xiaotang567/small_car/代码导读_small_car.md

# small_car 固件代码导读

> 目标板：STM32F407VGT6（立创梁山派/天空星引脚布局）+ 总钻风 MT9V034（无 51 版）+ 逐飞 WiFi6B21-SPI
> 当前状态：**188×120 二值图 + 八邻域双边巡线（左右边界数组发给上位机，PC 画红线）**，WiFi 图传稳定（0 坏行），SYSCLK = **168MHz**

---

## 0. 一眼看全：数据怎么流

```
        MT9V034 (188×120, 8bit 灰度)
              │  DCMI（硬件同步 / 8 位 / 极性组1）
              ▼
   cam_image[120][752]  ← DMA 环形缓冲，实际用 188B/行
              │  整块缓冲 = 90240B = 480 行 = 4 帧（cam_ring_rows）
              ▼
      board_cam_harvest()      每轮主循环都跑，突发补行
              │  4:1 纵向抽行（cam_dstep=4）
              ▼
      disp_img[120][188]       ← 显示用的"一整帧"，填满就冻住（bitmap 去重计数）
              │  board_cam_analyze()  采齐后调用一次
              ▼
   二值图(0/255) + cam_bound[120] / cam_bound_r[120]（八邻域爬出来的左右边界）
              │  WiFi SPI：整帧一包(0xFF) + 紧跟一包左右边界数组(0xFD)
              ▼
   PC: cam_view.py  → 拼帧显示；用板子发来的数组画**两条红线**（自己不再算边界）
```

**一句话**：摄像头 → DCMI/DMA 搬进环形缓冲 → 主循环"收割"成 120 行的一整帧 →
MCU 内二值化 + 八邻域双边巡线 → 整帧和边界数组分别发包 → 电脑只负责显示和画红线。

---

## 1. 文件职责

| 文件 | 行数 | 干什么 |
|---|---|---|
| `Core/Src/main.c` | ~1280 | **主循环 + 相位机 + 命令解析 + 心跳**（"调度中心"） |
| `Core/Src/board_f4.c` | ~2260 | **板级驱动**：时钟、DCMI/DMA/收割、SCCB、传感器配置、图像分析、LED |
| `Core/Src/wifi_f4.c` | ~620 | **WiFi 模块驱动**（SPI 协议，对照逐飞官方驱动移植） |
| `Core/Inc/board_f4.h` | ~313 | 板级宏与全局量（`BOARD_HSE_MHZ`、各种可调参数都在这里） |
| `Core/Inc/wifi_f4.h` | ~112 | **WiFi 的 SSID / PC IP / 端口**（网段变了就改这里） |
| `tools/cam_view.py` | ~560 | 上位机：解析包、拼帧、二值图显示、**用板子发来的左右边界数组画红线**、存日志 |
| `Core/Src/ctrl_f4.c` / `Core/Inc/ctrl_f4.h` | ~900 | **车模控制层**（2026-11-05 从 MSPM0G3507 工程移植）：电机 / 编码器 / 幻尔舵机 / MPU9250 / 速度 PID / yaw |

---

## 2. 启动流程（`main()` 里的顺序，别乱换）

```
HAL_Init()
SystemClock_Config()          ← CubeMX 生成的（HSI 16MHz，其实只是过渡）
board_clock_init()            ← ★ 真正的时钟：HSE(8M)+PLL → 168MHz；起不来退回 HSI+PLL 仍 168MHz
MX_GPIO_Init() / MX_DCMI_Init()
board_led_init()
board_cam_init()              ← DCMI + DMA 启动、极性、帧开始
wifi_f4_init()                ← 复位模块 → 连 WiFi → 连 TCP 上位机（**可能阻塞几十秒**）
while(1) { ... }              ← 相位机
```

⚠️ **`wifi_f4_init()` 会阻塞** ⇒ 任何"要很长时间"的代码都不要放在它前面（否则现象是"啥都不动 + WiFi 也连不上"，看不到卡在哪）。

---

## 3. 核心：主循环的相位机（`cam_tx_tick()`）

整个主循环只有 **三个状态**，全靠 `cam_phase` 这一个变量：

| 相位 | 干什么 | 退出条件 |
|---|---|---|
| **相 0「歇」** | 什么都不做，等够 `1000/fps` 毫秒 | 时间到 → 相干清零、进相 1 |
| **相 1「采」** | 专心等"一整帧填满"（`disp_done`） | 采齐 → 调 `board_cam_analyze()`、冻结、进相 2 |
| **相 2「发」** | 默认**整帧一包**（`z 0` 才退回逐行发） | 发完 → **紧跟一包边界数组(0xFD)** → 回相 0 |

### 三个关键设计（都是踩坑换来的）

1. **默认整帧一包**（2894B = 链路 1 个块），`z 0` 才逐行发
   ⇒ 每帧只有一个包开销 ⇒ 帧率上得去；`disp_hold` 在发完前一直冻着 ⇒ 不会发混合帧
2. **采齐才发，绝不超时硬发**
   ⇒ 不会出现"半新半旧的混合帧"（那种帧看起来像一条横线）
3. **自愈：只有"连续 1 秒没有任何新帧"才重启 DCMI**
   ⇒ 无条件每秒重启会把采集压到 1.2fps（亲身踩过）

---

## 4. 采集链（`board_f4.c`）

### 4.1 采集方式：连续 + 循环 DMA
DCMI 一直采，DMA 在 `cam_image` 里**转圈**，不做"采一帧停一下"。好处：
- 不用每次重启 DCMI（重启容易丢同步）
- 帧边界位置由**软件数行号**得到（不依赖 VSYNC 中断）

### 4.2 三个"行数"概念（最容易搞混，务必分清）

| 变量 | 含义 | 当前值 |
|---|---|---|
| `cam_row_bytes` | **摄像头一行多少字节** = 图像宽度 | **188** |
| `cam_span` | **一帧多少行**（回绕 = 帧边界） | **120** |
| `cam_ring_rows` | **环形缓冲能装多少行** = 90240 ÷ 188 | **480**（=4 帧） |

⚠️ 改任何一个都要连带检查另外两个的**使用点**（今天两次栽在这里）。

### 4.3 `board_cam_harvest()` —— 收割（每轮主循环必跑）
- `board_cam_write_row()` 算"DMA 现在写到第几行"
- 从上一行"追"到当前行，边追边拷进 `disp_img`（每 4 行取 1 行 = `cam_dstep`）
- **填行计数用 120 位位图去重**（不是 max/++）
  ⇒ 因为主循环是**突发补行**，一次补几十行，跨过回绕点也不会丢进度 ✓
- 填满 120 行 ⇒ **当场冻住**（`disp_hold=1`，`disp_done=1`）

### 4.4 关键函数

| 函数 | 作用 |
|---|---|
| `board_cam_init()` | 时钟/引脚/DCMI/DMA/极性 一次配好 |
| `board_cam_start()` / `board_cam_restart()` | 启动 / **Stop+Start 重启**（改传感器寄存器后必须调） |
| `board_cam_set_mode(1)` | 切"188 宽"模式：`row_bytes=188`、`span=120`、`dstep=1`、重启 DMA |
| `board_cam_new_pass()` | 新一轮：清计数+位图+标志（**只在相位机里调**） |
| `board_cam_write_row()` | DMA 当前行号（读 NDTR 换算） |
| `board_cam_pclk_khz()` | 借 TIM3 量 PA6 频率（判"传感器活没活/列 bin 生没生效"） |
| `board_vsync_hz()` | 借 TIM4 量 PB7 边沿（判"有没有在成帧"） |

---

## 5. 传感器配置链（SCCB）

### 5.1 总线
- **软件 SCCB**（开漏 + 上拉），挂在 **PC12 / PD2**
- `cam_sccb_init(swap)`：`swap=0` ⇒ SDA=PD2/SCL=PC12；`swap=1` ⇒ **SDA=PC12/SCL=PD2**
- **本板实测是 swap=1**（自动扫描结果 `CAM=2`）

### 5.2 协议（手册 P15~17，曾因写错白忙半天）
- 从机地址：**0x90 / 0x98 / 0xB0 / 0xB8 四个**（本板 **0xB8**）
- **寄存器地址是 8 位（1 字节）**，数据 16 位（2 字节）
- 读：`START + 地址W + 寄存器(1B) + STOP` → `START + 地址R + 高 + 低 + NACK + STOP`

### 5.3 自动探测（`cam_sccb_test()`）
2 种接线顺序 × 4 个地址 = **8 种组合全试**，读 R0x00，高字节 `0x13` 即认为成功。
⇒ 开机自动跑，**不用人敲命令**；成功结果写在心跳 `CAM= / ID= / N=` 里。

### 5.4 上电后自动配置（`cam_sccb_set_bin4()` + `cam_sccb_apply_flip()`）

| 寄存器 | 值 | 为什么 |
|---|---|---|
| `R0x0D` | **0x030A** | [3:2]=2 **列 bin4** + [1:0]=2 **行 bin4** ⇒ 输出 **188×120** |
| `R0x0B` | **150~200** | **快门（单位=行）**。行 bin4 后一帧只有 120 行，**出厂 443 会卡死不成帧** ⚠️ |
| `R0x0D` bit5/bit4 | 按需 | 左右镜像 / 上下翻转（命令 `n` 循环切换） |

⚠️ `R0x0E` 是 **Context B** 的 Read Mode（本芯片跑 Context A）⇒ **写它没用**（踩过）。

### 5.5 图像分析（`board_cam_analyze()`，全部在 MCU 内）
1. **Otsu**：256 级直方图 → 类间方差最大的阈值（自动适应明暗）
2. **二值化**：`≥T ⇒ 255`，否则 0（发出去的就是二值图）
3. **八邻域双边巡线**（`LF_USE_8NEIGHBOR=1`）：
   - `lf_find_seed()`：从下往上找**穿过中心列**的第一条白带（宽 ≥16）当种子，带滞后
   - `lf_trace_left_8()` / `lf_trace_right_8()`：从种子行出发，**向上 + 向下**都沿真实边缘爬
     （八邻域，每行记 `lf_real_l/r` 表示"这一行真爬到了"）
   - `lf_dual_fixup()`：左右互校正（宽度突变剔除 + 缺边补齐）
   - `lf_temporal()`：逐行 (3×本帧 + 上帧)/4 的时域平滑，抑制 1~2px 抖动
   - 结果留在 `cam_bound[]` / `cam_bound_r[]`（0xFF = 这一行没找到）
4. **不再往图里涂白标记**：边界数组由 `app.c` 打包发走，红线在上位机画（见 6.2）

---

## 6. 传输链（`wifi_f4.c`）

### 6.1 初始化（`wifi_f4_init()`）
复位 → 查版本/MAC/IP → 连 WiFi（SSID/密码）→ 连 TCP（PC IP / 8086）→ 设本地端口（6666）

### 6.2 三种报文
| 类型 | 结构 |
|---|---|
| **整帧包**（每帧 1 包） | `AA 55 A5 5A` + `0xFF` + 行数 + 极性\|0x80 + H + 长度(2) + 2 预留 + **120×24 字节位打包像素** + 校验和(2) = 2894B |
| **边界数组包**（紧跟整帧包） | `AA 55 A5 5A` + `0xFD` + 行数 + 预留 + H + 长度(2) + 2 预留 + **每行 2 字节（左x, 右x）** + 校验和(2) = 254B |
| **逐行包**（`z 0` 关掉整帧打包时才用） | `AA 55 A5 5A` + 行号 + W + 极性 + H + err/pin + 载荷 + 校验和(2) |

边界数组包的载荷：`0xFF` = 这一行没找到边界；行序号 0 = 画面最上面一行。
`app.c: cam_send_edges()` 在 `cam_tx_row_done()` 里、`disp_hold` 解冻**之前**发 ⇒
发出去的一定是"这一帧图像对应的那 120 对坐标"。

### 6.3 收发策略（各有一个坑）
- **发送**：`wifi_f4_send()` 先等模块"空闲"（INT 高），**等待上限 300µs**，超时就返回失败
  ⇒ 文字发送再重试 100 次（约 70ms 窗口）⇒ 保证回执能出去
- **接收**：`wifi_f4_read()` 也会**重试蹲空闲窗口**（8 次 × 200µs）
  ⇒ 原来"只试一次"被饿死过 ⇒ `RX` 恒 0，命令全部收不到

---

## 7. 上位机（`tools/cam_view.py`）

| 环节 | 要点 |
|---|---|
| 解析 | 找 `AA 55 A5 5A` → 读包头 → 按**类型字节**分派（`0xFF` 整帧 / `0xFD` 边界数组 / 其它逐行）|
| 拼帧 | `Frame.put(row, px)`，**收满 h 行才更新显示**（否则会看到"爬动的接缝"） |
| 整帧包 | `row == 0xFF` ⇒ 解位打包 → 逐行 `on_row()` → 收满 120 行拍快照并显示 |
| 边界数组包 | `row == 0xFD` ⇒ **校验和通过**才用 ⇒ `on_edges()` 存数组 + **force 重画**（不等 16ms 节流，线和图必须同一帧） |
| 画红线 | `edge_overlay()`：左右各连一条红线（相邻行差 ≤12 才连），每行点一个 S×S 红方块；`None` 行断开不瞎连 |
| 不做的事 | **不做左右转判断**（用户要求）：PC 只把板子给的线画出来 |
| 日志 | 所有文本写 `cam_log.txt`（**排查"到底谁没发"的最终裁判**）|

---

## 8. 命令与心跳字典

### 8.1 命令（发一行文字，回车）
| 命令 | 作用 |
|---|---|
| `f <n>` | 帧率（0 = 不限） |
| `e <n>` | **曝光**（R0x0B 行数，10~110） |
| `n` | 翻转循环：不翻 → 左右镜像 → 上下 → 180° |
| `g <ms>` | 每行发送间隔 |
| `m <0/1>` | 采集模式（0=752 宽 / 1=188 宽） |
| `s` / `a` / `?` | 回状态 / 恢复默认 / 帮助 |
| `d 0/1/2` | 心跳档位（2 = 全量诊断） |
| `b/v/c/i/p/t` | **旧的 UART 配置**（带 51 的摄像头才用，本机忽略） |

### 8.2 心跳 `S ...` 字段
```
S f= V= VS= LG= TO= F= FL= P= RX= CAM= ID= N= MD= BIN= R0D= W= E= K= R= IE= MI= LW= GP= FW=2060 RST=
```
| 字段 | 看什么 |
|---|---|
| `f` | DCMI 帧计数（**要涨**） |
| `F` | 冻结时填了几行（**=120 才对**） |
| `LG` | 收割滞后行数（应远小于 480） |
| `C` | `DCMI->CR`（正常 `4021` = ENABLE+CAPTURE+极性1） |
| `W` | DMA 当前行号（**不变 ⇒ DCMI 没在搬**） |
| `CAM/ID/N` | SCCB 探测结果（`2` + `1324` = 成功） |
| `MD/BIN/R0D` | 模式 / 188×120 配置 / ReadMode 回读（`030A`） |
| `K` | PA6 实测像素时钟（≈1134kHz 正常） |
| `R` | DCMI RISR（FRAME 位应周期性置位） |
| `GP` | 软件数出来的帧率（LINE 间隔识别帧首） |
| `FW` | 固件标签（**2059 及以前没有 0xFD 边界数组包**） |

### 8.2b 状态行 `CFG ...`（敲 `s` 或开机）
```
CFG f= g= x= y= (188x120) d= CST= RV= LINE= FW=2060 EDG= EL= ER=
```
- **`EDG`** = 已经发出去几包边界数组（0xFD）。**在涨 ⇒ 新固件在发数组** ✓
- **`EL` / `ER`** = 最近一包里左 / 右边界各有几行有效（120 = 整幅都爬到了）✓

### 8.3 诊断行 `CAM1 ...`
```
CAM1 f= er= CR= ND= SR= RIS= AFD= DEN= PF= V2= CLK= MHz=
```
- `ND` 钉死 = 一个字节都没搬
- `AFD` = 哪几根 DCMI 引脚没配成 AF13（0 = 全对）
- `V2` = PB7 的 VSYNC 边沿率（0 = 没成帧）
- **`CLK`** = 时钟来源（1=HSE / 2=退回 HSI）+ `MHz` = 实际主频（应为 168）

---

## 9. 调参入口（都在 `board_f4.h` / `main.c` 顶部）

| 参数 | 位置 | 说明 |
|---|---|---|
| `BOARD_HSE_MHZ` | `board_f4.h` | 晶振 8 或 25（**必须和实物一致**，且 `HSE_VALUE` 要同步改） |
| `WIFI_SSID / WIFI_PC_IP / WIFI_PC_PORT` | `wifi_f4.h` | 网段变了改 IP |
| `cam_shutter` | `board_f4.c` | 曝光（默认 150） |
| `cam_flip` | `board_f4.c` | 翻转模式 |
| `cam_cmd_fps / cam_cmd_gap_ms` | `main.c` | 帧率 / 每行间隔（决定传输耗时） |
| `CAM_H / CAM_TXW / CAM_W` | `board_f4.c` | 显示高/宽/缓冲宽（改分辨率就动这里） |

---

## 10. 以后加电机/PID 往哪写

主循环现在是"相位机占满"，加控制建议这样插：

```c
while (1)
{
    ...
    board_cam_harvest();     // 必须每轮跑（时序敏感）
    cam_cmd_poll();          // 必须每轮跑（命令要快）
    cam_tx_tick(...);        // 相位机：发图
    motor_control_tick();    // ★ 新增：电机控制（按 ms 节流，别阻塞）
    ...
}
```

⚠️ 三条铁律：
1. **不要在主循环里做 >1ms 的阻塞操作**（会漏行，`LG` 会飙）
2. 电机 PWM 用 **TIM2_CH3/CH4（PA2/PA3）**，和 DCMI 完全不冲突 ✓
3. 编码器用 **TIM5**（32 位），别用 TIM3/TIM4（要给频率探针留着）

---

## 11. 踩过的坑（浓缩成 12 条规则）

1. **协议要逐字照手册核**（SCCB 是 8 位寄存器地址、四个从机地址）
2. **同名寄存器要连 Context 一起读**（`R0x0D`=A / `R0x0E`=B）
3. **改帧结构要连带所有"以行为单位"的参数**（曝光 443 > 帧长 120 ⇒ 卡死不成帧）
4. **一个概念多处使用时，grep 逐处核对**（行宽 / DMA 长度 / ring_rows）
5. **热路径所有等待必须有上界**（`wait_idle(1000)` 会把主循环按死 1 秒）
6. **发和收要对称重试**（发送重试 40 次、接收只试 1 次 ⇒ 接收被饿死 ⇒ `RX=0`）
7. **自检/自愈必须能自动退场**（`float_probe` / 极性轮换 / 每秒量时钟 / 每秒重启，全是自扰）
8. **"平均类"指标对内容级问题瞎**（用块匹配/相邻相关查重复和接缝）
9. **宁可这一轮不发，也不发混合帧**
10. **关键状态要周期化广播**（"开机瞬间发一次"必丢 ⇒ 放进心跳）
11. **日志文件是"到底谁没发"的最终裁判**（`cam_log.txt` / `netstat`）
12. **改时钟后要重新标定所有空转式软件延时**（SCCB / WiFi 微秒延时）

---

## 12. 2026-11-03 分割线定案：整帧拷贝 + PCLK 门控（硬件）

### 12.1 现象
188×120 画面上有一条**固定高度的横线**（实测在 120 行里的第 43 行）：下方 77 行是新的，
上方 43 行还是上一帧。换极性组时线的位置/形态会变（第 1 组出图但有缝，第 3 组整幅斜）。

### 12.2 软件侧根因（已修）
旧采集是"主循环逐行收割"：一帧 120 行必须在**一个 VSYNC 周期（20ms）内**扫完。
主循环被 WiFi/命令/分析占住几毫秒，就只扫到 70~90 行 ⇒ 下一个 VSYNC 一清计数，
剩下的行就留着上一帧 ⇒ 固定高度的分割线。
⇒ 现在 188 模式改成 **VSYNC 对齐 + 整帧拷贝**：
  - `board_cam_poll()` 只认 **VSYNC 电平上升沿**（FRAME 标志会被 HAL 中断抢走，时刻不固定）；
  - `cam_frame_boundary()` 记下帧首行号；下一次 VSYNC 时把**上一帧 120 行一次性 memcpy**
    进 `disp_img`（约 0.2ms，环里能存 4 帧 ⇒ 绝不会拷到一半被覆盖）；
  - 100ms 没见到 VSYNC 时自动退回"每 120 行滑窗"兜底（不会黑屏，但可能仍有缝）。
  - `CAM_POL_ROTATE` 改为 **0**，固定第 1 组，不再每 0.8s 改一次 DCMI->CR。

### 12.3 最终方案（2026-11-03 21:00，FW=2055，硬件保持不动）
DCMI 自己的 VSYNC 标志一直拿不到（`MI=0000`），但**行中断是正常的**，于是用"行间隔"自己找帧首：

- `HAL_DCMI_LineEventCallback()`：每行结束记一次 DWT 周期数；两行间隔从 ~130µs
  突然变长（场消隐）⇒ 这就是新一帧的第一行 ⇒ 调 `cam_frame_boundary()`；
- 实测 `GP`（识别到的场消隐次数）≈ 帧率（30~70/s）、`FL≈120` ⇒ 帧首对齐成功；
- `board_cam_start()` 末尾**重写一次极性**：`cam_dcmi_force_stop()` 会把 `DCMI->CR` 清 0，
  而 `HAL_DCMI_Start_DMA()` 只补 ENABLE+CAPTURE、**不补 PCKPOL/HSPOL/VSPOL**
  ⇒ 切 188 模式重启后 CR 会掉成 `0x4001`（极性 0）⇒ 现在统一补回 `0x4021`；
- **CROP 默认关闭**（`cam_crop_on=0`）：开了 CROP 后 DCMI 抓完一个窗口就等 VSYNC，
  而 VSYNC 收不到 ⇒ DMA 停在 22560 ⇒ 电脑只收到一张就冻结（实测踩到）；
- TIM6 轮询 `DCMI->SR` 的方案已停用（SR 位在消隐期不更新，`VS` 恒 0），代码保留但不再调用。

### 12.4 看心跳判读（FW=2055）
```
S f= V= VS= LG= TO= F= FL= P= ... LW= GP= FW=2055
```
- `GP` = 场消隐识别次数：≈ 帧率（30~70/s）⇒ **帧首对齐正常**；
- `FL` = 帧长：120 正常；
- `LW` = LINE 中断次数：≈ 120×帧率；
- `V` = DCMI 自己的 VSYNC 中断：可能仍是 0（不影响 LINE-间隔方案）；
- `VS` = TIM6 轮询方案（已停用）恒 0；
- `K` = PCLK 实测：一次开机量一次，仅供参考（1134/1522/5030 都见过，和测量时机有关）。

---

## 13. 2026-11-05 双边巡线：边界数组发给上位机，PC 画红线（FW=2060）

### 13.1 用户的要求
> 用 **8 邻域算法做双边巡线**，把拿到的点**用数组发给上位机**，上位机拿数组**画红线**；
> 左右转之类的判断**先不做**。

### 13.2 板子侧（`cam_f4.c` + `app.c`）
| 位置 | 做什么 |
|---|---|
| `board_cam_analyze()` | Otsu 二值化 → `lf_find_seed` → `lf_trace_left_8` / `lf_trace_right_8`（向上+向下双向八邻域爬）→ `lf_dual_fixup` → `lf_temporal` ⇒ 结果在 `cam_bound[]` / `cam_bound_r[]` |
| `cam_f4.c` | **删掉**"在边界外侧涂 3 像素白"的 `lf_draw_edge_marks()`（那两个竖长方形就是它造成的；红线交给 PC 画，板子保持纯二值图） |
| `app.c: cam_send_edges()` | 整帧包发完后**紧跟一包 0xFD**：每行 2 字节（左x, 右x），0xFF = 没找到；240B + 包头 12 + 校验 2 = **254B** |
| `app.c: cam_tx_row_done()` | 在 `disp_hold = 0` **之前**调 `cam_send_edges()` ⇒ 发出去的一定是这一帧图像对应的坐标 |
| `cmd_f4.c` | `CFG` 状态行加 `FW=2060 EDG= EL= ER=`（确认新固件 + 数组包在发 + 左右各爬到多少行） |

### 13.3 PC 侧（`tools/cam_view.py`）
- 解析器按包头**类型字节**分派：`0xFF` 整帧（位打包 24B/行）、`0xFD` 边界数组、其它逐行（老格式）；
- `0xFD`：校验和通过 ⇒ `on_edges()` 存数组 ⇒ **force 重画**（跳过 16ms 节流，保证"图和线同一帧"）；
- `edge_overlay()`：左右各连一条红线（相邻行差 ≤12 才连），每行点一个 `S×S` 红方块；
  某行是 `None` ⇒ 红线**断开**，不会瞎连一条横跨画面的线；
- **不再自己扫边界**（原来 PC 有一套"从中间往左扫 + 上行±20"的算法，和板子实际用的边界不是同一条线）；
- **不做左右转判断**（用户要求），窗口标题显示 `边包 N (L120/R118)` 可确认收到了几个包。

### 13.4 怎么判断这版生效
1. 敲 `s` ⇒ `CFG ... FW=2060 EDG=<在涨> EL= ER=`；
2. PC 窗口标题右侧 `边包 N (L…/R…)` 在涨；
3. 画面上出现**两条红线**，贴着赛道的左右边；近场（画面下方）也贴着真实边缘走。

### 13.5 2026-11-05 晚：卡死自愈（"运行一段时间图像卡住"）
| 位置 | 改了什么 | 为什么 |
|---|---|---|
| `app.c` 相 2 | **发送看门狗**：一帧超过 `300ms + 行数×gap×2` 还没发完 ⇒ 主动放弃这一帧、解冻收割、回相 0 | 以前 `wifi_f4_send()` 一直失败就**永远重试**，而 `disp_hold` 一直是 1 ⇒ 收割永久停住 ⇒ 画面**永久定格**（只能复位）|
| `app.c` 相 1 | 1 秒没有新帧时**顺手 `disp_hold = 0`** | 万一上面那个冻结状态残留在相 1，也一定解得掉 |
| `cmd_f4.c` | `CFG` 加 `DRP=`（被看门狗放弃的帧数） | 偶尔涨是正常；一直飙 ⇒ 链路/模块发不动 |
| `cam_view.py` | 解析提成 `parse_stream()`，外面套 try/except | 解析里**任何异常**都不会再弄死收数线程（以前一个异常 ⇒ 窗口还在、图永远不动）|
| `cam_view.py` | **先验包长再等数据**（`0xFF` 的 flen 必须是 24 的倍数且 ≤480 行；`0xFD` 的 elen 必须是 2 的倍数） | 错位时假魔数会报出 6 万多字节的长度 ⇒ 一直等一个永远来不齐的包 ⇒ 看起来就是卡死 |
| `cam_view.py` | `tick()` 看门狗：**链路还在进字节、却 3 秒没拼出完整帧** ⇒ 丢缓冲、重找魔数（`RS` 计数） | 兜底自愈，不用重启上位机 |
| `cam_view.py` | 新帧**先不画**，等 0xFD 边包到了"图+红线一起画"（最多等 80ms） | 每帧少一次 GUI 重绘；也不会闪一下旧红线 |
| `cam_view.py` | 每 10 秒**无条件**打一行 `[统计] 帧/无新帧/B\/s/重同步` | 卡住时的判据：`B/s=0` ⇒ 板子没发；`B/s>0` ⇒ 上位机丢同步（会自己恢复）|
| `cam_view.py` | 排查时曾把文本行上限临时放到 240、并在连上后自动发一句 `s`；**查完已撤销**（回到 130 + 不自动发） | 那行 200 字符的 `S ...` 心跳会被 130 的限制整行丢掉 —— 排查"DMA 停摆"时就是靠临时放宽才看见的 |

### 13.6 2026-11-05 晚2：真凶 —— **DMA 停摆**（`ND=22560` 钉死）
用户烧了固件后报"上位机收不到图片"，`CAM1` 每秒打一条：
```
CAM1 f=2196 er=0 CR=4021 ND=22560 SR=0000 RIS=0000 AFD=000 DEN=1 PF=1134k ...
```
判读：
- **`ND`（DMA 剩余字数）恒等于 22560** ⇒ **DMA 一个字节都没搬**（正常在 1..22560 之间乱跳）；
- `f` 每秒只涨 ~10：不是真帧率 —— DMA 不动 ⇒ `board_cam_write_row()` 恒定 ⇒
  `cam_frame_boundary_at()` 算出的帧长恒 0 ⇒ 走 `len<90` 的早退；
  只有 100ms 后 `recent=0` 才走到 `else` 分支 `cam_frame_cnt++` ⇒ **假的 10/s**；
- ⇒ `disp_done` 永远不置位 ⇒ 一张帧都拼不出来 ⇒ **上位机没图**（这也解释了之前"卡住"）。

处理（FW=**2061**）：
| 位置 | 改动 |
|---|---|
| `cam_f4.c: board_cam_poll()` | **DMA 停摆看门狗**：NDTR 连续 400ms 一动不动（且 `cam_mode==1`）⇒ `board_cam_restart()`，计到 `cam_dma_stall` |
| `app.c: cam_tx_tick()` 相 1 | **采集自愈**：连续 2 秒没看到 `disp_done` ⇒ `board_cam_restart()`，计到 `cam_self_heal` |
| `cmd_f4.c` | `CFG` 追加 `DST=`（DMA 停摆重启次数）、`SELF=`（2 秒无帧重启次数）⇒ 正常都应恒 0 |

判读：`DST`/`SELF` 在涨而画面恢复 ⇒ 自动救回来了；一直涨且没图 ⇒ 采集链（传感器输出/接线）真有问题。

---

## 14. 2026-11-05 从 MSPM0G3507 工程移植车模控制层（FW=2062 → 2067）

### 14.1 为什么要有这一节
用户原本用 MSPM0G3507（逐飞库）做车：电机 / 编码器 / 舵机 / 陀螺仪都调通了，
但**那颗片子做不了摄像头**，所以换到 STM32F407。摄像头链路（第 12/13 节）已经稳定，
这一节把原来那套**车控代码**搬过来。

原工程：`...\MSPM0G3507_Library-master\...\Example\Coreboard_Demo\E01_gpio_demo\user\`
（`motor.c` / `encoder.c` / `speed_ctrl.c` / `hx_servo.c` / `mpu9250.c` / `yaw.c`）

### 14.2 新板引脚（嘉立创已打板）
| 功能 | 引脚 | 外设 |
|---|---|---|
| 电机1 / 电机2 PWM | PA2 / PA3 | TIM2_CH3 / CH4（**必须同一个定时器才同频**）|
| 电机1 / 电机2 方向 | PB0 / PB1 | GPIO |
| 编码器 A / B / Z | PA0 / PA1 / PC0 | TIM5_CH1/CH2（编码器模式）/ EXTI0 |
| 幻尔舵机 TX / RX | PC10 / PC11 | UART4，**1Mbps** |
| MPU9250 SCL / SDA | PB8 / PB9 | 软件 I2C |
| OLED SCL / SDA | PB10 / PB11 | 软件 I2C |
| 蜂鸣器 / 按键 | PC1 / PC2、PC3 | GPIO |

⚠️ **DCMI 避让**：TIM3_CH1(PA6)、TIM4_CH1(PB6)、TIM8_CH1(PC6) 全撞摄像头引脚 ⇒
电机只能用 TIM2、编码器只能用 TIM5 —— 这是整套分配的核心权衡。

### 14.3 驱动实现要点（`ctrl_f4.c`）
| 模块 | 要点 |
|---|---|
| 电机 | TIM2 17kHz（84MHz/(4940+1)），占空比 ±10000，DIR 高=正转；**上电先 PWM=0、DIR=0** |
| 编码器 | TIM5 **SMS=011 编码器模式 3**（A/B 每个边沿都数 ⇒ 4 倍频），32 位；**输入滤波 IC1F/IC2F=0110**（原工程 QUAD 没滤波踩过"正反抵消、转速恒 0"）|
| 测速 | 20ms 软件节拍：读 CNT → 清 0 → `RPM×10 = ΔN×600000/(CPR×20)`（**int64**，原工程踩过 int32 溢出）|
| 速度环 | 前馈(5000/1000RPM) + P(1.5) + I(0.15，限幅 2500)，斜坡 3000RPM/s，上限 50%，极性自动识别 |
| 舵机 | 幻尔协议 `FF FF ID LEN INSTR P.. CS`；**改成非阻塞**：发送走环形缓冲 + TXE 中断，接收走 RXNE 中断 + 20ms 解析（原工程是轮询死等，一次几十 ms，会把摄像头主循环按住）|
| 舵机上电 | 等 1 秒 → 写一次 0x2E 目标速度（保持型寄存器）→ 摆到中位 2048 |
| MPU9250 | 软 I2C（PB8/PB9 开漏，半周期 2µs ≈ 250kHz），20ms 读 14 字节；WHO_AM_I 不认识就不再读 |
| yaw | 4 点滑动平均 → 零偏标定（1 秒）→ 80LSB 死区 → 20ms 积分，`deg += rate×0.02/131` |
| 节拍 | `board_ctrl_tick()` 由 `app_loop()` 每轮调，内部 20ms 节流；**绝不阻塞** |
| 中断 | `UART4_IRQHandler` / `EXTI0_IRQHandler` 在 `stm32f4xx_it.c` 转发，优先级 6/7（低于摄像头） |

### 14.4 调试命令（走原来的 WiFi 文本通道，看第 8 节）
```
q <rpm>        速度环目标（0 = 停）          w <d1> <d2>   开环直接给两个电机占空比
r <pos>        舵机位置 0..4095（2048 中位）  l             编码器累计清零
h              一行汇总：enc/d/rpm/yaw/ready/state/duty/servo/err/who
```

### 14.5 上车前必须标定（顺序别乱）
1. **CPR**：不动舵机，手动把轮子转整一圈，看 `h` 里的 `enc` 涨了多少 ⇒ 改 `CTRL_ENC_CPR`（默认 4096）
2. **方向**：`w 2000 0` 看轮子转向；反了就换电机线或改 `CTRL_M1_DIR_INV`；编码器符号反了改 `CTRL_ENC_DIR_INV`
3. **速度环**：从 `q 300` 开始，看 `h` 里的 `rpm`；超调先减 Kp，稳态到不了就加 Ki
4. **舵机**：先 `r 2048` 确认中位，再试两边，**确认机械限位没被顶住**（限位宏 `CTRL_SERVO_POS_MIN/MAX`）

### 14.6 和摄像头共存的三条规矩
1. 控制相关的一切都**不许阻塞**（舵机发送走中断、IMU 一次 0.3ms、其余纯运算）；
2. 控制中断优先级**必须低于**摄像头（DCMI/DMA 是 0~2，这里用 6/7）；
3. 新增控制代码**不许碰** DCMI 那 11 根引脚、DMA2_Stream1、PB7。

### 14.7 OLED（FW=2063）
- 硬件：4 针 SSD1306 128×64，**SCL=PB10 / SDA=PB11**（I2C2 那对脚，但本工程没开 HAL 的 I2C 模块 ⇒ **软件 I2C**）
- 地址：先试 **0x3C**，不应答再试 **0x3D**（两种批次都有）
- **不占 RAM 显存**：直接按"页(page) + 列"写，没有 1KB framebuffer（这个工程只剩 2.4KB RAM）
- API：`ctrl_oled_init()` / `ctrl_oled_clear()` / `ctrl_oled_text(x, page, "str", scale)` / `ctrl_oled_hello()`
  （`scale=1` → 6×8 字体，`scale=2` → 12×16 占两页；字体 5×7 ASCII 32~126 已内置）
- 不亮时先查：模块是不是 4 针 I2C 版、`0x8D 0x14` 电荷泵有没有发出去、地址是 0x3C 还是 0x3D

### 14.8 OLED 状态页（FW=2064）
开机显示 4 行状态（2 倍字，每行占两页）：

| 页 | 内容 | 说明 |
|---|---|---|
| 0-1 | `WiFi OK` / `WiFi --` / `WiFi E<n>` | `--` = 初始化中；`E1` 模块没应答 / `E2` 连不上热点 / `E3` 连不上上位机 |
| 2-3 | `MPU OK` / `MPU <WHO_AM_I>` | `MPU 00` = 压根没读到（查接线/上拉）|
| 4-5 | `ENC 01234` | 编码器累计计数（取模 100000，补零）|
| 6-7 | `RPM  123` | 当前转速（`enc_rpm_x10/10`，带符号）|

实现要点：
- `ctrl_oled_status()` 在 `board_ctrl_tick()` 末尾调用；
- **内容没变就不重画**（`strcmp` 比较 + dirty 位）；
- 每行补空格到 **10 字符 = 120 像素** ⇒ 长度恒定，不会留鬼影；
- 没有 OLED（0x3C/0x3D 都不应答）⇒ `g_oled_ok=0`，状态页整个跳过。

### 14.9 修：状态页"等 30 秒才出现"（FW=2065）
**现象**：上电后屏幕一直停在 `hello world`，差不多 30 秒后才变成状态页。

**根因**（不是 OLED 的错）：`ctrl_all_init()` 在 `wifi_f4_init()` **之前**调用，
而后者要复位模块 → 连热点 → 连 TCP，最长**阻塞几十秒**；
在它返回、`app_loop()` 跑起来之前，`board_ctrl_tick()` 根本没执行过 ⇒ 状态页当然不刷新。

**改法**：
1. 去掉 "hello world" 那 1 秒，改成**开机就在 `ctrl_all_init()` 里整页画一次**
   （`ctrl_oled_first_page()`，4 行全画 ≈ 34ms）⇒ 上电立刻能看到；
2. WiFi 那行增加中间态 `WiFi --`；
3. 之后主循环跑起来，`ctrl_oled_status()` 才做增量刷新。

⚠️ 教训：**凡是"要等主循环跑起来才会更新"的东西，都不能当成开机自检画面** ——
先查 `main()` 里在那之前有没有阻塞调用。

### 14.10 OLED 刷新提速（FW=2066）
| 问题 | 原来 | 现在 |
|---|---|---|
| 软 I2C 太慢 | 半周期 2µs ⇒ 250kHz，一行两页 ≈ **8.6ms** | 半周期 **1µs** ⇒ 约 450kHz，一行 ≈ **4ms** |
| 文字更新太慢 | **4Hz**（250ms） | **10Hz**（100ms）|
| 补画排得太保守 | 每 20ms 拍只画 **1 行** ⇒ 4 行要 80ms | **一次把脏行全画完**（最多 4 行 ≈ 16ms）|

参数：`CTRL_OLED_I2C_DELAY_US`（1，花屏就改回 2）、`CTRL_OLED_TEXT_MS`（100）。
摄像头环形缓冲能存 80ms，16ms 的阻塞不会丢帧；正常只有 ENC/RPM 两行在刷。

---

## 15. 2026-11-06 控制台 `tools/car_ui.py`（图像 + 仪表 + 按钮）

### 15.1 全按钮，不用敲命令
| 区块 | 控件 |
|---|---|
| 图像源 | **[二值图]** **[原图灰度]** 两个按钮（选中变绿），下面一行显示当前模式 |
| 实时数据 | 转速（大字）/ 加速度 / 角速度 / 偏航角 / 舵机位置（10Hz，断流 2 秒变 `---`）|
| 电机1 | 两种方式二选一：**占空比 %**（默认，滑条 0~100，默认 **30%**，开环不依赖编码器）/ **转速 RPM**（走速度环闭环）<br>**[启动] [停止]**（上电默认停）+ **[前进]/[后退]** 只选方向 + 快捷档（10/20/30/50% 或 300/600/1000/1500 RPM）+ 滑条（松手才发）|
| 舵机角度 | **[左] [中] [右]** + **[−20] [+20]** + 滑条（松手才发）|
| 其它 | **[编码器清零]** **[紧急停止]**（红）|
| 日志 | 底部显示板子的 `ACK/CFG/CAM` 回话；界面标签里**不出现任何命令语法** |

按钮按下后固件收到的还是原来那几条命令（`s 0/1`、`q <rpm>`、`r <pos>`、`l`、`w 0 0`），
只是用户完全不用知道它们。

用法：**双击 `tools/run_car_ui.bat`**（自动找 Python 并监听 8086），或 `python car_ui.py [端口]`。
和 `cam_view.py` 一样是 TCP 服务端，**两个别同时开**。

⚠️ 电机安全：**上电默认停止**（固件里速度环目标 = 0、PWM = 0），上位机也默认"未启动"。
点 **[启动]** 才按"方式 × 方向 × 滑条值"驱动电机1：
- **占空比**方式发 `w ±(滑条%×100) 0`（30% → 3000，开环，不依赖编码器）
- **转速**方式发 `q ±RPM`（闭环，需要编码器读数正确）
点 **[停止]** 或 **[紧急停止]** 会同时发 `q 0` 和 `w 0 0`（两路占空比直接清零，双保险）。
方向按钮本身**不发命令**，只是选方向；运行中改方向会立刻按新方向重发。
切换方式时会先把手头那个方式清零（PWM→RPM 发 `w 0 0`，RPM→PWM 发 `q 0`）。

### 15.2 为此新增的两条协议
**① 灰度缩略图包（0xFC）** —— 只在 `cam_view_mode=0`（原图模式）时发
```
AA 55 A5 5A | 0xFC | 块号 | 0 | 本块行数 | 长度高 低 | 2B 预留 | 数据 | 校验高 低
```
- 数据 = `disp_img`（188×120 灰度）**2×2 抽取** ⇒ 94×60，**分 8 块**（每块 94×8 = 752 字节）
- **为什么分块**：整张 5640 字节超过 WiFi 模块一次 SPI 事务上限 4088，一次发不完就是半个包 ⇒ 字节流错位
- **为什么必须在 `board_cam_analyze()` 之前发**：分析会把 `disp_img` **原地二值化**，发晚就拿不到灰度了
- 原图模式下**不走相 2**：灰度包在相 1 里一次发完（约 30~50ms，此时 `disp_hold=1` 收割冻着），发完直接回相 0

**② 遥测行（10Hz 文本）**
```
T r=<转速RPM> ax= ay= az= gx= gy= gz= <原始LSB> y=<偏航角, 单位0.1°> s=<舵机位置> m=<图像模式>
```
`m=1` 二值图 / `m=0` 原图；上位机只按 `key=value` 取，加字段不用改解析骨架。

### 15.3 固件命令新增
```
s           回状态（原来就有）
s 0         原图（灰度 94×60）
s 1         二值图（188×120，默认）
```

### 15.4 注意
- 原图模式带宽是二值的 **2 倍**（5640B vs 2894B/帧）⇒ 帧率会掉一半左右，这是正常的；
- 灰度只有 94×60，**看曝光/阈值够用，看细节不行**；要细节还是用二值图；
- 上位机切换时会先切显示再发命令，不然要等遥测回来才变；
- 板子没烧这版固件时：图像正常、仪表全是 `---`、点"原图"没反应 —— 属正常（没有 0xFC/T 包）。
