xiaotang567/small_car/舵机读取问题说明.md

# 舵机读取问题说明

> 文档目的：把「舵机位置一直读不到」这件事**说清楚** —— 现在的现象是什么、已经用证据确认了什么。
> 编写时间：2026-11-06　对应固件：**FW=2095**（`MDK-ARM/small_car/small_car.hex`）

---

## 0. 一句话概括

**单片机确实按官方协议、以 1 Mbps 把「读当前位置」的帧发到了总线上，但一个应答字节都没有收回来；而同一套舵机和调试板接电脑时能正常读出位置。**

---

## 1. 硬件与参数（当前配置）

| 项目 | 内容 |
|---|---|
| 舵机 | 幻尔 **HX-10HM** 磁编码总线舵机（12 位，0~4095 对应 0~360°）|
| 舵机默认 ID | **1**（出厂值，手册第 5 页；ID 范围 0~253）|
| 舵机供电 | 独立 12V（9~12.6V），与板子**共地** |
| 调试板 | 幻尔 **BusLinker V3.0**，跳线帽置于 **Servo + TTL** |
| 单片机侧 | STM32F407，**PC10 = UART4_TX，PC11 = UART4_RX**（AF8）|
| 波特率 | 1 Mbps（协议文档 + 规格表 + 官方例程）|
| 协议 | `FF FF ID LEN CMD 参数… CS`，`CS = ~(ID+LEN+CMD+参数…)` |

### 读位置的帧（固件实际发出的，和官方文档逐字节一致）

```
发送：FF FF 01 04 02 38 02 BE      ← 读 ID1 的 0x38 寄存器 2 字节
应答：FF FF 01 04 00 18 05 DD      ← ERROR=0，位置 0x0518 = 1304
```

校验和验算：`~(0x01 + 0x04 + 0x02 + 0x38 + 0x02) = ~0x41 = 0xBE` ✓
（出处：《幻尔HX-10HM总线舵机通信协议文档》1.3.2 节，第 3 页）

---

## 2. 现在的现象（当前固件 FW=2095）

| 观察点 | 读数 | 说明 |
|---|---|---|
| 上位机「舵机」行 | `--- (ID 1, 1M, 发xxB 收0B 校验错0)` | **发得出去，收不回来** |
| `发` / `st` | 持续增长（每秒几十字节）| 发送环 + TXE 中断 + UART4 正常工作 |
| `收` / `sr` | **0** | RXNE 中断一次都没被触发（或确实没有电平变化）|
| `校验错` / `sb` | 0 | 没有收到"错误的数据"，是一个字节都没有 |
| 舵机动作 | 无 | 说明舵机也没收到合法指令（否则会转动/绷紧）|
| 电脑读舵机 | **正常**，能读到 ID 和位置 | 舵机、舵机线、BusLinker、12V 供电都正常 |

---

## 3. 已确认的事实（都有实测证据）

| # | 结论 | 证据 |
|---|---|---|
| 1 | 舵机本体、舵机线、BusLinker 的 USB 通路、12V 供电**都正常** | 用电脑 + ServoStudio/BusLinker 能正常扫描到舵机并读到位置 |
| 2 | 单片机 UART4 的**发送**通路正常 | `发/st` 计数随每次读位置稳定增长 |
| 3 | 单片机 UART4 的**接收**通路正常 | 把 **PC10 与 PC11 直接短接**做回环，`收` 立刻从 0 涨到 200B 左右 |
| 4 | 发送的**帧内容正确** | 与协议文档 1.3.2 的示例逐字节一致（含校验和 0xBE）|
| 5 | **不是波特率问题** | 固件已自动扫过 1M / 115200 / 500k / 250k / 57600 / 38400 / 19200 / 9600 / 10000 / 4800 共 10 档 |
| 6 | **不是 ID 问题** | 固件已自动扫过 ID 0~20，且舵机出厂 ID 就是 1 |
| 7 | **不是协议/校验和问题** | 与官方文档、官方 STM32 例程（`Serial_Servo`）完全一致 |
| 8 | **不是 MCU 外设配置问题** | 引脚 AF8、BRR、CR1、NVIC、TXE/RXNE 中断、环形缓冲均经回环测试验证 |
| 9 | **不是共地问题** | BusLinker GND ↔ 单片机 GND 实测 **0Ω** |
| 10 | **不是舵机噪声把 CPU 吃干** | 已加"每拍最多处理 256 字节 + 触发就静默 500ms"的保护，且遥测问题是另一回事（已单独修复）|
| 11 | **不是图传占满链路** | 固件已支持 `s 2` **默认停图传**，链路只剩文本时，舵机读数依旧为 0 |
| 12 | **不是上位机解析问题** | 用"图像包 + 遥测行"随机切块的混流测试，遥测 5/5 全部解析正确 |

---

## 4. 已经排除的方向（不要再往这些方向查）

- ❌ 波特率不对
- ❌ 舵机 ID 不对
- ❌ 协议格式 / 校验和 / 字节序不对
- ❌ MCU 的 UART 外设、引脚复用、中断没有配置好
- ❌ 没有共地
- ❌ 图传抢带宽 / 文本队列把遥测饿死（这两条是**另一个**问题，已在 FW=2095 修复）
- ❌ 上位机文本解析丢行
