xiaotang567/small_car/教学文档_图传优化与单边巡线.md

# 图传优化 + 单边巡线 · 教学文档（对照真实代码）

> 工程：`C:\Users\SHUIGUI\Documents\small_car`（F407 + 总钻风 MT9V034 无51版 + WiFi SPI）
> 每个方法都标了 **代码在哪**，并写清 **改哪个参数 → 什么现象**，验收时按这个讲即可。

---

# 一、先讲链路（一张图 + 对应代码）

| 环节 | 代码位置 | 说明 |
|---|---|---|
| 采集 | `board_f4.c → board_cam_init / board_cam_start` | DCMI 硬件同步、8bit、极性 VSYNC 低 / HREF 高 / PCLK 上升沿 |
| DMA | `board_f4.c:2233` 起 `hdma_dcmi.Init` | `DMA2_Stream1 / Ch1 / WORD↔WORD / CIRCULAR / FIFO 关闭` |
| 环形缓冲 | `board_f4.c → cam_image[120][752]`（实际按 188B/行用，整块 90240B = 480 行 = 4 帧）| `cam_ring_rows` 由此算出 |
| 收割 | `board_f4.c → board_cam_harvest()` | 每圈主循环补行；`dst = (disp_next_row % 120)`；位图去重计数，填满 120 行即冻结 |
| **像素操作层** | **`disp_img[120][188]`**（`board_f4.c` 全局）| **0 = 黑，255 = 白**；所有画线/找边界都在这上面 |
| 分析 | `board_f4.c → board_cam_analyze()` | Otsu（1806~1832）→ 原地二值化（1839）→ 每行找交界列（1845）|
| 发送 | `main.c:856 起 if (cam_pack) { fpkt... } else { 逐行包 }` | 打包时**整帧一包**（`fpkt[4]=0xFF`，长度在 `fpkt[8..9]`）|
| 上行 | `wifi_f4.c → wifi_f4_send()` | SPI2 + 模块；断链自动重连（零进展计数）|
| 显示 | `tools/cam_view.py` | 识别 `0xFF` 整帧包 / 逐行包，解包后显示 |

**一句话**：摄像头 → DMA 环形缓冲 → 收割成 `disp_img` → 二值化 → 打包发出去 → 电脑显示。**像素操作只发生在 `disp_img` 上。**

---

# 二、帧率优化（四种手段，全部对应代码）

## 2.0 时间花在哪（先算账，再动手）

```
一帧 = 120 行 × 188 像素 = 22560 像素
不打包：22560 B + 120 包 × 12B 包头 ≈ 24 KB
位打包： 2880 B + 120 包 × 12B 包头 ≈ 4.3 KB   （整帧一包时只剩 1 个包头）
一帧耗时 ≈ 包数 × 每包固定开销(1~2ms) + 数据量/带宽 + 帧间隔
```

`120 包 × 1~2ms = 120~240ms` ⇒ **包数才是最大头**，不是字节数。

## 2.1 手段一：减少**包数**（收益最大）

**代码**：`main.c:856` 起 `if (cam_pack) { ... fpkt ... }` —— 现在就是**整帧一包**

```c
static uint8_t fpkt[12U + 120U * 24U + 2U];   // 全帧：2894B，静态分配别放栈
fpkt[4] = 0xFF;                 // 类型：整帧包
fpkt[5] = (uint8_t)txh;         // 行数
fpkt[6] = dbg_pol_idx | 0x80;   // 极性 + 位打包标志
fpkt[8..9] = 载荷长度;          // 2 字节长度（2880）
wifi_f4_send(fpkt, 12 + flen + 2);
```

| 改这里 | 现象 |
|---|---|
| `cam_pack = 1`（`main.c:167`）| 走整帧一包 ⇒ **帧率最高**（包开销几乎消失）|
| `cam_pack = 0`（命令 `z`）| 退回逐行 120 包 ⇒ 帧率掉到 5~7fps，**但兼容性最好**（排障用）|
| ⚠️ 已知坑 | 大包万一"模块忙"只发一半，上层再从头发 ⇒ 上位机收到"半包+整包" ⇒ **数据整体错位 = 竖线**；正解是"续发剩余字节"或"一个字节都不发" |

## 2.2 手段二：减少**字节数**（位打包）

**代码**：`main.c` 打包循环 `byte |= 1 << (7 - k)`；包头 `pkt[6]/fpkt[6]` 最高位置 1

| 改这里 | 现象 |
|---|---|
| `cam_pack = 1` | 每行 188B → **24B**，一帧 24KB → 2.9KB |
| 位打包关闭（`z`）| 回到 188B/行，画面一样（都是 0/255），但慢 5~8 倍 |
| 传感器 binning（`board_f4.c → cam_sccb_set_bin4`，`R0x0D=0x030A`）| 列/行各 4:1 ⇒ 输出 188×120；改小 bin ⇒ 分辨率↑、数据量↑ |

## 2.3 手段三：**间隔参数**（命令行直接调，改完立刻看到）

**代码**：`main.c:84` `cam_cmd_fps`、`main.c:85` `cam_cmd_gap_ms`、命令 `f` / `g`

| 参数 | 当前值 | 改大 | 改小 |
|---|---|---|---|
| `g <ms>` 每行间隔 | **0**（`main.c:85`）| 更稳、更慢（6 ⇒ 一帧多 720ms）| 更快；0 = 不等；**太小会出现"坏"计数上涨** |
| `f <n>` 帧率上限 | **0 = 不限**（`main.c:84`）| 更慢（1 ⇒ 每帧多等 1s）| — |
| 命令 | `g 1` / `g 2` / `f 10` | — | — |

> **演示口诀**：`z`（打包关）→ 看着变慢；再 `z`（开）→ 变快。`g 6` → 明显卡；`g 0` → 明显快。

## 2.4 手段四：减少主循环阻塞（这条最容易被忽略）

**代码**：`wifi_f4.c → wifi_f4_send_string()`（文本重试次数）、`main.c` 心跳守卫

| 改这里 | 现象 |
|---|---|
| 文本重试 100 次（每次 ~700µs）| 心跳时主循环被按 **70ms** ⇒ 收割滞后 `LG` 飙升 ⇒ **画面掉行/接缝** |
| 降到 10 次 | 主循环最多被按 7ms ⇒ `LG` 稳定 |
| 发帧期间插心跳文本 | 文本字节落进二进制包 ⇒ **整帧错位（竖线）** ⇒ 发帧期间跳过心跳 |

## 2.5 帧率诊断顺序（照这个查，不要瞎调）

1. 看图左上角 **`FPS=`**（单片机画的，`board_cam_draw_fps_text`）
2. **`坏`** 在涨 ⇒ 模块跟不上 ⇒ `g 1`
3. **`LG`** > 100 ⇒ 主循环被阻塞 ⇒ 查 2.4
4. **`F`** ≠ 120 ⇒ 采集不稳（供电/DCMI 同步）
5. 都正常还慢 ⇒ 包数/字节没减 ⇒ 回 2.1 / 2.2

---

# 三、像素点操作（巡线的基础，全部是真实写法）

## 3.1 唯一的战场：`disp_img[行][列]`

```c
disp_img[r][c]        // 0 = 黑，255 = 白（board_cam_analyze 二值化后）
```

| 操作 | 代码 |
|---|---|
| 读 | `uint8_t v = disp_img[r][c];` |
| 涂白 | `disp_img[r][c] = 255U;` |
| 涂黑 | `disp_img[r][c] = 0U;` |
| 反色（把线"挖"出来）| `disp_img[r][c] ^= 0xFFU;` |
| 粗一点的点 | `disp_img[r][c] = disp_img[r+1][c] = disp_img[r][c+1] = 255U;` |

⚠️ **越界是死机第一杀手**：`r ∈ [0,119]`、`c ∈ [0,187]`，画之前先夹范围。

## 3.2 代码里已有的三个"像素操作范例"（`board_cam_analyze`）

**① Otsu 直方图（1806~1832）**

```c
for (i = 0; i < 256U; i++) { hist[i] = 0U; }
for (i = 0; i < total; i++) { hist[base[i]] ++; }      // 统计
...
cam_thresh = T;                                        // 类间方差最大者的阈值
```

**② 原地二值化（1839）**

```c
for (c = 0U; c < (uint32_t)CAM_TXW; c++) { row[c] = (row[c] >= T) ? 255U : 0U; }
```

**③ 逐行找交界（1845）**

```c
if ((row[c] != row[c-1]) && (row[c] == row[c+1]) && (row[c] == row[c+2]))
{ bound = (uint8_t)c; break; }        // 第一个"稳定跳变"列
cam_bound[r] = bound;                  // 0xFF = 该行没找到
```

> 这三段就是"**对像素点操作**"的完整闭环：**统计 → 改值 → 按值找特征**。

## 3.3 画"连续线"的关键：**逐行补点插值**

只画孤立的点，屏幕上是**虚线**；要在斜边也连续，必须把相邻行之间补满：

```c
/* b[] = 每行边界列（0xFF = 没找到） */
for (r = 1; r < 120; r++)
{
    uint8_t b0 = b[r-1], b1 = b[r];
    if (b0 == 0xFF || b1 == 0xFF) continue;          /* 有一行缺失就跳过，别乱连 */
    int step = (b1 >= b0) ? 1 : -1;
    int n    = (b1 >= b0) ? (b1 - b0) : (b0 - b1);
    for (int i = 0; i <= n; i++)
        disp_img[r][b0 + i * step] = 255U;           /* 想画黑线就写 0 */
}
```

| 写法 | 屏幕现象 |
|---|---|
| 只画 `b[r]` | 斜着看**断断续续** ✗ |
| 按上面插值 | **一条连续折线**贴着赛道边 ✓ |
| 相邻行 `b` 跳变 > 20 | 线会"突然跳一下" ⇒ 对 `b[]` 做限幅（超过 10 就沿用上一行）|

```c
/* 限幅：抑制跳点，让线连续 */
if (b[r] != 0xFF && b[r-1] != 0xFF && abs(b[r] - b[r-1]) > 10) { b[r] = b[r-1]; }
```

## 3.4 单边边界提取（下周要写的）

```c
/* 单边（以左边界为例）：从画面中间往左找"白→黑" */
for (r = 0; r < 120; r++)
{
    uint8_t b = 0xFF;
    for (c = 94; c > 2; c--)
    {
        if (disp_img[r][c] == 255U && disp_img[r][c-1] == 0U) { b = c; break; }
    }
    b_bound[r] = b;
}
```

| 参数 | 现象 |
|---|---|
| 起点 94（画面中间）| 往中间挪 ⇒ 线更贴中心；太靠边会找不到 |
| 跳变方向（白→黑 / 黑→白）| 决定抓左边界还是右边界（要跟赛道配色一致）|
| 防抖要求（连续 2~3 像素同向）| 加严 ⇒ 更稳、漏行↑；放松 ⇒ 毛刺↑ |

## 3.5 单边 → 中线 → 打角

```
L[r]（单边） → 取远景/近景两行 → 中线 C[r] = L[r] + 半赛道宽（标定值）
→ 偏差 e = Σ w[r]·(C[r] − 94) → 舵机 = 中值 + Kp·e
```

| 参数 | 现象 |
|---|---|
| 取哪几行（如 90/70/50 行）| 看得远 ⇒ 提前打角；看得近 ⇒ 迟钝 |
| `Kp` 大 | 左右摇摆（震荡）|
| `Kp` 小 | 转不过来、切内道 |
| 半赛道宽标错 | 车一直偏一侧 |

---

# 四、参数 → 现象 总表（验收必问）

| 参数 | 代码位置 | 增大 | 减小 |
|---|---|---|---|
| `g` 行间隔 | `main.c:85` / 命令 `g` | 慢、稳 | 快；0=不等；太小"坏"涨 |
| `f` 帧率 | `main.c:84` / 命令 `f` | 慢 | 快（0=不限）|
| `cam_pack` 位打包 | `main.c:167` / 命令 `z` | — | 退回 188B/行 |
| `e` 曝光（R0x0B 行数）| 命令 `e` / `cam_shutter`（150）| 亮、运动模糊↑ | 暗；**太小/太大都会让传感器不出帧** |
| `R0x0D` bin（0x030A）| `cam_sccb_set_bin4` | 分辨率↓、数据↓ | 分辨率↑、数据↑ |
| `VSPOL/HSPOL/PCKPOL` | `MX_DCMI_Init`（低/高/上升）| 极性错 ⇒ **完全没图** | — |
| 摄像头高度/俯仰 | 机械 | 看得远 | 看得近 |
| `Kp` | 巡线代码 | 震荡 | 转不过来 |

---

# 五、讲给学长听的顺序（照着念就不卡壳）

1. **链路**：摄像头 → DMA 环形 → `disp_img` → 二值化 → 打包 → WiFi → 上位机
2. **帧率三笔账**：包数（120 包×1~2ms）、字节数（24KB→2.9KB）、间隔（g/f）
3. **每讲一个手段就报参数与现象**（用第四节总表）
4. **现场演示像素操作**：在 `board_cam_analyze` 末尾画一条横线 → 屏幕上立刻出现
5. **单边巡线**：为什么先单边 → 边界提取 → 插值画连续线 → 中线 → 打角

---

# 六、你可能遗漏的点（先自己过，再挑去问学长）

| # | 问题 | 为什么必须问 |
|---|---|---|
| 1 | 赛道**元素**怎么处理：十字、断路、坡道、环岛 | 单边在十字会"找不到边" |
| 2 | **双边**的 bug 具体是什么 | 决定以后修不修双边 |
| 3 | 中线取**哪几行**、权重 | 决定打角时机 |
| 4 | **半赛道宽**怎么标定 | 标错车一直偏 |
| 5 | **舵机中值/限幅** | 防打死烧舵机 |
| 6 | 电机开环还是编码器闭环、死区多少 | 决定要不要做速度环 |
| 7 | **帧率 vs 曝光**取舍（运动模糊）| 全局快门缓解但仍要平衡 |
| 8 | 二值化用全局还是分区 | 光照不均时必需分区 |
| 9 | 摄像头**安装高度/俯仰** | 直接决定视野与调参 |
| 10 | 上位机要不要**录制/回放** | 离线调参效率差很多 |
| 11 | 赛道是**黑底白线**还是白底黑线 | 决定跳变方向与极性 |
| 12 | 规则对**图像处理位置**有没有限制 | 决定算法放 MCU 还是 PC |

---

# 附：下周节奏

| 天 | 目标 | 验收标准 |
|---|---|---|
| D1 | 单边边界稳定 + 连续画线 | 屏幕上一条连续的线跟着赛道 |
| D2 | 中线 + 打角（`Kp` 从 0.3 起调）| 静态推车，轮子朝弯道 |
| D3 | 加电机低速跑（开环）| 不切内道、不蛇形 |
| D4 | 十字/断线处理（丢边沿用上一行）| 过十字线不跳 |
| D5 | 提速 + 记录数据 | 给学长演示 + 数据对比 |
