xiaotang567/small_car/硬件引脚核验_2026-10-16.md

# STM32F407 主板引脚分配 · 核验报告

> 核验方式：**以手上正在跑通（188×120 图传稳定 + 0 坏行）的固件实况为准**，逐项对照数据手册复用表。
> 结论：**这套分配整体正确，可以照画**；下面列出 3 处必须注意、以及 168MHz 迁移前必须同步修改的地方。

---

## 一、DCMI 摄像头接口（表 1）✅ 全部正确

| 信号 | 你的分配 | 核验 |
|---|---|---|
| D0~D3 | PC6 / PC7 / PC8 / PC9 | ✅ AF13 正确 |
| D4 | **PE4** | ✅ 正确（备选是 PC11 —— 你避开了，见下） |
| D5 | PB6 | ✅ 正确 |
| D6 | **PE5** | ✅ 正确（备选 PB8 —— 避开了 ✓） |
| D7 | **PE6** | ✅ 正确（备选 PB9 —— 避开了 ✓） |
| HREF | PA4 | ✅ 正确 |
| PIXCLK | PA6 | ✅ 正确 |
| VSYNC | PB7 | ✅ 正确 |

**这是当前固件里正在工作的同一组 11 根脚** —— 固件自检项 `AFD=000`
（11 根引脚 MODER+AFR 全部配成 AF13 通过）指的就是它 ✓

### 🔑 你的"设计要点 1"完全成立
DCMI 的 D4/D6/D7 各有**两个备选脚**（PC11 / PB8 / PB9），你选了 **PE4 / PE5 / PE6**，
正好把

- **PC11 让给 UART4**（幻尔舵机）
- **PB8 / PB9 让给 I2C1**（MPU9250）

⇒ 这一手是整套分配成立的核心，判断正确 ✓

---

## 二、其余外设（表 2）✅ 基本正确，3 处提醒

| 功能 | 你的分配 | 核验结论 |
|---|---|---|
| 电机1 PWM/DIR | PA2 (TIM2_CH3) / PB0 | ✅ 合法（AF1）；**PWM 同定时器**这条要求正确 ✓ |
| 电机2 PWM/DIR | PA3 (TIM2_CH4) / PB1 | ✅ 合法 |
| 编码器 A/B/Z | PA0 (TIM5_CH1) / PA1 (TIM5_CH2) / PC0 (EXTI) | ✅ 合法；**TIM5 是 32 位定时器**，做编码器很合适 ✓ |
| 幻尔舵机 | PC10 (UART4_TX) / PC11 (UART4_RX) | ✅ 合法（AF8） |
| MPU9250 | PB8 (I2C1_SCL) / PB9 (I2C1_SDA) | ✅ 合法。F4 上 I2C1 有 **PB6/PB7 与 PB8/PB9 两套**映射，**不需要 remap** ✓ |
| OLED | PB10 (I2C2_SCL) / PB11 (I2C2_SDA) | ✅ 合法；⚠️ **I2C 必须外部上拉**（模块一般自带，画板时确认） |
| WiFi | PB13/14/15 (SPI2) + PB12 (CS) | ✅ **与当前固件 `wifi_f4.h` 的宏定义完全一致** ✓ |
| WiFi INT/RST | PD8 / PD9 | ✅ **与固件一致** ✓ |
| 摄像头配置口 | PC12 / PD2 | ⚠️ **见下面第 1 条重要提醒** |
| 蜂鸣器 | PC1 | ✅ 可用；⚠️ GPIO 直推蜂鸣器电流可能不够 ⇒ 建议加三极管/MOS |
| 按键 ×2 | PC2 / PC3 | ✅ 可用（内部上拉即可） |
| 调试 SWD | PA13 / PA14 | ✅ 保留 |
| 打印 USART1 | PA9 / PA10 | ✅ 无冲突 |

### ⚠️ 提醒 1（最重要）：`PC12/PD2` 对你这块摄像头**不是 UART5**
你手上这颗总钻风是 **"无 51"版**（`U3` 焊盘空 + **R12/R13 焊了** + R10/R11/R14/R15 空），
⇒ 那两根脚接的是**传感器自己的 SCCB（I2C）**，不是串口。

- **硬件**：按普通 GPIO（或硬件 I2C）布线即可，**不必当 UART5 用**
- **固件**：当前就是**软件 I2C（开漏 + 上拉）挂在 PC12/PD2** 上工作的 ✓
- 表格里 "UART5" 的标注只适用于**带 51 芯片**的版本

### ⚠️ 提醒 2：WiFi 的 `CS(PB12)` 必须是 **GPIO**
逐飞驱动是**软件拉 CS** 的 ⇒ **不要在 CubeMX 里把 PB12 配成 SPI2_NSS(AF5)**，
保持普通输出 GPIO ✓（同理：SPI2 本身**当前固件是自己配的**，CubeMX 里不配也不影响运行）

### ⚠️ 提醒 3：编码器电平
编码器要 **5V 供电**才有信号，而 **PA0/PA1/PC0 不是 5V 容忍脚**
⇒ 三根信号线各**串 1k~2.2k**（或加电平转换）✓ —— 这是之前踩过的坑

---

## 三、片上资源（表 3）✅ 正确，补齐一项

| 资源 | 用途 | 核验 |
|---|---|---|
| TIM2 | 两路电机 PWM | ✅ 同频要求正确 |
| TIM5 | 编码器接口（32 位） | ✅ |
| I2C1 / I2C2 | MPU9250 / OLED | ✅ |
| SPI2 | WiFi | ✅ |
| UART4 / UART5 | 舵机 / 摄像头配置 | ✅（UART5 的用途见提醒 1） |
| USART1 | 调试打印 | ✅ |
| **DMA2_Stream1** | 摄像头 DCMI | ✅ 当前固件用的就是这一路（表里可补上具体 stream） |
| TIM3 / TIM4 | （固件自检用） | 说明：固件用 **TIM3_CH1(PA6)**、**TIM4_CH2(PB7)** 做频率探针（临时借用后归还）⇒ 画板**不要**把这些脚另作他用 |

---

## 四、三个待确认项（表 4）—— 已用固件实况核实

| # | 项目 | 核实结果 |
|---|---|---|
| 1 | **晶振频率** | 代码里两处**一致**：`BOARD_HSE_MHZ = 8`（board_f4.h）+ `HSE_VALUE = 8000000`（stm32f4xx_hal_conf.h）✓；`.ioc` 里的 25MHz 是历史遗留 ✗<br>**实物到底是不是 8MHz，看诊断行 `CLK=`**：`1` = HSE 起表了（说明晶振=8MHz 正常），`2` = 晶振没起来退回了 HSI ✗ |
| 2 | **SYSCLK** | ✅ **实际是 168MHz（不是 16MHz —— 此前结论有误，已订正）**：<br>`SystemClock_Config()` 之后 `main()` 还调了 **`board_clock_init()`** —— 先试 HSE+PLL（M=8/25, N=336, P=2 ⇒ **168MHz**），**HSE 起不来就退回 HSI+PLL，仍然是 168MHz**。<br>实际用了哪个源看 `board_clock_src`（1=HSE / 2=退回HSI）；诊断行现在会报 `CLK= MHz=` ✓ |
| 3 | **DCMI.VSPolarity** | ✅ 总钻风选 **Low 正确**。当前能出图的那组就是：<br>`VSPolarity = LOW` / `HSPolarity = HIGH` / `PCKPolarity = RISING` —— **照抄即可** |

---

## 五、⚠️ 已经跑在 168MHz（下面两处延时就是按 168MHz 标定的）

| # | 位置 | 为什么 |
|---|---|---|
| 1 | **软件 SCCB 延时 `sccb_dly()`**（空转 600 次） | 16MHz 下 ≈40kHz 正合适；**168MHz 下会变成 ≈250kHz** ⇒ 内部 40k 弱上拉来不及 ⇒ **SCCB 读不到 ACK**（今天上午就是这个！）⇒ 循环次数**乘 10**（≈6000） |
| 2 | **`wf_delay_us()`**（WiFi 驱动的微秒延时） | 同样是空转实现 ⇒ 会缩到 1/10 ⇒ WiFi 时序可能失配 ⇒ 需一起标定 |
| 3 | **SPI/I2C 分频** | 这些是**按 PCLK 自动算**的 ⇒ 会自动变快 ✓（图传更快是好事）⇒ 无需手改，但要知道速率变了 |

**不受影响**：`board_pclk_measure()` / `board_vsync_measure()`（用定时器**硬件计数**，与时基无关 ✓）、
所有 `HAL_GetTick()` 毫秒逻辑（跟着 SysTick 自动缩放 ✓）

---

## 六、画板补充建议（不冲突但会省事）

- 摄像头 **3.3V 就近加 100nF + 10µF**（曾出现过欠压复位 `R=02`）
- **PA13/PA14（SWD）不要挂其他负载**
- **BOOT0 / BOOT1(PB2) 留跳线**
- 你**没用 PA15/PB3/PB4（JTAG）** ⇒ 很好，省掉 remap 的麻烦 ✓
- 排针连号块（`PC6~PC9`=63~66、`PE4~PE6`=3~5、`PB12~PB15`=51~54）走线确实顺 ✓

---

## 七、结论

- **表 1 / 表 2 / 表 3 可以照画**（3 条提醒见第二节）
- **表 4 三项**：晶振需实物确认（且 .ioc 与库不一致）；SYSCLK 确实是 16MHz；
  VSPolarity 用 Low ✓
- **升 168MHz 前**记得同步改两处软件延时（第五节）
