xiaotang567/small_car/tools/docs_txt/【必看】总钻风资料说明V1.4.txt

===== PAGE 1 =====

2024 
总转风资料使用说明 

===== PAGE 2 =====
总转风资料使用说明 | 逐飞科技 
 1 
目录 
目录 ....................................................................................................................................1 
1. 前言 ...............................................................................................................................2 
2. 初次使用 ......................................................................................................................3 
3. 关于例程的使用说明 ................................................................................................4 
4. 其他文件夹说明 .........................................................................................................6 
4.1. 【封装】文件夹说明 ......................................................................................................... 6 
4.2. 【上位机】文件夹说明..................................................................................................... 6 
4.3. 【文档资料】文件夹说明 ................................................................................................ 6 
4.4. 【转接板】文件夹说明..................................................................................................... 7 
5. 文档版本 ......................................................................................................................8 

===== PAGE 3 =====
总转风资料使用说明 | 逐飞科技 
 2 
1.前言 
感谢您选购逐飞科技总钻风摄像头，为了避免您在使用过程中遇到问题，请先仔细阅读本
篇说明文档。 

===== PAGE 4 =====
总转风资料使用说明 | 逐飞科技 
 3 
2.初次使用 
如果您是初次使用总钻风摄像头，对于摄像头的使用无从下手，请务必先仔细阅读【使用说
明】总钻风使用说明书(“总钻风摄像头\【文档资料】 摄像头相关资料\【使用说明】总钻风使用说明”。)
该说明书内有详细介绍总钻风的使用方式及注意事项。 
如果在调试过程中遇到问题，如初始化不成功等问题，请务必仔细阅读【问题汇总】总钻风
调试方法与问题锦集，该文档里包含有大量常见的调试问题以及判断摄像头是否正常工作的方法，
若您在阅读文档后依然没有找到解决办法，请联系我们的技术客服。 

===== PAGE 5 =====
总转风资料使用说明 | 逐飞科技 
 4 
3.关于例程的使用说明 
如果您是第一次使用总钻风摄像头，且完全没有任何调试经验，请仔细阅读本章节。 
 
首先打开“【例程】总钻风对应各种单片机的例程”文件夹。 
查看自己的摄像头是否带51 芯片，选择对应的例程 
 
并根据您使用的主控单片机型号（这里以 RT1064 单片机为例）解压对应单片机名称的文
件夹。（若使用其他型号的单片机，例程文件夹的内容可能与本文档接下来的内容不相符，请根据
自己的需求自行选择例程。） 
 
进入该文件夹后，可以看到有 8 个子文件夹，如果您是第一次使用总钻风摄像头，并且希望通
过上位机查看摄像头采集出来的原始图像，可以使用E09_08_mt9v03x_seekfree_assistant_demo
（mt9v03x）表示摄像头型号为总钻风，上位机使用我们的逐飞助手。请按照下图打开红框内圈
出的文件夹。其他的例程可以参考“例程说明”。 
 
打开文件夹后，如下图所示。 

===== PAGE 6 =====
总转风资料使用说明 | 逐飞科技 
 5 
 
根据您所使用的开发环境，选择对应的文件夹，例如：如果您使用的开发环境是mdk，请
打开mdk 文件夹。（如果您是用的开发环境是 iar，请打开名称为 iar 的文件夹） 
 
双击打开rt1064.uvprojx 工程文件，即可打开例程。 
 
打开例程后，请根据对应例程的main文件注释进行使用。如下图所示： 

===== PAGE 7 =====
总转风资料使用说明 | 逐飞科技 
 6 
4.其他文件夹说明 
4.1.【封装】文件夹说明 
该文件夹内包含了总钻风所使用的 FPC-18P 排线接口的原理图以及 PCB 封装。如果您
想要在自己的 PCB 上直接焊接 FPC 排座，可以使用我们提供的原理图及 PCB 封装。文件夹
内包含的文件如下： 
 
4.2.【上位机】文件夹说明 
该文件夹内包含了逐飞助手V1.0.3（即“上位机”），使用该上位机可以查看总钻风摄像头采
集到的图像，上位机的使用方法可以详见例程中的注释 
 
上位机的完整使用说明可以进入逐飞助手链接进行查看： 
https://gitee.com/seekfree/seekfree_assistant 
4.3.【文档资料】文件夹说明 
包含了关于总钻风摄像头的各种说明性文档。 

===== PAGE 8 =====
总转风资料使用说明 | 逐飞科技 
 7 
4.4.【转接板】文件夹说明 
本文件夹内包含摄像头FPC 排线接口的说明，以及转接板的封装库和原理图 

===== PAGE 9 =====
总转风资料使用说明 | 逐飞科技 
 8 
5.文档版本 
版本号 
日期 
内容变更 
V1.0 
2019-01-11 
初始版本。 
V1.1 
2019-11-15 
增加表格样式 修改标题 
V1.2 
2019-11-23 
修改目录起始页 
V1.3 
2022-01-11 
修改文档样式 
V1.4 
2024-05-20 
以最新的库更新说明
