xiaotang567/small_car/tools/ccl_461.png

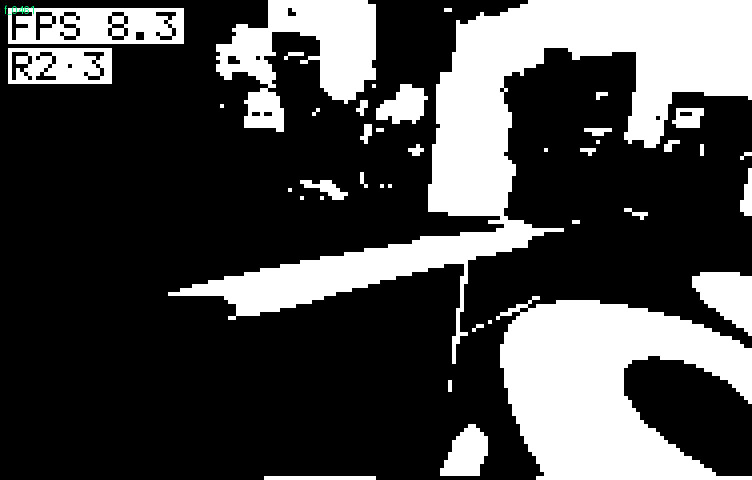
tools/ccl_461.png
