xiaotang567/small_car/tools/ccl_521.png

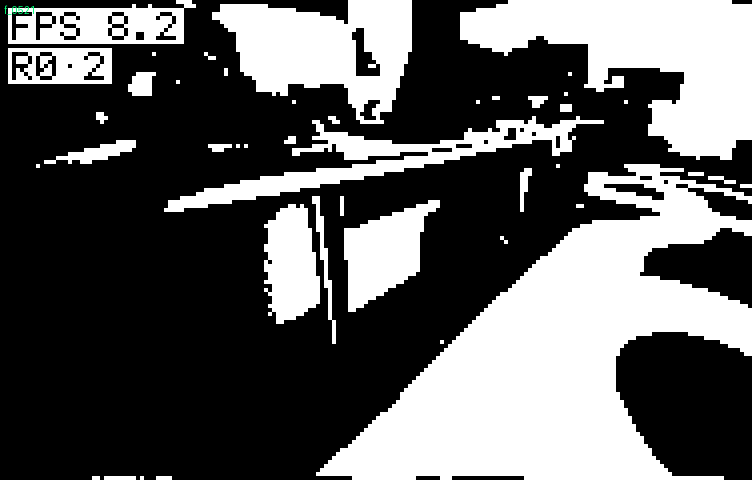
tools/ccl_521.png
