xiaotang567/small_car/tools/ccl_541.png

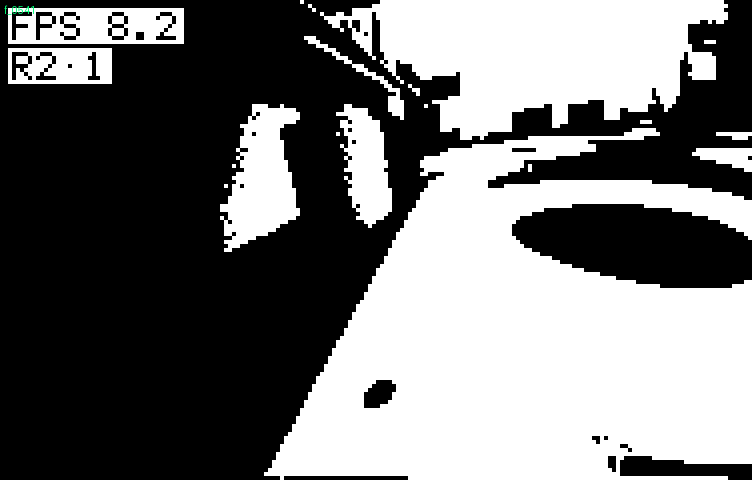
tools/ccl_541.png
