xiaotang567/small_car/tools/now3050.png

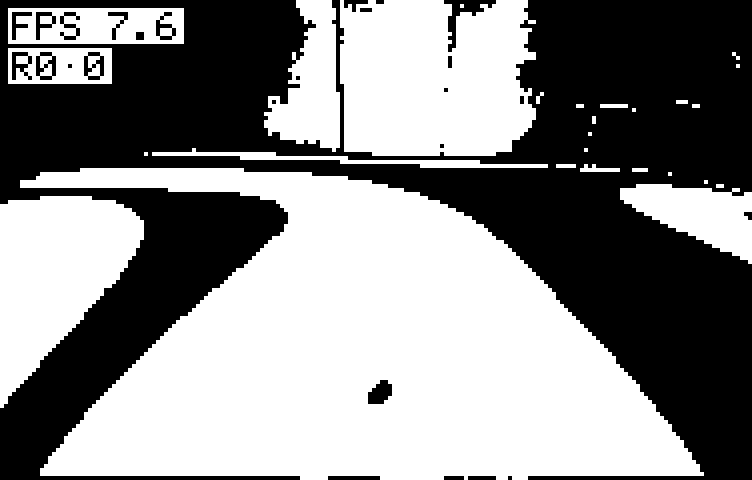
tools/now3050.png
