xiaotang567/small_car/tools/rb_f481.png

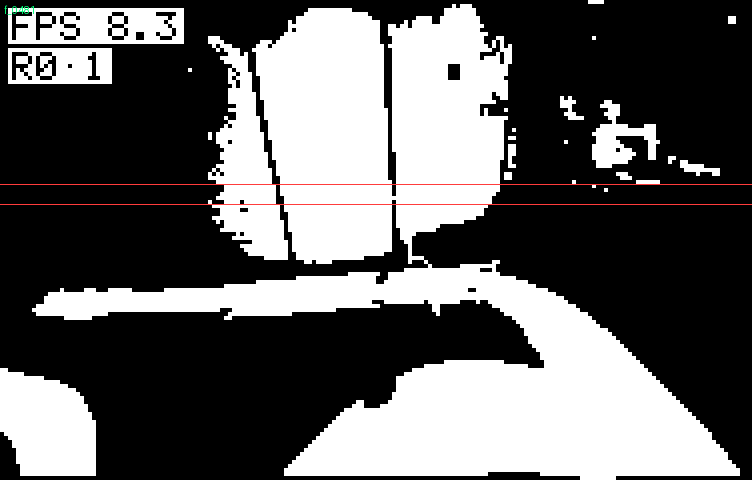
tools/rb_f481.png
