xiaotang567/small_car/tools/rb_f841.png

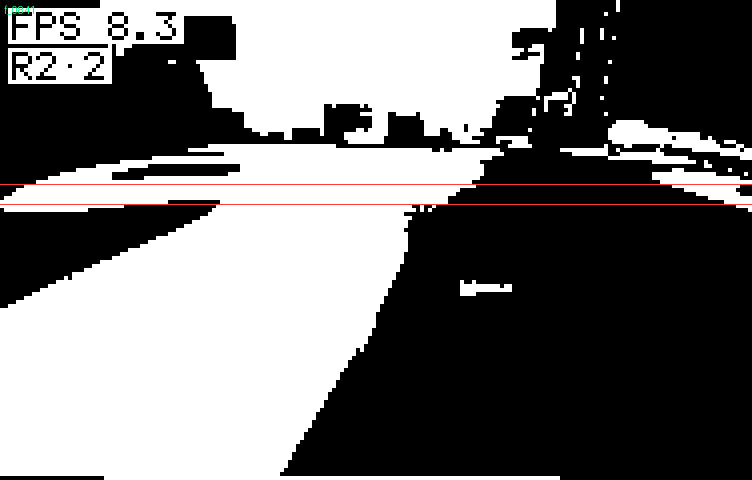
tools/rb_f841.png
