xiaotang567/small_car/tools/shot_2166.png

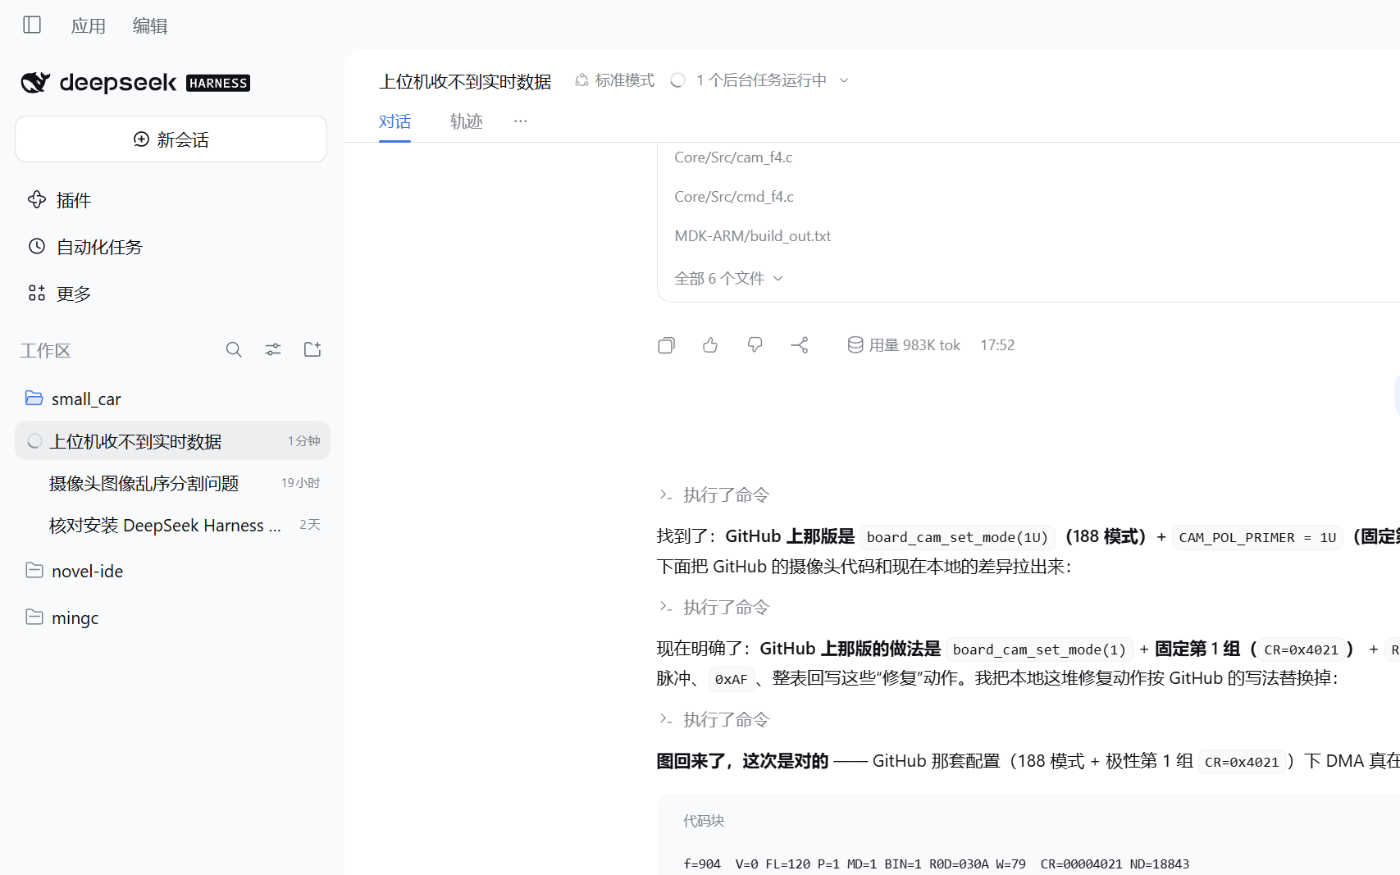
tools/shot_2166.png
