xiaotang567/small_car/tools/ui_300.png

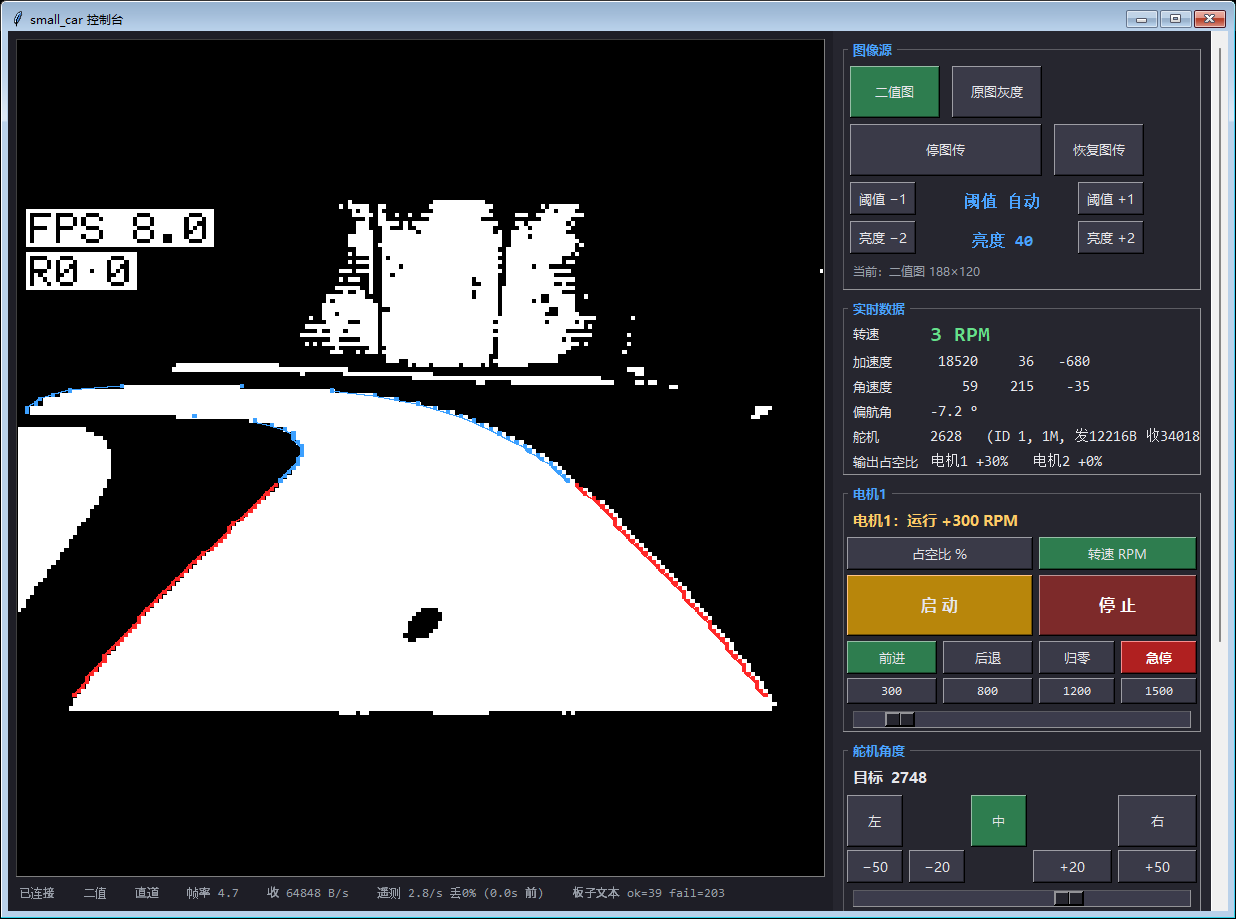
tools/ui_300.png
