xiaotang567/small_car/tools/ui_2169.png

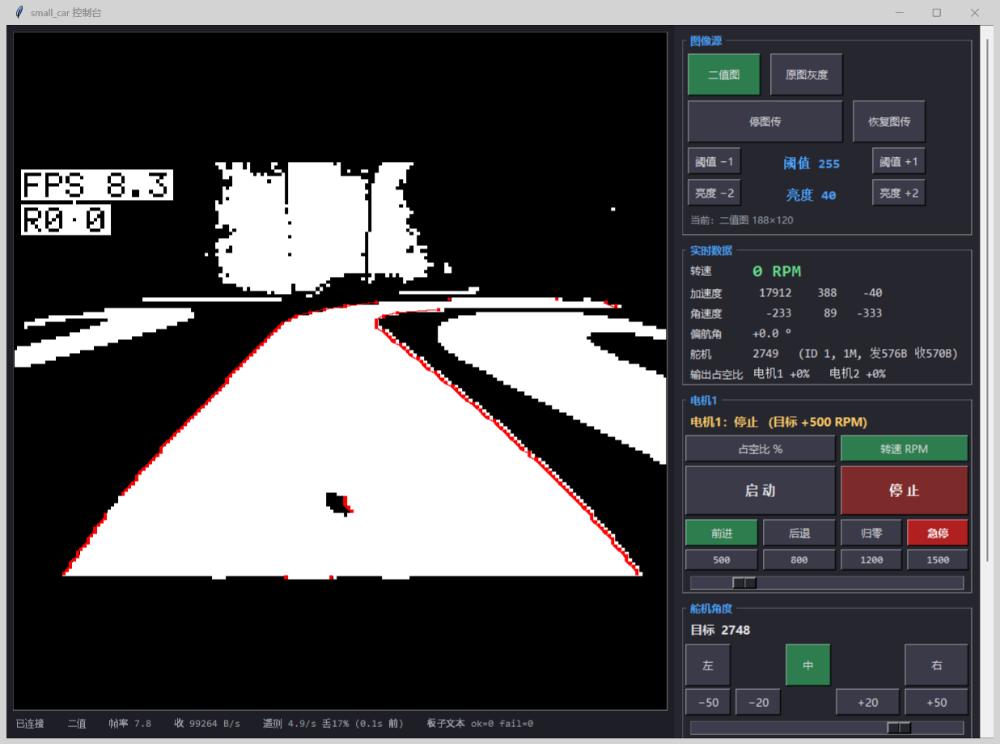
tools/ui_2169.png
