xiaotang567/small_car/tools/ui_2170.png

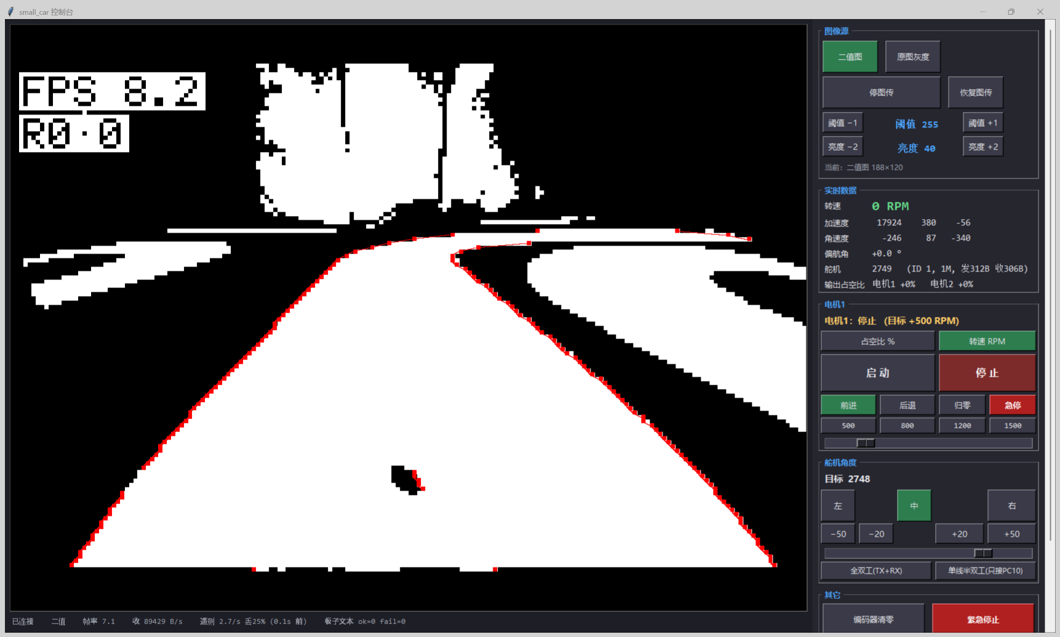
tools/ui_2170.png
