xiaotang567/small_car/tools/ui_2172b.png

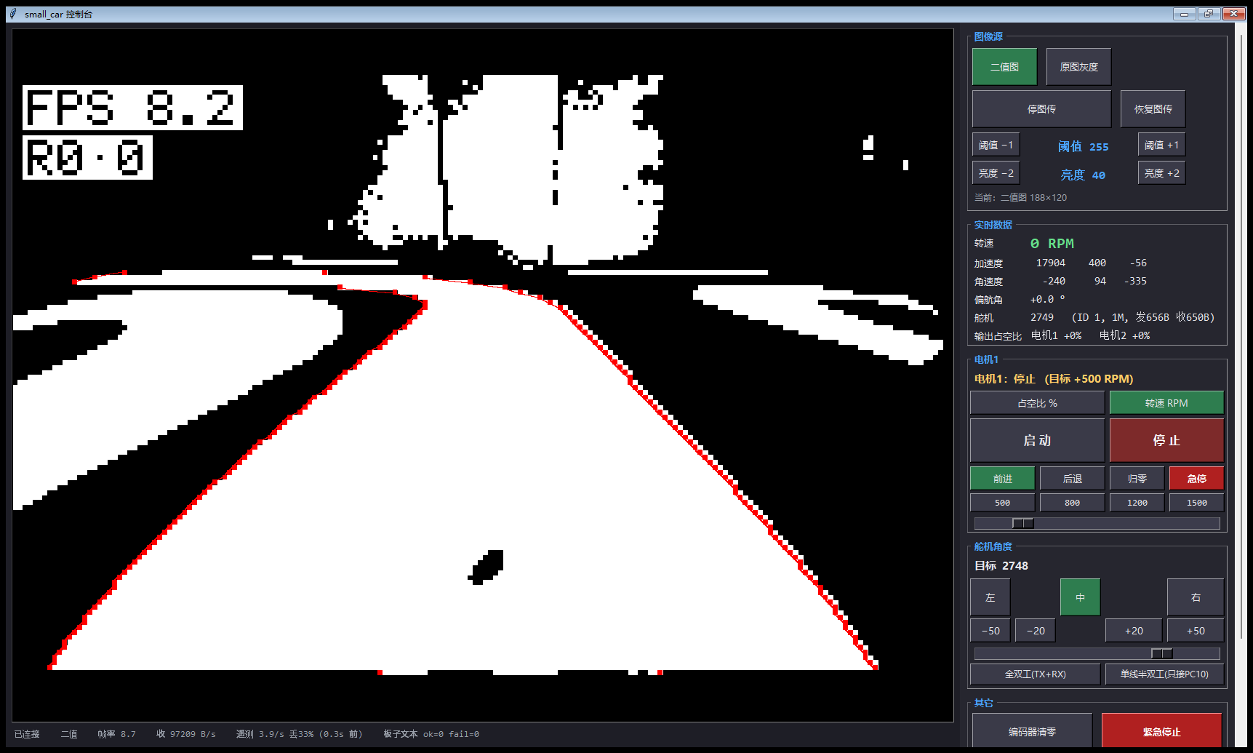
tools/ui_2172b.png
