xiaotang567/small_car/tools/ui_cam.png

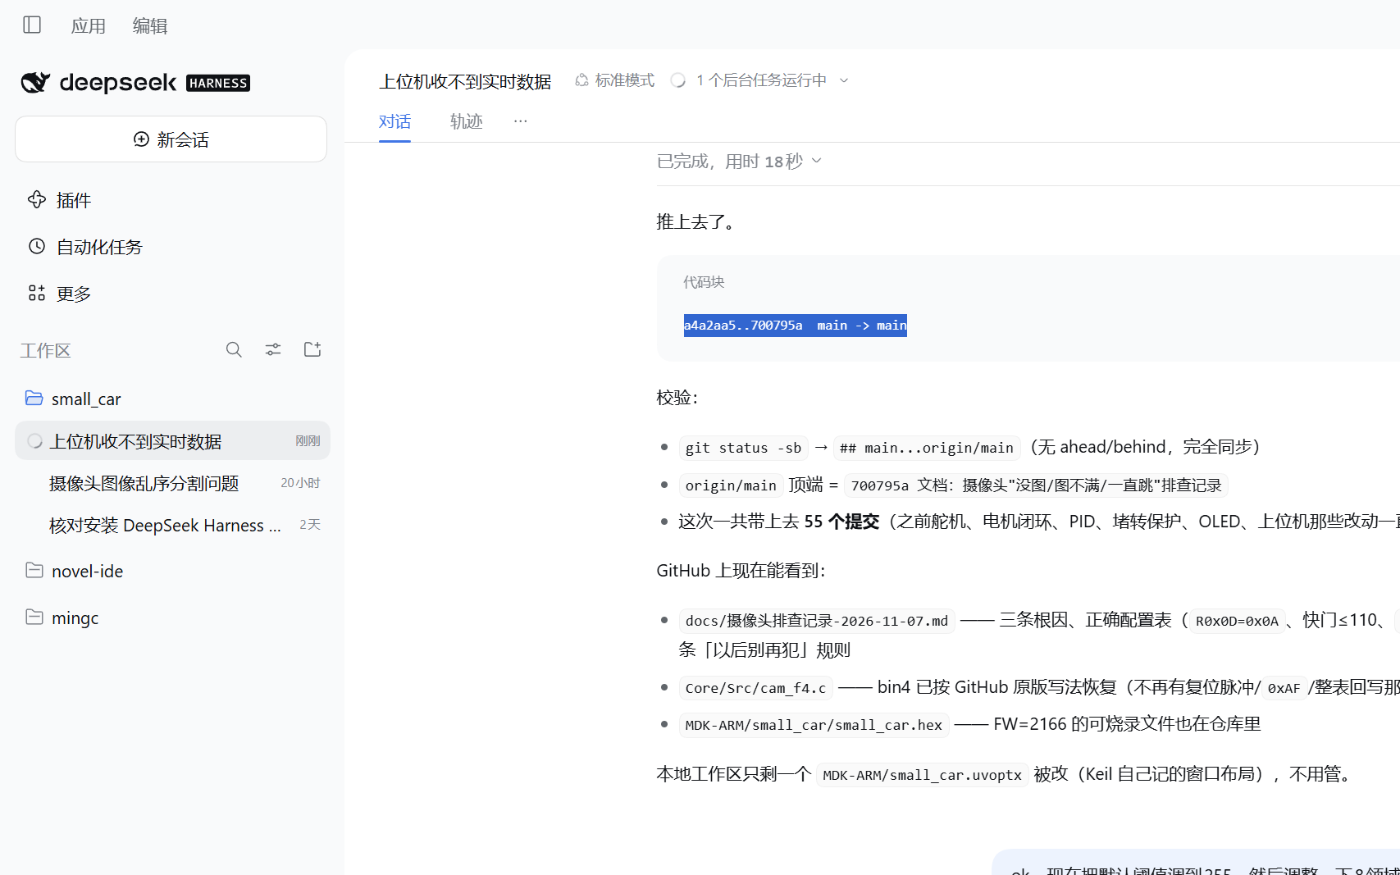
tools/ui_cam.png
