xiaotang567/small_car/tools/ui_curve_now.png

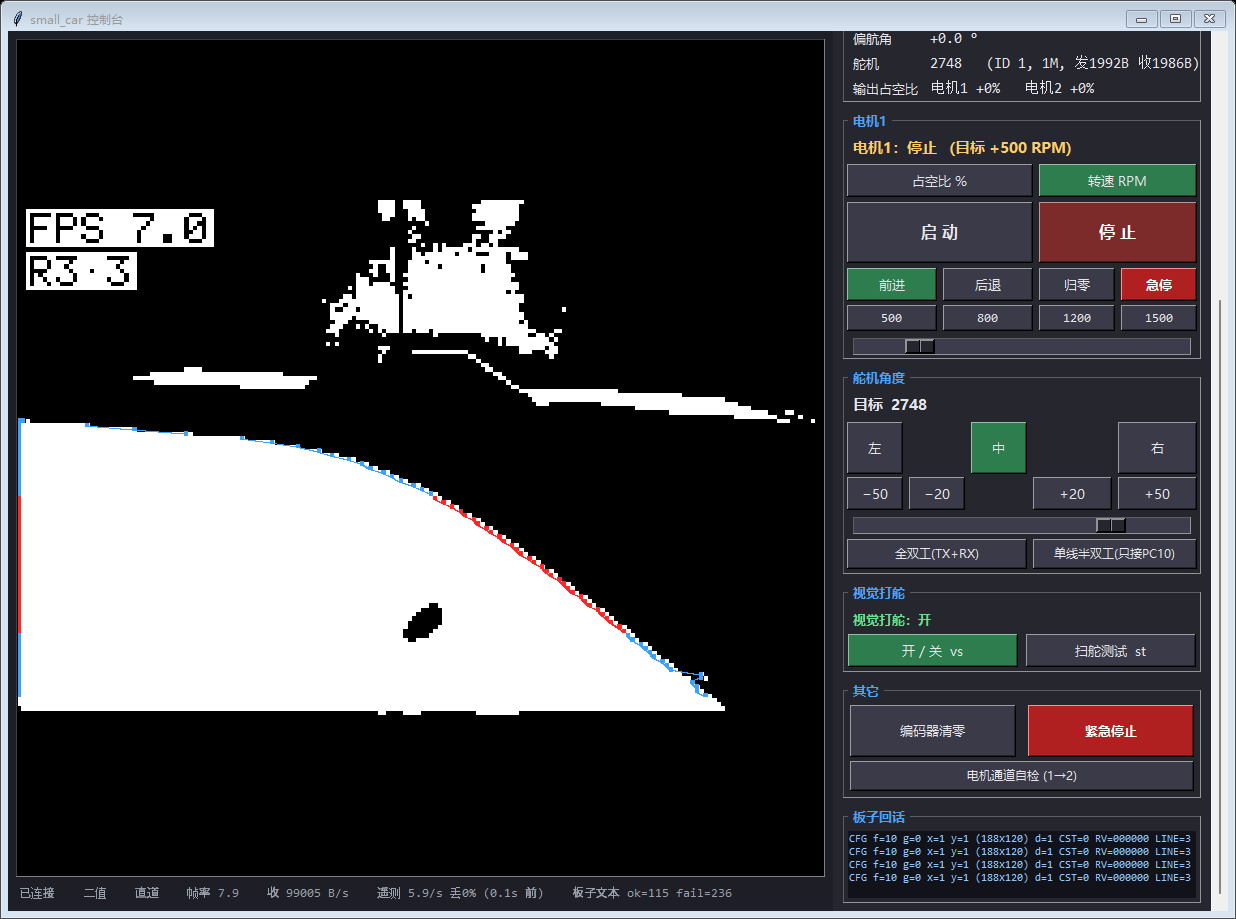
tools/ui_curve_now.png
