xiaotang567/small_car/tools/ui_straight_curve.png

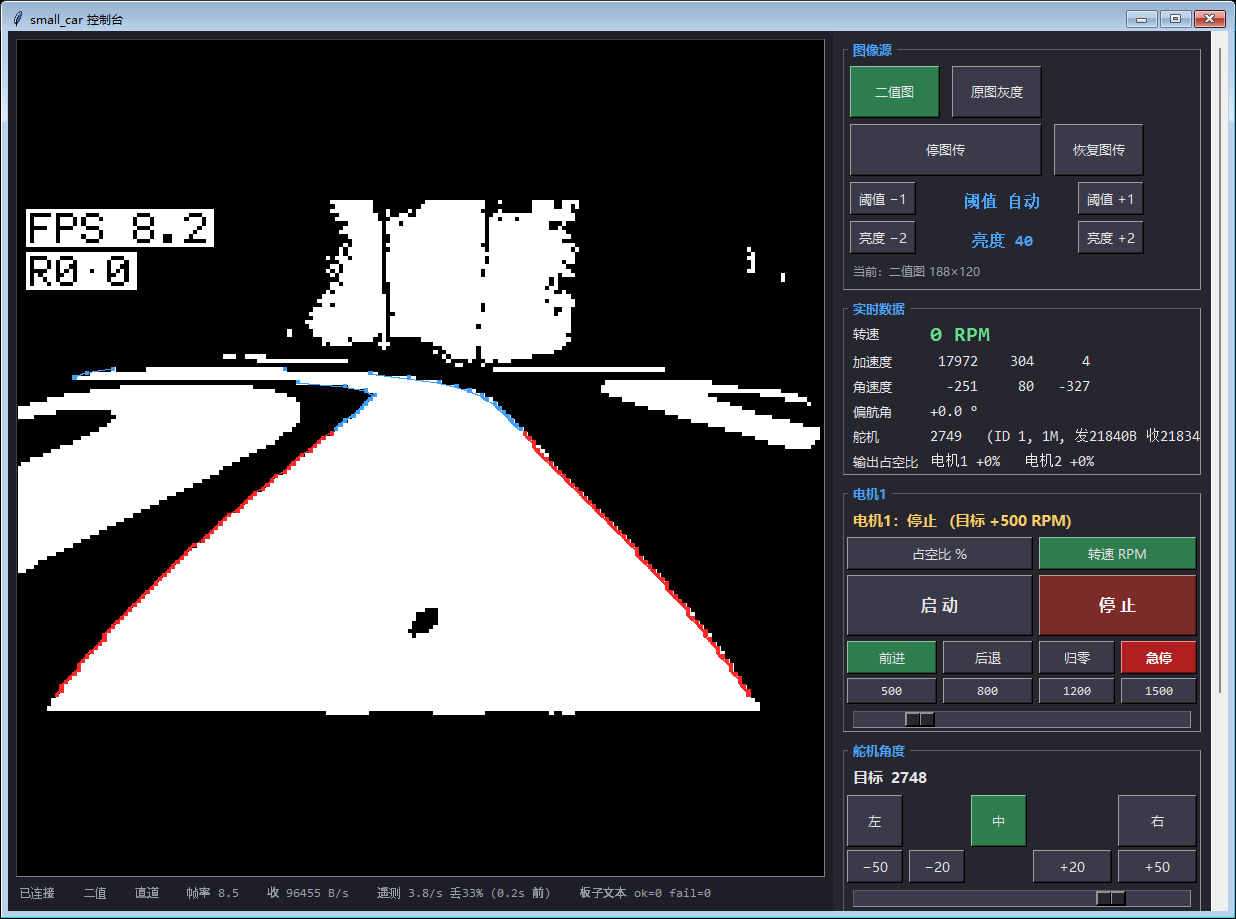
tools/ui_straight_curve.png
