xiaotang567/small_car/tools/ui_switches.png

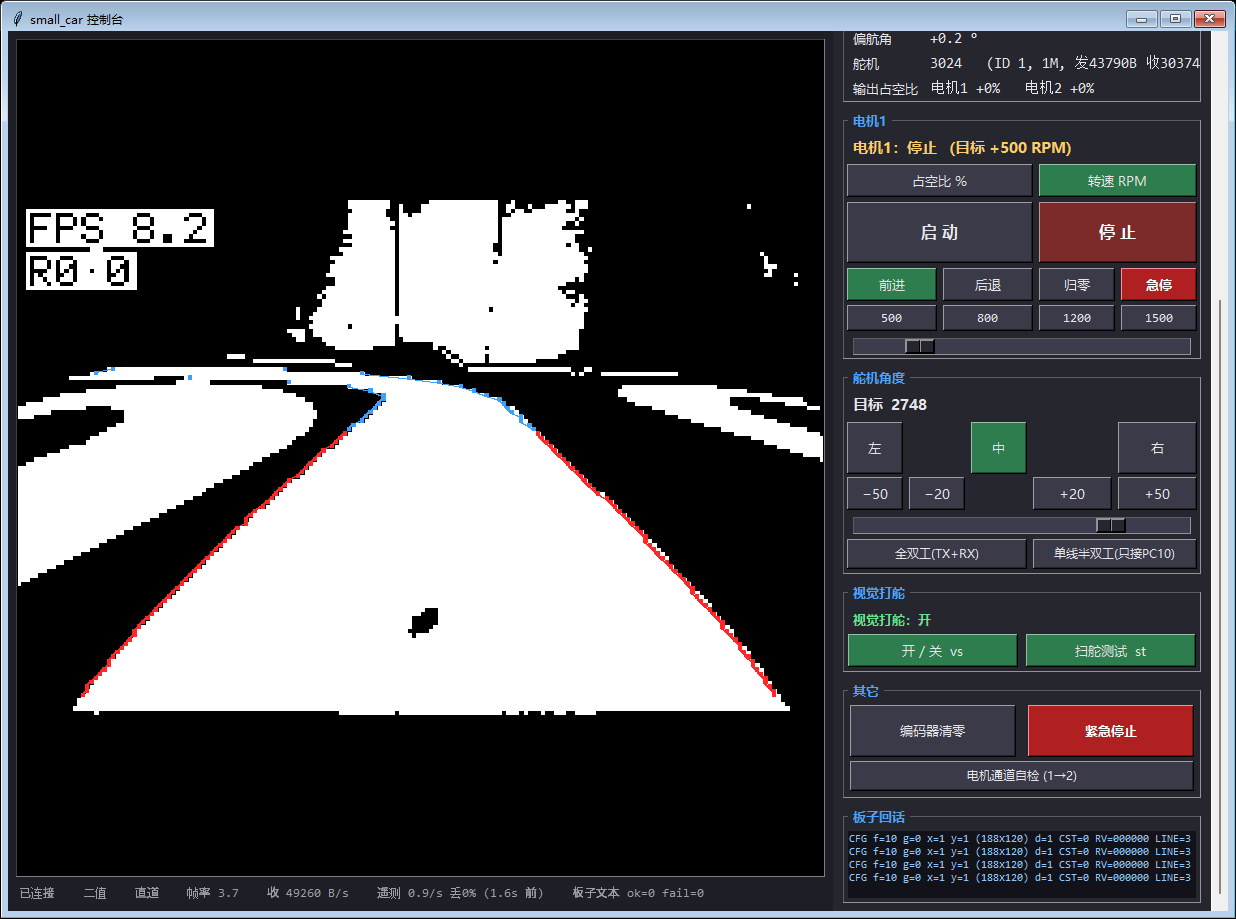
tools/ui_switches.png
