xiaotang567/small_car/tools/ui_t255.png

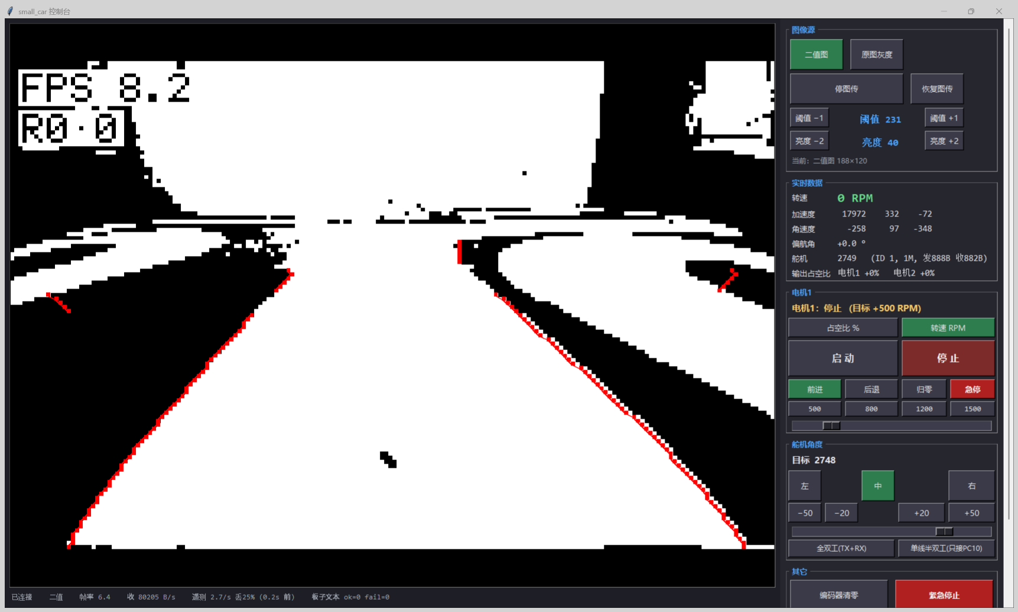
tools/ui_t255.png
