xiaotang567/small_car/tools/ui_win.png

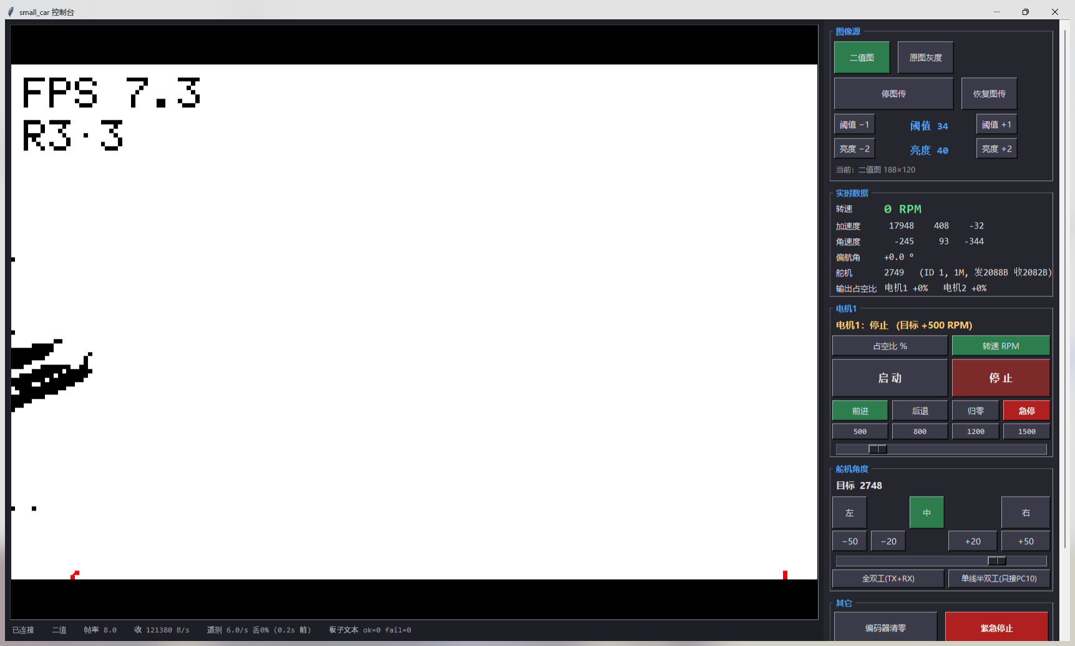
tools/ui_win.png
