xiaotang567/small_car/tools/zoom_row90.png

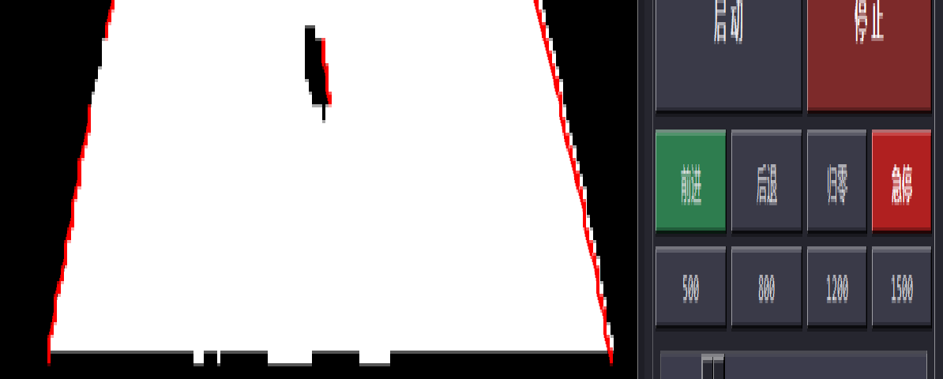
tools/zoom_row90.png
