xiaotang567/small_car/MDK-ARM/build_out.txt

*** Using Compiler 'V5.06 update 7 (build 960)', folder: 'C:\Keil_v5\ARM\ARMCC\Bin'
Build target 'small_car'
compiling cmd_f4.c...
compiling app.c...
compiling cam_f4.c...
linking...
Program Size: Code=44664 RO-data=3856 RW-data=23604 ZI-data=106524  
FromELF: creating hex file...
"small_car\small_car.axf" - 0 Error(s), 0 Warning(s).
Build Time Elapsed:  00:00:02
