xiaotang567/small_car/(commit log)

2026-10-19 流畅视频：188x120 图传定型（整帧一包 + 位打包 + Otsu 二值化 + 实时 FPS）
    - 传感器：SCCB 自动探测(8组合) + 自动配 188x120(列/行 bin4) + 快门/翻转
    - 采集：DCMI+DMA 环形缓冲(480行)，位图去重收割，采齐才发
    - 处理：MCU 内 Otsu 二值化（上位机不做任何计算）
    - 传输：位打包(24B/行) + 整帧一包(120包→1包) + fps不限 + gap0
    - 上位机：解包显示 + 标题实时 FPS
2026-10-19 上位机：把帧率**画在图像上**（左上角黄字黑描边，Arial Bold 22px）
    - 新增 ImageDraw 叠加；字体加载失败时自动退回 Pillow 默认字体
    - 已用上位机同款 Python(Python312) 实测：字体 OK、文字实际绘制成功
    - 标题栏的 FPS 保留（双保险）
2026-10-19 帧率改由**单片机自己画进图像**（5x7 点阵，左上角白底黑字），电脑只负责接收显示
    - board_f4.c：新增 15 字模(0-9 . F P S 空格) + board_cam_draw_fps_text()
    - board_cam_analyze() 末尾按两次调用的间隔反推实际出帧率并画进 disp_img
    - 点阵字形已用 Python 预演验证（FPS 27.3 清晰可读）
    - cam_view.py：去掉电脑端的图像叠加，只保留接收显示
2026-10-19 修横线接缝：收割改用 VSYNC(真实帧首)对齐，一趟=一帧
    根因：原来用 disp_ln 回绕(每120行)当帧边界，与传感器真实帧边界无关
    ⇒ 一趟常横跨两帧 ⇒ 随机位置的横向接缝（重启几次碰巧对齐就消失）
    改法：
    - DCMI VSYNC 回调置 disp_vsync_flag
    - 收割开头：VSYNC 一到 ⇒ disp_in_frame/disp_fill/位图全清零，重新武装
    - 目标行号 dst 改用 disp_in_frame（帧内行号）⇒ 一趟正好一帧
2026-10-19 修随机竖线：整帧包改为续发 + 发帧期间禁止插文本 + 上位机校验和
    根因一：wifi_f4_send 模块一忙就中途 break，只发出前半包；
    上层重试时又从包头重发 ⇒ 上位机收到'半包+整包' ⇒ 数据整体错位 ⇒ 竖线
    根因二：心跳文字和半包在同一轮主循环发出 ⇒ 文本字节插进二进制包中间 ⇒ 同样错位
    - 板端记录 fpkt_sent，重试只发剩余字节 ⇒ 流保持连续
    - 心跳：fpkt_sent != 0 时跳过（发完再报）
    - 上位机：整帧包校验和校验，坏包丢弃并计入'坏'
    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
2026-10-19 修上一版引入的'不发图'：整帧发送完成条件写错了
    fpkt_sent 记的是「已发字节数」，发完时 == fpkt_total ≠ 0，
    上一版却用 if (0 == fpkt_sent) 判完成 ⇒ 永远不完成 ⇒ 不发图
    （心跳守卫也依赖 fpkt_sent==0 ⇒ 连心跳一起被挡）
    改为判 rem == 0（剩余为 0 = 整包发完），完成后 fpkt_sent/fpkt_total 清零
2026-10-19 排查工具：测试图模式(T) + 上位机自动抓竖向断层
    - 板端 cam_testpat：输出 0..255 左右灰度渐变标准图 ⇒ 任何行数据错位都表现为整列突然跳变
    - 命令 T 切换测试图/正常画面
    - 上位机：每收满一帧检测'某列与左右邻居都>70%行不一致'，命中即打印列号并存 seam_XXX.png
2026-10-19 修横竖线：自动检测行内错位并逐行旋转补偿（cam_phase_k）
    依据用户线索：线位置'只在重启时变、运行中固定' ⇒ 开机定下的固定字节偏移 φ
    （DMA 环的 188 字节'行'与传感器真实行边界错位）⇒ 同时造成竖线(行内)和横线(帧首)
    - board_cam_analyze 开机前 10 帧内自动找坑位列：某列与左右邻居都>70%行不同
    - 命中即记入 cam_phase_k；收割时每行旋转 k 个像素补回
    - 诊断行新增 VPH=<k>
    - 命令 K：清零相位（防把真实竖边误判为坑位）
2026-10-19 修横竖拼接缝：目标行改用'缓冲行号 mod 120'锚定 + 缩短文本发送阻塞
    接缝本质=一段连续行来自另一帧（收割漏行/跨帧拼接）
    - dst = disp_next_row % 120：环的第 r 行就是该帧第 r 行 ⇒ 不管从哪一拍开始、
    中途是否插入新帧，凑出来的永远是同一帧的对应行
    - 文本发送重试 100→10 次（最坏阻塞 70ms→7ms）⇒ 减少漏行
2026-10-19 曝光默认 150→100：帧长只有120行，快门必须明显小于它（150 会让传感器卡在等曝光）
2026-10-19 回退到 05cdf18（确认能出图的版本）
    最近两次改动嫌疑：
    1) dst = next_row % 120（环形锚定）——可能在漏行时凑不齐 120 个目标行 ⇒ 不发送
    2) 快门 150→100 —— 与'能否出图'无直接关系，但一并回退
    先恢复可用状态；等把'竖线是场景还是伪影'定死，再只改必要的地方
2026-10-19 回退到 27227cc：最后一次**确认出图**的版本（逐行小包 + VSYNC 对齐）
    前面误把 05cdf18 当成好版本 —— 但那版里还带着'不发图'的完成条件 bug，
    真正修好它是在 a5bee46；而最后一次用户确认'有图'的是 27227cc。
    此版特征：无 fpkt_sent / 逐行小包发送 / VSYNC 对齐 / 快门 150 / 位打包
    （图能出，横竖线仍在 —— 作为排查基线）
    [cam_view.py, main.c]
2026-10-19 WiFi 自动重连：连续发送零进展 ⇒ 判定链路断 ⇒ 清 wf_ready 触发 3s 重连
    现象：上位机重启后 TCP 会话死掉，而固件 wf_ready 一直是 1 ⇒ 往死连接发、不重连 ⇒ 没图
    （netstat 只有 LISTENING、无 ESTABLISHED ⇒ 确认是链路层问题，不是图像问题）
    实测日志还暴露：快门=100 那版 DCMI 完全没采到（f=0 V=0 ND 卡死）⇒ 快门保持 150
    [wifi_f4.c]
2026-10-19 去掉会挂死的自愈重启：HAL_DCMI_Stop 无超时，会死等 ⇒ 整机挂住、心跳全无
    实测 22:04 那次：发了 CAM FOUND/CAM CFG/S/CAM1 四行后 13 分钟完全无声 ⇒ 板子卡死
    现在自愈只重开一趟（不碰 DCMI）⇒ 采集真死了也不会挂，心跳照发，便于观察
2026-10-19 记录：图正常（.axf 同步）
2026-10-19 开机随机横竖线：硬重启 + R 命令手动重同步
    - board_cam_restart 不再用会死等的 HAL_DCMI_Stop：直接关 DCMI/清 CR/关 DMA 流/复位 HAL 状态再 Start
    （Start 等 VSYNC 当帧首 ⇒ 每次从真帧首重新对齐）
    - 命令 R：随时手动重同步摄像头 —— 出线时按它即可判定是不是开机同步问题
    [main.c]
2026-10-19 修硬重启把图弄没：CR=0 清了极性/格式，必须重新 HAL_DCMI_Init
    - hdcmi.State 置 RESET 让 Init 肯重配；Init 后 State=READY，Start_DMA 才不返回 BUSY
    - DCMI->CR=0 会清掉 VSPOL/HSPOL/PCKPOL/8位/硬件同步 ⇒ 必须 Init 一次重新应用
2026-10-19 按 HAL 源码纠正：重启回到官方 Stop+Start（它本来就带超时）
    读 stm32f4xx_hal_dcmi.c 确认：
    - HAL_DCMI_Stop 有超时（SystemCoreClock/HAL_TIMEOUT_DCMI_STOP），不会死等 —— 我之前的判断错了
    - 它内部 HAL_DMA_Abort 会关 DMA 流，Start 才能成功
    - HAL_DCMI_Start_DMA 不检查 State，也不会重配极性 ⇒ 不能先 CR=0（会丢极性）
    22:04 的'沉默'真因是 WiFi 链路死掉、心跳发不出（自动重连才是对症的）
2026-10-19 按文档修开机随机横竖线：重启 DCMI 时把收割游标同步到 DMA 当前位置
    文档依据《总钻风摄像头使用说明 V2.7》9.3.3：
    '摄像头上的 51 有 eeprom…每次上电的时候加载 eeprom 的配置数据'
    我们拆了 51 ⇒ 上电是出厂默认 752×480，靠固件 SCCB 改完才变 188×120
    ⇒ 改完重启 DCMI 时环里混着旧宽度数据，而收割游标没跟着 DMA 复位
    ⇒ 新旧数据拼接 ⇒ 横竖线（拼到哪取决于上电时序 ⇒ 开机随机出现）
    修法：board_cam_start() 里
    disp_next_row = board_cam_write_row(); // 游标对齐到 DMA 当前行，旧数据一律不碰
    disp_ln = 0;
2026-10-19 摄像头完成前的收尾提交
2026-10-21 disp_img 搬进 CCM（64KB 专用 RAM）：主 SRAM 从 119.4KB 降到 96.8KB
    - sct 增加 RW_IRAM3 0x10000000 0x10000 { .ANY(.ccmram) }
    - uvprojx: umfTarg 1→0（否则 sct 会被 Target 对话框覆盖）+ 指定 sct 路径
    - board_f4.c: disp_img 加 __attribute__((section(".ccmram")))
    - system_stm32f4xx.c: SystemInit 里开 RCC_AHB1ENR_CCMDATARAMEN（必须在 __main 清零 CCM 之前，否则 HardFault）
    实测 map：disp_img 在 0x10000000 ✓；RW_IRAM1 从 0x1D1D8(119408) 降到 0x17A50(96848)
    CCM 段被链接器压缩存放（COMPRESSED 0xB4），几乎不占 Flash
2026-10-21 栈(1KB)+堆(512B)也搬进 CCM
    sct 的 RW_IRAM3 增加 * ( STACK ) 和 * ( HEAP )
    实测 map：
    STACK 0x10005A20 (1024B)
    __initial_sp 0x10005E20
    RW_IRAM3 0x5E20 = 24,096B / 64KB
    编译 0 Error(s) 0 Warning(s)
2026-10-21 存档：CCM 优化（disp_img+栈+堆）完成
2026-10-21 路线识别：用左边界在近/中/远三段的位置趋势判弯向
    cam_route: 0=直线 1=左转 2=右转 3=丢线/十字
    - 近段 row106~115 / 中段 76~85 / 远段 46~55，各取有效行均值
    - d = 远段均值 - 近段均值；d<-8 左转，d>+8 右转，否则直线
    - 远段有效行<3 或 近中段都无有效行 ⇒ 给保守结论（0 或 3）
    - 左上角在 FPS 下面一行画 "R<code>"（字模新增 'R'）
    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
2026-10-21 上位机：用红色叠加显示单边寻线结果（与 MCU 同算法）
    - 从收到的二值帧里按 board_cam_analyze 的同一规则找左边界
    - 相邻行横向连线（斜边连续）+ 每行点，红色 (255,0,0)
    - 前 24 行跳过左上角 FPS/R 文字区（单片机先找边后画字，PC 收到的是画完的图）
    - 实测：120/120 行都能找到边，耗时 1.0ms/帧（188x120）
2026-10-25 WIFI_PC_IP: 192.168.53.77 -> 192.168.165.77（手机热点换了网段）
2026-10-25 自动推导电脑 IP：模块 IP 前3段 + 末段 77，换网段不用再改代码重烧
    - wifi_f4.c 新增 wf_pc_ip[] 与 wf_derive_pc_ip()
    - wf_get_ip() 拿到模块自己的 IP（如 192.168.165.42）后调用推导
    - 两处 wf_socket_connect 改用 wf_pc_ip（原来是宏 WIFI_PC_IP）
    - 兜底：解析失败沿用宏；末段常量 WF_PC_LAST_OCTET=77 可在 wifi_f4.h 改
    - 依据：手机热点换网段 5 次，电脑末段恒为 .77
    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
    [wifi_f4.c, wifi_f4.h]
2026-10-25 图像上下翻转：摄像头装反，在收割阶段翻行号
    dst = (CAM_H-1) - 帧内行号
    放在收割阶段翻，后面 Otsu/找边/路线识别的近远段假设自动成立
    （摄像头以后装正，把这行注释掉即可）
2026-10-25 左边界改为从下往上跟线（解决背景白块干扰导致误判 R2）
    - 每行不再从最左边独立扫（会抓到背景里的白条）
    - 从最底行开始，之后在上一行边界 ±20 内找；掉线 8 行则重新从画面中间捕获
    - MCU(board_cam_analyze) 与上位机红线算法同步修改
    - 实测用户截图：底部 65→46 平滑跟住赛道左边缘
2026-10-25 路线识别改用近处两段（86-95 vs 106-115），修远处断开时永远报 R0
    实测问题：远处52行左右赛道断开，只剩背景白带（值~50），
    - 固定 46~55 段无有效边 ⇒ cF<3 ⇒ 兜底 R0 ✗
    - 改成最上面取6条有效边 ⇒ 抓到背景白带（50/48/47）⇒ d=-7 ⇒ 仍 R0 ✗
    最终：远段取 86~95（离车头近、一定可靠）⇒ 截图实测 近54 / 远75 ⇒ d=+20 ⇒ R2 ✓
2026-10-25 路线识别 v2：目前走哪 + 未来走哪（三段共享中间带，无需切换）
    - 三段：近 106~115 / 中 88~97 / 远 62~71
    - 目前 = 中-近；未来 = 远-中
    - 两者共用中带 ⇒ 目前的远 = 未来的近 ⇒ 拐弯自然从未来滑入目前，不存在切换时机
    - 显示改为 R<目前>-<未来>，如 R0-2（现在直行，前方右转）
    - 字模新增 '-'
2026-10-25 路线识别 v3：加透视补偿（直道不会再被判成弯道）
    问题：直道上所有平行线都向消失点收敛 ⇒ '远段x − 近段x' 在直道上也不为 0
    ⇒ 之前的算法在直道上就报 R2（实测用户截图）
    修法：先算'如果是直道，远段应在哪'（近段指向消失点 94 的直线），
    实际值减预期值 = 纯弯曲量；±6 判左右
    - LF_HORIZON_ROW=56（地平线行，现场可微调）
    - 目前 = 近110→中92；未来 = 中92→远67
2026-10-25 路线识别：透视基准改为单参数线性模型 LF_STRAIGHT_DX_PER20=12
    消失点模型要两个标定值且对安装角敏感，改成单参数：x_exp = x1 + 12*(r近-r远)/20
    标定值由用户直道截图反算（近23→中37，18行差14 ⇒ 折算20行≈12）
    该图复算：目前 dev=+3.2 ⇒ R0；未来 dev=+7.0 ⇒ R2
2026-10-26 八邻域爬线 v1（实验，默认关闭）：简单贪心版在实测图上会卡死
    - 新增 lf_trace_left_8()：底行找最宽白段作种子，8 邻域向上爬
    - 实测失败：种子选到背景白条 / 允许向下导致死循环 / 卡在底部 2 行
    - 结论：八邻域需要「方向状态机」而不是贪心，见笔记
    - LF_USE_8NEIGHBOR = 0，当前仍用逐行±20 跟线（已验证可用）
2026-10-26 八邻域方向状态机版完成（已用两张截图离线验证）
    算法：种子(112行最宽白段左端) → 方向状态机(右转→直行→左转，白在右=右手法则)
    关键：记住上一步方向 d，每步只试 d±45°，才能贴着 1px 宽的边一直走
    兜底：种子以下的行沿用种子值；走不动就停；1500 步上限
    离线验证（Python 原型 → C 移植）：
    直道 种子(112,20) 65步 110=22 92=37 67=59
    弯道 种子(112,24) 58步 110=25 92=38 67=61
    ⇒ 与逐行±20 结果一致，且不受每行只能横移20限制
    LF_USE_8NEIGHBOR = 1（切回 0 即可用旧算法）
2026-10-26 上位机改用 VOFA+ JustFloat（8 通道），图像不再发送
    - main.c: SEND_MODE_VOFA=1 + vofa_send_frame()（32 字节 float + 00 00 80 7F 帧尾）
    - 整帧发送点改为发 VOFA；逐行分支在 VOFA 模式下跳过
    - board_f4.c: 新增 lf_dbg_a/b/c/dev（三行边界+偏航）、cam_fps10
    - lf_route_of 里记录 x1/x2 供波形观察
    - 补 #include <string.h>
    VOFA 配置：协议 JustFloat，通道数 8
    ch0~2 = 行110/92/67 左边界 ch3 = dev ch4=cam_now ch5=cam_ahead ch6=FPS ch7=阈值T
2026-11-01 开启八邻域寻线（方向状态机）+ 补 LF_SEED_ROW 定义
    LF_USE_8NEIGHBOR = 1，编译 0 错误 0 警告
    八邻域已在两张实测截图离线验证（直道/弯道各 65/58 步，边界值与旧算法一致）
2026-11-01 拆分：board_f4.c 拆出 cam_f4.c（摄像头单独成文件）
    board_f4.c 2626 行 -> 187 行（只留时钟树 + LED）
    cam_f4.c 新增 2460 行（DCMI 采集、Otsu、八邻域寻线、路线判断、绘图、SCCB）
    wifi_f4.c 原本已独立
    同时修正：
    - LED 的 LED_PORT/LED_PIN 宏和 led_code/led_t0 变量误切到 cam_f4.c，已移回 board_f4.c
    - cam_f4.c 误带 board_clock_init，已移除（避免重复定义）
    - uvprojx 新增 cam_f4.c 条目
    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
2026-11-01 拆分 main.c -> app.c + app.h（按正确顺序重做成功）
    拆分结果：
    main.c 1374 -> 726 行（命令通道 + 初始化）
    app.c 新增 674 行（主循环 + 采集/发送相位机 + VOFA 帧）
    app.h 新增 27 行（15 个共享变量的 extern 声明）
    cam_f4.c 2449 行（上次已拆）
    wifi_f4.c 652 行（原本独立）
    board_f4.c 198 行（原 2626，只剩时钟+LED）
    关键教训：
    - 不能覆盖 CubeMX 的 Core/Inc/main.h，共享声明另建 app.h
    - 共享变量必须先集中声明 extern，再拆函数，否则每拆一处就断一片
    - 相位机的 static 变量（cam_phase/cam_t_tx/cam_tx_row/t_pclk 等）必须跟着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
2026-11-01 拆分完成：命令通道切出 cmd_f4.c，main.c 只剩 267 行
    main.c 726 -> 267 行（只剩初始化 + app_loop 调用）
    cmd_f4.c 新增 476 行（命令解析 + 可调参数定义）
    这次一次编译通过，因为共享变量已集中在 app.h
    最终结构：
    main.c 267 初始化
    app.c 674 主循环 + 相位机 + VOFA
    cmd_f4.c 476 命令通道
    cam_f4.c 2449 摄像头
    wifi_f4.c 652 WiFi
    board_f4.c 198 时钟 + LED
    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
    [cmd_f4.c, main.c]
2026-11-01 双边巡线：加右边界跟踪 + 中线，判弯改用中线
    - 新增 lf_trace_right_8()（左边界函数的完全镜像：白在左用左手法则）
    - 新增 cam_bound_r[120] 右边界、cam_center[120] 中线 = (左+右)/2
    - lf_route_of 改用 cam_center 判弯
    - LF_STRAIGHT_DX_PER20 由 12 改为 0：中线在直道上就是垂直的，不需要透视补偿
    离线验证发现：右边界在当前两张截图里大多跑出画面（8/31 行），
    说明拍摄时摄像头偏右，赛道右边缘不在视野内 —— 需要调整摄像头朝向。
    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
    [board_f4.h]
2026-11-01 VOFA+ 图像 + 波形：FireWater 前导帧发图，同时发 8 路 float 波形
    vofa_send_frame() 现在是两段：
    ① image:0,2820,188,120,1\n 前导帧 + 2820 字节 1bit 位数据（Format_Mono）
    ② 8 个 float + 0x7F800000 帧尾（边界/dev/cam_now/cam_ahead/fps/阈值）
    位打包：188x120=22560 像素 /8 = 2820 字节，白色置 1，行优先
    （上一次用字符串查找替换时把 cam_tx_row_done 和 app_loop 一起删了，
    已从 git 恢复并用『下一个函数起始行』作为边界重做，函数完整性已确认）
    编译 0 Error(s) 0 Warning(s)，app.c 695 行，4 个函数齐全
2026-11-01 VOFA 图像固定为组合2：IMG_SIZE=像素数22560 + Format_MonoLSB(2) + 位打包 LSB 优先
2026-11-01 VOFA 图像改用 JustFloat 二进制前导帧（不再依赖文本解析）
    前导帧 = 7 个 int32（28 字节）：
    {IMG_ID=0, IMG_SIZE=22560, W=188, H=120, FORMAT=2(MonoLSB), +inf, +inf}
    随后紧跟 2820 字节位数据（LSB 优先），再发 8 路 float 波形
    这样图像和波形都用 JustFloat，VOFA 只需选一个协议引擎
2026-11-01 逐飞助手图像协议改为官方真实格式（12 字节包头 + 校验和）
    之前用的 0xAA 0x55 + 高 + 宽 是网上文章的写法，逐飞助手不认，
    所以助手一直显示宽10 高10、FPS 0（在字节流里找不到合法帧头）。
    按本机官方库源码 seekfree_assistant.c 的 seekfree_assistant_camera_send() 实现：
    [0] 0xAA 帧头
    [1] check_sum 0xAA + sum(config[2..11])
    [2] 0x02 功能码 CAMERA
    [3] 0x02 图像类型 GRAY / MT9V03X（1 字节每像素）
    [4..5] 宽 小端 [6..7] 高 小端
    [8] 0x01 带图像数据
    [9..11] 0x00 保留
    实际字节：AA E3 02 02 BC 00 78 00 01 00 00 00 + 22560 字节灰度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
2026-11-01 逐飞助手图像协议：改用当前官方版 8 字节包头（旧 12 字节版作废）
    之前的 12 字节 + check_sum 包头来自本机 2022 年的旧库
    （maixcam\444\...MSPM0G3519 那份)，逐飞助手早已不用它，所以一直无图。
    以 gitee 官方仓库 seekfree_assistant 为准，链路已完整证实：
    例程 main.c: seekfree_assistant_camera_information_config(...) + camera_send()
    camera_send(): 内部直接调 camera_data_send(type, image, dot_type&0x0F, w, h)
    camera_data_send(): 组 8 字节包头 -> 发头 -> 发图像
    8 字节包头（无校验和）：
    [0] 0xAA
    [1] 0x02 功能码 CAMERA
    [2] (type<<5)|(无图像<<4)|边界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
2026-11-01 修复：逐飞助手画面定格 —— VOFA 分支漏调 cam_tx_row_done()
    现象：助手 FPS 26、字节数 693600/s 都正常，但图像永远停在第一帧。
    根因：发送分支里
    if (SEND_MODE_VOFA) { vofa_send_frame(); }
    else if (wifi_f4_send(...)) { cam_tx_row = txh-1; cam_tx_row_done(); }
    只有 else 分支解冻。VOFA 模式下 cam_tx_row_done() 从未执行
    ⇒ disp_hold 永远 1 ⇒ board_cam_harvest() 每轮被跳过 ⇒ disp_img 冻结
    ⇒ 相位机停在相 2，每 gap 毫秒把同一张冻结图重发 ⇒ 助手帧率虚高、画面定格。
    修法：VOFA 分支发完也执行 cam_tx_row = txh-1; cam_tx_row_done();
    （cam_tx_row_done 里 cam_tx_row>=txh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
2026-11-01 修复：图像流被心跳文本污染导致跑一会就卡死
    现象：烧完后画面动了几秒，随后 FPS=0、字节数/s=0，彻底停住。
    根因：同一条 TCP 流里混进了文本。
    app.c:539 每 500ms 无条件发一条 160~320 字节的心跳（S f=.. V=.. LG=..）
    cmd_f4.c 25 处命令 ACK 文本
    逐飞助手的图像协议**没有长度字段、没有校验和**，全靠"固定字节数"切帧。
    往流里插 160 字节 ASCII ⇒ 后面所有帧整体错位 ⇒ 助手越解析越乱，
    最终丢锁，表现为"动一会就卡死"。
    修法：
    1. app.h 统一定义 SEND_MODE_VOFA（app.c/cmd_f4.c 共用）
    2. app.c 新增 dbg_txt()、cmd_f4.c 新增 cmd_txt()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
    [app.h, cmd_f4.c]
2026-11-02 切回自研上位机（cam_view.py），逐飞助手方案搁置
    SEND_MODE_VOFA 1 -> 0：
    走原来的自定义协议 —— 10 字节包头 magic(AA 55 A5 5A) + 行号/W/极性/H/BPL
    + 位打包载荷（24 字节/行，188 像素） + 16 位校验和
    文本心跳也恢复（cam_view.py 按魔数同步，会自动跳过非包头字节）
    代码基线仍是 a3daaee（11-01 17:56，助手能出图那版），只多这一个模式开关。
    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
    [app.h]
2026-11-02 🔥 定位到真因：曝光(快门)150 行 > 一帧 120 行 ⇒ 传感器永远拍不完一帧
    证据链（三条完全对上）：
    1) 代码注释自己写着（cam_sccb_set_bin4 里）：
    "列 bin4 + 行 bin4 都要，但必须配 快门 R0x0B ≤ 120 行
    （行 bin4 后一帧只有 120 行，出厂默认曝光 443 > 120 → 永远完不成帧）"
    回读处的注释也写："正常应为 100=0x64"
    2) 但实际变量是 `cam_shutter = 150U`（150 是 188×480 时代的旧值，那时一帧 480 行）
    3) 实测日志：
    R0D=030A → [1:0]=2，行 bin4 生效，一帧 = 120 行
    SHUT=0096 → 0x96 = 150 行 ← 大于帧长
    V=0 / SR=0000 / RIS=0000 →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
2026-11-02 关键证据：PB7 上**确实有 50Hz 场同步**（V2=50000），硬件信号是好的
    日志对比两次启动：
    第1次 SHUT=0096(150) V2=50000k → 50000 = 50 Hz
    第2次 SHUT=0064(100) V2=100000k → 100 Hz（新固件生效）
    board_vsync_hz() = (20ms 内 PB7 的边沿数) × 50
    ⇒ V2=50000 就是 **50 Hz 的场同步信号**，说明：
    · SCCB 能读到 ID=0x1324 → I2C 与供电正常
    · PF=1134~1305kHz → 像素时钟正常
    · PB7 上有 50Hz 脉冲 → **VSYNC 信号线是通的、传感器在出帧**
    但 DCMI 侧：V=0、SR=0000、RIS=0000、ND 不动
    ⇒ 信号存在，**DCMI 就是锁不上** ⇒ 是 VSPOL/HSPOL/PCKPOL 极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
2026-11-02 🔥 真凶：board_cam_write_row() 与 board_cam_start() 的 DMA 长度不一致
    实测日志（19:08:38）已经证明 DCMI 锁上了：
    f=2->3->4->5 帧数在涨
    V=3->4->5->6 VSYNC 中断在涨
    ND=21000->14950->14949 DMA 在搬
    P=4->5->6->7 极性轮转生效
    但 F=0、LG=0 —— 一行都没收割进 disp_img。
    原因（数值可直接算）：
    board_cam_start() 装载长度 = CAM_W*CAM_H/4 = 22560 字（整块 90240 字节，两模式通用）
    board_cam_write_row() 认为 = cam_row_bytes*CAM_H/4 = 188 模式下只有 5640 字
    函数第一句： if (nd > words) return 0;
    NDTR 从 22560 往下降 ⇒ 只要 nd > 5640 就 return 0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
2026-11-02 图已经出来了！剩下的是"跑几帧就静默停止" —— 栈 1KB 溢出 HardFault
    里程碑证据（tools/cam_pol0.png，19:11:04 保存）：
    画面能看到 FPS 0.3 文字、R3-3 路线码、红色寻线、真实场景
    ⇒ 摄像头 → DCMI → 收割 → 二值化 → 寻线 → WiFi → 上位机 整条链全通
    但随后 4 秒内 S 心跳一个数都不变（f=4 V=5 P=7 全部冻结）
    ⇒ 心跳也停了 ⇒ 不是"慢"，是板子静默挂死
    ⇒ 典型 HardFault（HardFault_Handler 是 while(1)：不打印、不断连）
    原因：本版回退到 a3daaee，栈只有 1024 字节，
    而 app.c 心跳里有 char buf[320]，相位机里有 char cb[160]，再叠 s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
2026-11-02 电脑 IP 固定为 192.168.212.77，并停用自动推导
    原来：WIFI_PC_IP 是旧值 192.168.165.77，实际靠"模块IP前三段+.77"自动推导
    现在：WIFI_PC_IP = 192.168.212.77（实测当前值），WF_PC_USE_FIXED=1 关闭推导
    改动：
    wifi_f4.h WIFI_PC_IP -> "192.168.212.77"；新增 WF_PC_USE_FIXED
    wifi_f4.c wf_derive_pc_ip() 调用与定义都用 #if !(WF_PC_USE_FIXED) 包住
    以后换网段只需改 wifi_f4.h 里这一行，再也不会出现"推导出错误 IP"的隐性问题。
    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
    [wifi_f4.c, wifi_f4.h]
2026-11-02 把"复位原因"打印进心跳（代码早就抓了，但从来没输出）
    背景：日志里 f 反复 0→2→3→4→0，怀疑板子在不停复位；
    而 main.c 里明明已经读了 RCC->CSR 的粘滞复位标志（cam_rst_flags），
    只是**从来没有打印过**，所以一直看不到"为什么复位"。
    改动：心跳 S 行末尾增加 RST=%02lX（cam_rst_flags）
    bit0 BORRSTF = 欠压/掉电 ← 若出现，就是**供电问题（硬件）**
    bit1 PINRSTF = 复位脚被拉低
    bit2 PORRSTF = 上电复位
    bit3 SFTRSTF = 软件复位
    bit4 IWDGRSTF= 独立看门狗
    bit5 WWDGRSTF= 窗口看门狗
    bit6 LPWRRSTF= 低功耗
    另一个已确认的事实（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
2026-11-02 HardFault 改为 LED 快闪（不依赖通信，一眼分辨板子是否挂了）
    背景：图卡住时无法判断是"MCU 挂了"还是"数据没发出去"，
    而 HardFault_Handler 原来是静默 while(1)，什么指示都没有。
    改动（stm32f4xx_it.c）：
    进 HardFault 后，用寄存器直接操作 PB2（板载 LED）快闪（约 10Hz）。
    不调用 HAL（Fault 上下文里调库不安全）。
    LED 判读：
    快闪 ~10Hz = MCU 挂在 HardFault
    常亮 = MCU 正常在跑
    慢闪 / 闪N下 = WiFi 状态码（1/2/3 模块、热点、电脑；5 摄像头没探到）
    本版包含：
    栈 8KB、心跳/诊断缓冲改 static、电脑 IP 固定 192.168.212.77、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
2026-11-02 HardFault 现场捕获：存出错 PC/CFSR 到备份寄存器 → 软复位 → 心跳打印
    问题：LED 快闪证明 MCU 确实进了 HardFault，但 while(1) 只能说明"挂了"，
    不知道"挂在哪一行"，每次都只能猜。
    做法：
    HardFault_Handler 里
    1) 从栈帧取出出错处的 PC（sp[6]）和 LR（sp[5]）
    2) 连同 SCB->CFSR / HFSR 一起写进 RTC 备份寄存器 BKP1..BKP4（软复位不丢）
    3) NVIC_SystemReset() 立即重启
    main() 开机时读 BKP，若魔数匹配就存进 flt_pc / flt_cfsr 等全局，并清标志（只报一次）
    心跳 S 行末尾新增： PC=%08lX CF=%04lX
    拿到 PC 后可以用 small_car.map 反查是哪个函数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
    [app.h, main.c]
2026-11-02 🔥 定位到崩溃指令：board_cam_harvest 里写 disp_img[dst][c]（dst 可能为 -1）
    由实机上报反查：
    PC=0x08003B68 CF=0x8200(BusFault + PRECISERR + BFARVALID)
    用 small_car.map 反查 → board_cam_harvest +127 字节
    再用 fromelf 反汇编该地址：
    0x08003b60 MUL r12, r0, r3 ; c * cam_dcol
    0x08003b64 LDRB r12, [r6, r12] ; 读 cam_image（没崩）
    0x08003b68 STRB r12, [r7, r0] ; ★ 写 disp_img[dst][c] ← 崩在这
    0x08003b6e CMP r0, #0xbc ; 列循环 188 次
    而 r7 = 0x10000000 + dst*188（反汇编里 r8 = 0x77 - disp_in_frame，r7 = 0x10000000 + r8*188）
    ⇒ dst = 119 - disp_in_frame。一旦 disp_in_frame = 120（漏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
2026-11-02 切到逐飞助手模式 + 加回八邻域画线（基于已修好的稳定版）
    基线：可用_20261102_1939（图流畅、无崩溃）
    含：越界保护、栈 8KB、电脑 IP 固定、HardFault 现场上报
    1. app.h SEND_MODE_VOFA 0 -> 1（逐飞助手；图像走 8 字节包头 + 22560 灰度）
    2. cam_f4.c 加回 lf_draw_edge_marks()
    左边界往左涂 3 像素白、右边界往右涂 3 像素白（LF_EDGE_MARK_PX=3）
    调用点：算完中线之后、画文字之前
    原因：逐飞助手是 1bit 黑白图，画不了彩色线，只能在图里涂白
    模块拆分保持：main.c(初始化) / app.c(主循环+相位机+发送) /
    cmd_f4.c(命令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
2026-11-02 逐飞助手图像错位：包头与图像合并成"一次发送"
    现象（助手截图）：宽度188/高度120/FPS 8/字节数 222688 都正常，
    但画面整体右移约 156 字节，本该在左上角的 FPS 文字跑到右上角。
    判断依据：
    同一份 disp_img 用 cam_view.py（自定义协议）显示时，文字就在左上角
    ⇒ 数据本身没问题，是助手解析时"数据起点"偏了。
    怀疑点：原来包头 8 字节和图像 22560 字节是**两次** wifi_f4_send，
    模块会拆成两个包；若助手按包边界解析，起点就会算错。
    改动（app.c vofa_send_frame）：
    新增 static tx_frame[8 + 22560] 放 CCM（剩余 34KB）
    先 memcp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
2026-11-02 修横向接缝：VSYNC 时 disp_ln 也要归零
    现象：逐飞助手画面出现一条横向接缝，上下两半来自不同的帧。
    （上一版的"整帧一次发送"已经把错位解决了 —— FPS 文字回到了左上角 ✓）
    原因：board_cam_harvest() 的 VSYNC 分支清了
    disp_in_frame / disp_fill / disp_map / disp_armed
    却**漏了 disp_ln**。
    disp_ln 决定"哪些行被抽进图里"（disp_ln % cam_dstep == 0），
    它和真正的帧首不同步，抽到的行就会跨越两帧 ⇒ 接缝。
    代码注释里也写过这个症状："一趟常常横跨两帧 ⇒ 画面出现一条横向接缝
    （位置随机，重启几次碰巧对齐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
2026-11-02 接缝定位：发送那几毫秒里 VSYNC 被推迟，帧首错位约 30 行
    证据：接缝位置**固定**在约 78%（第 90 行 = 120-30），两次截图都一样。
    固定的位置说明不是随机竞争，而是"帧首被系统性推迟了 30 行"。
    30 行 ÷ 120 行/帧 × 帧周期 ≈ 与发送 22.5KB 的耗时同一量级。
    修法（最小改动、零风险）：
    在模式 1 的发送分支里，vofa_send_frame() + cam_tx_row_done() 之后
    **立刻**调用一次 board_cam_harvest()。
    这样发送期间积压的 disp_vsync_flag 马上被处理，下一趟从真正的帧首开始。
    之前两次尝试为什么不成立：
    · 在 zf_send_all 循环里加收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
2026-11-02 按"等一会再取"的思路修接缝：丢掉发送期间迟到的那次 VSYNC
    问题本质：
    发送 22.5KB 期间主循环被占死 ~10ms，这期间来的 VSYNC 是**迟到的**
    （最多晚 30 行）。拿它当帧首 ⇒ 这一趟从帧中间开始
    ⇒ 收满 120 行时跨进下一帧 ⇒ 画面上下错开（接缝）。
    按用户思路"等一会再取"：
    发送结束 → disp_need_fresh = 1
    下一次 VSYNC（就是那次迟到的）→ **只清计数、不武装**（丢弃）
    再下一次 VSYNC（准时的） → 正常武装，从真正的帧首开始收
    ⇒ 这一趟严格落在一帧之内
    cam_f4.c : 新增 volatile uint8_t disp_need_fresh；VSY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
    [board_f4.h]
2026-11-02 🔥 接缝真因：一帧是 240 行（文档 188×240），代码却按 120 行算
    用户指出得对：手册写的是 188×240。
    但 board_cam_set_mode(1) 里写的是 set_span(120)，
    ⇒ cam_dstep = 120/120 = 1（每行都取）
    ⇒ 一帧 240 行里，每趟只抓了**前 120 行**（半帧）
    ⇒ 下一趟抓后 120 行 ⇒ 画面上下来自不同半帧 ⇒ 接缝位置固定（约一半/四分之三处）
    修复：
    board_cam_set_mode(1): set_span(120) -> set_span(240)
    ⇒ cam_dstep = 240/120 = 2（每 2 行取 1 行）⇒ 一趟正好一帧 120 行 ✓
    另外加了一层兜底（自动标定）：
    rows_since_vsync 记录两次 VSYNC 之间实际走了多少行，
    在 V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
    [board_f4.h]
2026-11-02 停用自动标定（它把步长算成 3，画面出现 3 个重复）
    上一版加了"用两次 VSYNC 之间的行数自动标定 dstep"，结果更糟：
    实测测到 360 行 ⇒ dstep = 360/120 = 3 ⇒ 画面上下出现 3 个重复。
    为什么测到 360：**VSYNC 被漏掉了**。
    主循环一忙（analyze 20ms + 发送 10ms），VSYNC 标志会在两次处理之间被覆盖
    ⇒ 三次 VSYNC 只被看到一次 ⇒ 计到 360 行。
    处理：
    1. 自动标定用 if (0) 停用（代码保留，以后可启用）
    2. 固定用文档值：cam_span = 240，dstep = 2
    遗留问题（下一步解决）：
    只要还是"主循环轮询 VSYNC 标志"，就一定会漏。
    正确做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
2026-11-02 真正修接缝：每帧把收割游标对齐到 DMA 写入位置；删掉重复的帧首处理
    发现结构性问题：帧首处理有**两条**路径，互相冲突
    ① VSYNC 中断 → cam_frame_start()：原来**只在开机对齐一次** disp_next_row
    之后每帧只清 disp_fill/armed，**不动游标**
    ② board_cam_harvest() 里的 disp_vsync_flag 分支：清计数但**不动游标**
    ⇒ 结果：每帧都从"上一帧的旧行位置"继续拷
    ⇒ 画面上下两半来自不同的行区间 ⇒ 接缝（位置固定，与实测吻合）
    1. cam_frame_start()：**每一帧**都执行
    disp_next_row = board_cam_write_row();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
2026-11-02 用实测反推：真实一帧 = 120 行（步长 1），保留"每帧对齐"
    两次实验对照（同一份对齐逻辑，只改步长）：
    步长=1（span 120）→ 画面 1 个场景 ⇒ 一帧 = 120 行 ✓
    步长=2（span 240）→ 画面 2.5 个重复 ✗ ⇒ 走 240 行跨了 2 帧多
    ⇒ 结论：真实帧长 120 行，cam_dstep 必须是 1。
    而之前的"接缝"不是帧长问题，是**每帧没有把 disp_next_row 对齐到 DMA 游标**
    （那个已经在上一提交单独修好：每帧 VSYNC 都把游标对齐到 board_cam_write_row()）。
    所以现在这个组合是**第一次同时具备**：
    · 正确帧长（120 / 步长 1）
    · 每帧对齐（VSY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
2026-11-02 修复图传卡在 0.9fps：回退整帧邮箱 + 切回位打包协议
    现象：FPS 只有 0.9，图像基本冻结；心跳 F=0、TO 持续增长、
    W（DMA 当前行号）从 197/236/263 卡住不动，而 f/V 仍在涨。
    用户手动复位后能恢复几秒，再卡。
    两处根因（叠加）：
    1) 逐飞助手协议是 8bit/像素、无压缩，一帧 188x120 = 22568B。
    这条链路实测约 250KB/s，⇒ 11fps 封顶；而且它要占 6 个 4088B 块，
    f=0 时被连续压榨，吞吐掉到 24KB/s（= 0.9fps，与助手"字节/秒 24528"吻合）。
    2) 上一版把 188 模式的采集从"逐行收割"换成了"VSYNC 整帧邮箱"，
    把"采齐"的判据从收割进度改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
    [app.h, cam_view.py, cmd_f4.c, wifi_f4.c]
2026-11-03 修复 188 模式分割线：LINE 间隔识别帧首 + 重启后重写极性 + 关闭 CROP（FW=2055）
    [board_f4.h]
2026-11-03 双边巡线：公共种子（中心列优先/自适应行）+ 断点跨越 + 左右互校正补边（FW=2056）
2026-11-03 双边巡线防抖：种子滞后 + 边界时域平滑 + 帧首行修正/伪边沿剔除（FW=2057）
2026-11-03 巡线标记只画真实爬到的行，去掉种子以下补行造成的两条竖长方形（FW=2058）
2026-11-03 双边巡线改双向爬线：种子向上+向下都沿真实边缘，近场不再竖直复制（FW=2059）
2026-11-05 双边巡线边界数组发上位机：0xFD 包 + PC 用红线画出（FW=2060）
    - cam_f4.c: 删掉图像里涂白标记 lf_draw_edge_marks()，发纯二值图
    - app.c: 新增 cam_send_edges()，整帧包后紧跟 0xFD 左右边界数组(每行2字节, 0xFF=没找到)
    - app.c: 在 cam_tx_row_done()/disp_hold 解冻前发 => 坐标一定对应这一帧
    - cmd_f4.c: CFG 状态行加 FW=2060 EDG/EL/ER
    - cam_view.py: 解析 0xFD -> on_edges -> edge_overlay() 画两条红线(断开不瞎连)，删掉 PC 自己扫边界的旧代码
    - 文档: 新增第 13 节 + 报文/上位机表更新
2026-11-05 修复运行一段时间后图像卡死：板子发送看门狗 + 上位机丢同步自愈
    板子(app.c):
    - 相 2 发送看门狗：一帧超过 300ms+(行数*gap*2) 还没发完 => 放弃这一帧、解冻收割、回相 0
    (以前 wifi_f4_send 一直失败就永远重试, disp_hold 恒 1 => 收割永久停住 => 画面定格)
    - 相 1 的 1 秒无新帧路径也补 disp_hold=0
    - 新增 cam_tx_drop, CFG 里显示 DRP=
    上位机(cam_view.py):
    - 解析提成 parse_stream(), 调用处 try/except => 解析异常不再弄死收数线程
    - 0xFF/0xFD 先验包长 => 假魔数报出的超长包不会再让它永远等
    - tick() 看门狗: 有字节进来却 3 秒没完整帧 => 丢缓冲重找魔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
    [app.h, cam_view.py, cmd_f4.c]
2026-11-05 真凶是 DMA 停摆：加采集自愈看门狗（FW=2061）
    证据（用户贴的 CAM1）: ND=22560 恒不变 ⇒ DMA 一个字节都没搬;
    f 每秒+10 是假的(DMA 不动 => 帧长恒0 => len<90 早退 => 100ms 后走 else 才 f++);
    disp_done 永不置位 => 一张帧都拼不出来 => 上位机没图(之前'卡住'同源)。
    - cam_f4.c: board_cam_poll() 加 DMA 停摆看门狗(NDTR 400ms 不动 => board_cam_restart), 计 cam_dma_stall
    - app.c: 相 1 连续 2 秒没 disp_done => board_cam_restart(), 计 cam_self_heal
    - cmd_f4.c: CFG 加 DST=/SELF=
    - cam_view.py: 文本行上限 130->240(那行 200 字符的 S 心跳以前被整行丢掉), 连上自动发 s
    - doc/memory: 记下这个判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
2026-11-05 去掉连上自动发 s 的握手（调试用，已查到问题）；文本行上限改回 130
    [cam_view.py]
2026-11-05 移植 MSPM0 车模控制层到 F4：电机/编码器/舵机/MPU9250/速度PID（FW=2062）
    - 新增 Core/Src/ctrl_f4.c + Core/Inc/ctrl_f4.h（全部寄存器级，不依赖 HAL 外设模块）
    · 电机 TIM2_CH3/CH4 (PA2/PA3) 17kHz + DIR PB0/PB1，占空比 ±10000
    · 编码器 TIM5 编码器模式3（A/B 4倍频）+ 输入滤波，Z 相 PC0 EXTI0 只数圈
    · 测速 M 法 20ms 窗口，int64 防溢出；速度环照抄原工程（前馈+P+I+斜坡+极性自动识别）
    · 舵机 UART4 PC10/PC11 1Mbps，幻尔协议，改成非阻塞（TXE/RXNE 中断 + 环形缓冲）
    · MPU9250 软 I2C PB8/PB9，20ms 读 14 字节；yaw 照抄原工程 4 点平均+零偏+死区+20ms 积分
    - mai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
2026-11-05 车模命令解析健壮性 + 软I2C速度可配（CTRL_IMU_I2C_DELAY_US）
    - cmd_f4.c: 新增 cam_cmd_next()，w 命令第二参数在 'w2000 2000' 和 'w 2000 2000' 两种写法下都对
    - q 命令正负都限幅到 ±6000
    - ctrl_f4.h: 软 I2C 半周期做成宏（默认 2µs≈250kHz，没上拉时改大）
2026-11-05 加 OLED（SSD1306 128x64，软 I2C PB10/PB11）：开机显示 hello world（FW=2063）
    - ctrl_f4.c: 新增 OLED 段 —— 软 I2C2 + SSD1306 初始化(含 0x8D 0x14 电荷泵)
    + 5x7 ASCII 字体(95字符，放 flash) + 按页写(无 framebuffer，省 1KB RAM)
    + ctrl_oled_text(x,page,str,scale) 支持 1x/2x 字，scale=2 占两页
    + 开机画面 hello/world 两行 2 倍字居中(page 2/4)
    - ctrl_all_init() 里 init→clear→hello（约 40ms，只在开机）
    - 地址自适配 0x3C/0x3D；编译 0 error / 0 warning
    - 文档：代码导读 14.7 + memory 追加
    [cmd_f4.c, ctrl_f4.c, ctrl_f4.h]
2026-11-05 OLED 上电延时 2ms -> 50ms（SSD1306 手册要求），FW 仍 2063
2026-11-05 OLED 状态页：WiFi / MPU / 编码器 / 转速（FW=2064）
    - ctrl_oled_status() 由 board_ctrl_tick() 调用：
    · 4Hz 生成文字，内容没变不重画（strcmp + dirty 位）
    · 每个 20ms 控制拍最多重画一行（2页≈8.6ms），避免按住主循环
    · 每行补空格到 10 字符（120px），长度恒定不留鬼影
    - 布局 page0-1 WiFi OK/E<n>，page2-3 MPU OK/whoami，page4-5 ENC，page6-7 RPM
    - 初始化时探测 0x3C/0x3D 都不应答 => g_oled_ok=0，状态页整个跳过
    - 开机仍先显示 1 秒 hello world
    - 补 #include <stdio.h>（sprintf 隐式声明）
    - 编译 0 error / 0 warning；文档 14.8 + memory
    [cmd_f4.c, ctrl_f4.c, ctrl_f4.h]
2026-11-05 修 OLED 状态页要等 30 秒才出现：开机直接画，不依赖主循环（FW=2065）
    根因: ctrl_all_init() 在 wifi_f4_init() 之前跑, 后者最长阻塞几十秒,
    这段时间 app_loop/board_ctrl_tick 根本没执行 => 屏幕一直停在 hello.
    改法:
    - 去掉 1 秒 hello, 改成 ctrl_all_init() 里调 ctrl_oled_first_page() 整页画一次(~34ms)
    - WiFi 行加中间态 'WiFi --'(初始化中) / 'WiFi OK' / 'WiFi E<n>'
    - 之后才由 board_ctrl_tick() 4Hz 增量刷新
    - 编译 0 error/0 warning; 文档 14.9
    [cmd_f4.c, ctrl_f4.c, ctrl_f4.h]
2026-11-05 OLED 刷新提速：I2C 250k->450k、文字 4Hz->10Hz、脏行一次画完（FW=2066）
2026-11-05 新上位机 car_ui.py（图像+仪表+控制）+ 固件灰度通道/遥测行（FW=2067）
    固件:
    - app.c: 新增 cam_view_mode（0=原图 1=二值图）与 cam_send_gray()：
    从 disp_img 2x2 抽取成 94x60 灰度，分 8 块发 0xFC 包（每块 752B < 4088 事务上限）
    ⚠️ 必须在 board_cam_analyze() 之前发（分析会原地二值化）
    原图模式不进相 2，相 1 里发完灰度+边界后直接回相 0
    - app.c: 10Hz 遥测行 T r= ax= ay= az= gx= gy= gz= y= s= m=
    - cmd_f4.c: 新命令 s 0/s 1 切换图像模式（单独 s 仍回状态）
    上位机:
    - tools/car_ui.py（新）：图像(二值/原图切换+红线) + 仪表(转速/加速度/角速度/偏航/舵机)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
2026-11-06 上位机改成按钮控制台：去掉命令语法，加大按钮/快捷档/急停
    - 图像源: [二值图][原图灰度] 按钮互斥高亮
    - 速度: [停止][前进][后退][归零] + 快捷档 300/600/1000/1500 + 滑条(松手才发)
    - 舵机: [左][中][右] + [-20][+20] + 滑条
    - 其它: [编码器清零][紧急停止]
    - 标签里不再出现 q/r/s/w 之类命令语法；日志只显示板子回执
    - 已用 mock tkinter 验证每个按钮发的命令正确(s 0/1, q ±500, r 2048/2068, l, q0+w0 0)
    - 文档 14/15 节重写(上一版被 PowerShell 转义吃掉了几个字符)
2026-11-06 上位机加电机启动按钮（默认停，只控电机1）+ 一键启动 bat
    - 电机1 区改成：[启动][停止] 两个大按钮 + [前进][后退] 只选方向 + 快捷档 + 滑条
    上电默认 stopped（固件速度环目标本来就是 0，PWM=0）
    启动 = q (方向×滑条值)；停止/急停 = q 0 + w 0 0（两路占空比清零，双保险）
    方向按钮本身不发命令；运行中换方向才立刻重发；滑条拖动不发、松手才发
    - 新增 tools/run_car_ui.bat（自动找 Python、监听 8086）
    - 已用 mock tkinter 验证：默认停、启动 q+500、后退 q-500、停时不误发、急停双发
    - 文档 15.1 更新
2026-11-06 安全：上位机断链时强制停车（FW=2068）
    speed_tick() 里 wifi_f4_is_ready()==0 就把速度目标清 0 =>
    上位机关掉/WiFi 掉线后车不会按最后的目标转速一直跑（遥测 100ms 一次，几百 ms 内发现）
2026-11-06 电机加 PWM 占空比方式：默认 30% 开环，另有转速闭环可选
    - 电机1 区加 [占空比 %] / [转速 RPM] 两个模式按钮（占空比默认，滑条 30%）
    - 占空比方式: 启动发 w ±(滑条%*100) 0 —— 30% => w 3000 0，开环、不依赖编码器
    - 转速方式: 启动发 q ±RPM（速度环闭环）
    - 切模式时先把旧方式清零（PWM->RPM 发 w 0 0，RPM->PWM 发 q 0）
    - 快捷档随模式变：10/20/30/50%% 或 300/600/1000/1500
    - 停止/急停: q 0 + w 0 0（两种方式都能停）
    - mock 测试: w 3000 0 / w -3000 0 / w -5000 0 / q 500 / 切换清零 全部正确
    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
2026-11-06 加电机通道自检按钮：电机1 15% 一秒 -> 停 -> 电机2 15% 一秒 -> 停
    用来判断固件的'电机1/2'到底对应板子上的哪一路（哪个轮子动就是哪一路），
    不用万用表。root.after 排队，界面不卡。
2026-11-06 遥测加 d1/d2（板子实际给电机的占空比），上位机显示'输出占空比'（FW=2069）
    用来区分'电机不转'是固件把输出清零了还是硬件保护/掉电:
    - d1 一直是 3000 而电机停了 => 硬件（驱动 OCP / 电源掉压 / 模块故障）
    - d1 变成 0 => 固件清零（日志里能看到是哪一条命令干的）
2026-11-06 修遥测'一会有一会没有'：T 行改用不重试的发送（FW=2070）
    - wifi_f4_send_string() 每次重试 10 次(最坏7ms)；10Hz 遥测用它等于每 100ms 按主循环 7ms，
    链路上还全是有用数据时非常浪费，实测表现为遥测断断续续、图像也跟着卡
    - 新增 wifi_f4_send_string_nb()：只试一次，发不出去就丢；遥测改走它
    - 上位机：遥测失联阈值 2s -> 3s；'界面运行但板子输出=0%' 时日志里警告一次
2026-11-06 修断链误判导致的'已连接/对方断开'刷屏（FW=2071）
    wifi_f4_send() 的断链判据原来是'连续 150 次没进展'= 150 x 300us ≈ 45ms！
    模块稍微忙一下（图像+遥测一起压）就被判成断链 => wf_ready=0 => 3 秒后重新建 TCP
    （本机端口 6666->6667->6668...）=> 上位机控制台反复刷 已连接/对方断开。
    改成按时间判：连续 2 秒一个字节都没发出去才判断链。
2026-11-06 编码器方向取反（轮子前进时转速为负）；上位机提速 + 命令回执重发
    固件(FW=2072):
    - CTRL_ENC_DIR_INV 0->1：实测轮子往前转、速度显示负数（A/B 相接反）
    - 位打包解包改查表（每帧 2.3 万次循环 -> 2880 次 join），主线程不再被吃满
    => 按钮卡顿/延迟高、收包慢导致的反压都应缓解
    - send_ack(): 发完等板子的 ACK，0.4s 没回执自动重发（最多 2 次），
    仍失败才报'命令没回执' => 解决'按钮要按很多次才有反应'
    - 停止/急停/模式切换/启动/舵机/清编码器 全部走 send_ack
    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
2026-11-06 上位机：新命令顶掉同类旧待确认项（避免'停止'重发把刚启动的电机停掉）
2026-11-06 遥测加序号 + 限帧 20fps + 遥测发送重试 3 次（FW=2073）
    - 遥测行加 n=<序号>；上位机据此算丢包率，状态栏显示 "遥测 9.8/s 丢3%"
    ⇒ "板子没发"(序号不涨) 和 "链路丢了"(序号涨但收到少) 一眼分开
    - 图传默认限到 20fps（用户：20 帧就够了），给遥测/命令留余量
    - 遥测发送 1 次 -> 3 次（最坏约 1ms）：上一版改成 1 次，丢太多，表现为"一会有一会没有"
    - 上位机状态栏改为显示遥测速率与丢包率
2026-11-06 按钮交互改成: 点下变琥珀色 + 每250ms一直重发, 直到板子回 ACK 才恢复颜色
    - send_ack(cmd, pfx, note, btn): 点击后按钮立刻变 #b8860b(琥珀)
    - _check_pending: 每 250ms 重发一次, 最多 80 次(约20秒), 期间按钮保持琥珀
    - 收到 ACK (_ack_seen): 恢复按钮原色, 再按当前真实状态重新上色
    - 同前缀的新命令顶掉旧命令, 并把旧按钮颜色恢复(避免停止的重发杀掉启动)
    - 断线时 _clear_pending 把待确认全清掉、颜色恢复
    - 等回执的按钮不会被 update_speed_ui/refresh_buttons 的状态刷新覆盖(_is_waiting)
    - mock 测试: 变琥珀 -> 超时重发 -> ACK 后恢复 -> 断线清理, 全部通过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
2026-11-06 舵机：开机自动扫 ID + 应答两种格式都认 + 诊断 (rx字节/校验错)（FW=2074）
    - 原来 ID 写死 1；舵机 ID 不对就永远读不到 => 开机等 1 秒后扫 0~20 号，谁应答用谁
    - 读位置应答兼容两种固件格式：LEN=4(不带地址) 和 LEN=5(带 0x38 地址)
    - 新增 crx 计数：g_servo_rx_bytes(收到多少字节) / g_servo_rx_bad(校验错帧数)
    - 遥测加 si=(ID) sr=(rx字节) sb=(校验错)；上位机舵机行显示
    '--- (ID 1, 收到 0 B, 校验错 0)' => 0 字节=没接线/没供电/波特率不对
2026-11-06 run_car_ui.bat 加 chcp 65001 + PYTHONIOENCODING/UTF8（避免控制台编码导致启动就崩）
2026-11-06 修快捷档按钮初始显示 '--'：创建时就用当前模式的档位值（默认 10/20/30/50%）
2026-11-06 舵机：开机自动试波特率(1M/500k/250k/115200/57600/19200/9600) + 全链路诊断（FW=2075）
    代码复查结论：UART4 的引脚(AF8 PC10/PC11)、BRR(42->0x2A0)、CR1、NVIC、TXE/RXNE 中断、
    环形缓冲、校验/解析都对；找不到移植 bug，加指标让它自己说话：
    - st = 真正从 TX 出去的字节数（0 => TX 根本没工作）
    - sr = RX 收到字节数（0 => 信号没回到 PC11）
    - sl = PC11 当前电平（0 => 线被拉低/短路）
    - sba = 当前波特率(kbps)，开机自动挨个试，收到任何字节就认定这档
    - 上位机显示 '--- (ID 1, 1000k, 发0B 收0B 校验错0)' 形式
    [car_ui.py, cmd_f4.c, ctrl_f4.c, ctrl_f4.h]
2026-11-06 舵机 10000bps 支持：低速必须 OVER8=1（16 倍过采样下限约 10255）（FW=2076）
    根因：42MHz APB1 + OVER8=0 时 USARTDIV 最大 4095 => 最低只能 10255bps，
    10000bps 的 USARTDIV=4200 超范围，BRR 被截断 => 实际波特率乱 => 一个字节都收不到。
    - servo_set_baud(): div>4095 自动切 OVER8=1，USARTDIV=fCK/(8*baud)=525 => 精确 10000.0bps
    - CTRL_SERVO_BAUD 默认改 10000；开机扫描顺序 10000 优先，共 11 档
    - 超时按波特率放大：servo_wait_ms()（10000bps 一帧 8ms，原来的固定 10ms 太紧）
    - init 改用 servo_set_baud() 统一算 BRR
    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
2026-11-06 舵机默认波特率改回 1M（用户确认是 1000000），扫描顺序 1M 优先（FW=2077）
    OVER8 自动切换保留（10000bps 仍然在扫描列表里）
2026-11-06 舵机扫描修两处设计问题 + 波特率显示改原始值（FW=2078）
    截图暴露出：显示 '4k' = 扫描跑到最后一档 4800 就停了，而且收 0B。
    1) 扫描顺序改成：先用默认波特率(1M)把 ID 0~20 **完整**扫一遍，
    不行再换档（每档只喊 0~5 号看有没有回音）。旧版每档只喊 0~5，ID>5 就永远发现不了
    2) 全都没找到时**恢复默认波特率 1M**（旧版停在 4800，之后读写全用错波特率，
    就算后来接线好了也永远通不了）
    3) 遥测 sba 改传原始 bps，上位机显示 1M/115.2k 这类，不再出现 '4k'
    [car_ui.py, cmd_f4.c, ctrl_f4.c]
2026-11-06 舵机：改回最简单的 1M 单波特率扫描 + 运行时自动发现（不用重启）（FW=2079）
    用户反馈'这套代码以前成功读到过角度'，说明驱动本身没问题；问题在扫描逻辑越改越复杂。
    - ctrl_servo_scan 只做一件事：1M 下扫 ID 0~20（去掉 11 档波特率扫描，开机不再慢 1~2 秒）
    - 运行时如果 g_servo_pos 还是 0xFFFF：每 20ms 换一个 ID 发读位置（0~20 轮询，不阻塞）
    => 换线/接线正确后最多 420ms 自动发现并锁定 ID，不需要重启板子
    - servo_poll 收到任何合法回包就 g_servo_id = 回包 ID（自动锁定）
    [cmd_f4.c, ctrl_f4.c]
2026-11-06 舵机加'单线半双工'运行时切换（FW=2080）：r -1 单线 / r -2 全双工
    - ctrl_servo_set_half(): HDSEL + PC10 改 AF_OD+上拉（半双工必须开漏，否则推挽顶死回包）
    - 命令 r -1 / r -2；上位机舵机面板加两个按钮（走 ACK 重发）
    - 半双工接线：只接 PC10 一根线 + GND
2026-11-06 修遥测'又没了'：文本按行缓冲 + 遥测降到 5Hz（FW=2081）
    - 上位机 on_text 原来把 TCP 分包的**半行**直接当整行处理（150 字节的遥测行很容易被切开）
    => 半行要么被丢，要么解析出乱七八糟的值；现在先攒到 '\n' 再处理
    - 遥测从 10Hz 降到 5Hz：T 行现在带 si/sr/sb/st/sba/sl，150 字节 x10/s 对模块压力偏大
2026-11-06 修'看不到切换键'：右侧面板改可滚动 + 窗口 1220x880
    根因：右栏 6 个面板（图像源/实时数据/电机1/舵机角度/其它/板子回话）在 560 高的窗口里
    被挤到屏幕外面，舵机角度面板（含新加的 全双工/单线半双工 按钮）根本看不见。
    - Canvas+Scrollbar 包裹右栏，任意窗口大小都能滚到，支持鼠标滚轮
    - 默认窗口 1180x560 -> 1220x880
    - 截图验证：舵机面板、全双工/单线半双工 两个按钮均已可见
2026-11-06 链路'连上了但一个字节都不发'：重连 3 次后整模块硬复位（FW=2082）
    现场取证（截图+控制台）：
    - 上位机状态栏 帧率0.0 收0B/s，图像是冻住的最后一帧（画面里的 FPS:13.3 是板子烧进去的）
    - 控制台反复刷 [已连接] / [对方断开]，本机端口 6666->6667->6668 一直变
    => 模块的控制通道还能应答 TCP，但数据通道卡死（INT 一直低=一直忙），
    原来只重连 socket 救不回来。
    现在：连续重连失败 3 次 -> wifi_f4_init()（拉 RST 整模块重启 + 重连热点/上位机）
2026-11-06 下行命令收不到的真凶：wifi_f4_read 每轮最多等 1.6ms 仍读不到，且压满了主循环（FW=2083）
    用户日志：点'单线半双工' -> r -1 重发 20 次都没有 ACK，但图像在动
    => 上行通、下行死。根因在 wifi_f4_read():
    - 模块忙(INT 低)时等 8x200us=1.6ms，等不到就 return 0
    - 而 cam_cmd_poll() 主循环每轮都调它 => 主循环大部分时间耗在等待里，
    图像收割被拖慢，命令还是读不到 => '按钮按很多次才有反应'
    - 等待缩短到 3x100us=300us，等不到就放过这一轮（主循环很快，下一轮立刻再来）
    - 图传默认 20fps -> 10fps，把模块负载降下来，先验证下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
2026-11-06 下行命令丢失的根因修复：模块忙时不再整轮跳过读取（FW=2084）
    现场：图像上行正常，但 r -1 重发 20 次都没有 ACK。
    根因：wifi_f4_read() 里 if (0 == INT) return 0; —— 模块被 20fps 图像压得 INT 长期为低，
    这个函数**每次都在这一行返回**，PC 发来的命令从来没被取走（下行彻底饿死）。
    改法：忙时只让 100us，然后**照样去读**；模块真没数据时包头不是 0x90/0x91，
    got=0，无副作用。
    [cmd_f4.c, wifi_f4.c]
2026-11-06 文本被图像饿死：遥测/回执改进发送队列，主循环每轮 pump（FW=2085）
    现场：图像正常，遥测和 ACK 全都没有。
    根因：图像在 cam_tx_tick() 里**每轮主循环都重试**抢空闲窗口，文本只有 3~10 次机会
    （wifi_f4_send_string / send_string_nb）=> 模块一忙，文本一条都发不出去。
    - wifi_f4.c 加文本队列 wifi_f4_text(pri) + wifi_f4_text_pump()
    pri=1 回执/状态（不会被覆盖），pri=0 遥测（可覆盖）
    - app.c 主循环每轮调 pump，文本和图像平权
    - dbg_txt / cmd_txt / 遥测 全部改走队列
    - RAM 占用 +192B，剩余约 1.1KB
    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
2026-11-06 舵机噪声把主循环吃干 → 遥测/按键全没了（FW=2086，用户诊断正确）
    用户判断：实时数据是改单线之后才没的 —— 对的。机制：
    - 舵机线没接对/PC11 悬空时，这条 1Mbps 线收到的是连续噪声
    - RXNE 中断可达每秒十万次，servo_poll 还在逐字节解析+memmove
    => 主循环被吃干：遥测发不出、命令处理不过来、图像掉帧
    修法（三道保险）：
    1. servo_poll 每拍最多处理 256 字节，剩下的直接丢
    2. 触发上限就**关掉 RX 中断静默 500ms**，之后再自动恢复，避免中断风暴
    3. 没找到舵机时的轮询从每 20ms 一次改成每 100ms 一次（少发无效帧）
    正常舵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
2026-11-06 文本发送：给更长的空闲等待(2ms) + 把发送计数塞进包头让界面可见（FW=2087）
    - 文本和图像原来都用 300us 预算，模块忙时文本永远抢不到 => 遥测/ACK 一条都出不去
    文本只有 5Hz、150 字节，等 2ms 完全值得（25ms/s ≈ 2.5%）
    - 图像包头空字节 10/11 塞 '文本成功/失败次数'，上位机状态栏直接显示
    => 以后不用靠遥测也能判断板子有没有发文本
    PC 侧已用混流测试验证：图像包 + 遥测行随机切块喂进去，遥测 5/5 全部解析正常
2026-11-06 文本专用时间窗：每秒 30ms 图像让路，保证遥测/ACK 发得出去（FW=2088）
    争抢方向没戏：图像在主循环里每轮重试，文本 5Hz 只有几百次机会，模块一忙就全丢。
    改成确定性方案：每秒开一个 30ms 的窗口，窗口内**不发图像**，模块必然空闲 ⇒ 文本必发出去。
    帧率损失约 3%，换来遥测和命令 100% 可靠。
2026-11-06 舵机默认走单线半双工（FW=2089）
    按用户要求：开机默认 HDSEL 单线 —— 数据只走 PC10 一根线 + GND，
    PC10 配成开漏+上拉（推挽会顶死回包）。运行时仍可用 r -1 / r -2 切回全双工。
    另外 ctrl_servo_rx_pin() 在单线模式下改读 PC10，诊断才对得上。
2026-11-06 单线模式改成'软件半双工'：推挽发 + TC 后释放总线（FW=2090）
    现象'发多少收多少'= 只收到自己的回显。根因：硬件 HDSEL 下 PC10 是开漏，
    靠内部 40k 上拉在 1Mbps（1 位 1us、上升沿要 2us）根本拉不高 ⇒ 舵机收到垃圾。
    - 不用 HDSEL。PC10 平时高阻输入，发之前切推挽 AF
    - ISR 里等 TC（最后一个位移出）立刻把 PC10 放成输入，总线让给舵机
    - PC11 始终是 UART4_RX
    接线：PC10 与 PC11 并接到总线那一根线 + GND
    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
2026-11-06 舵机默认改回全双工（FW=2091）：TX=PC10 / RX=PC11，PC10 保持推挽 AF，不做高阻切换
2026-11-06 按官方文档恢复多波特率扫描（FW=2092）
    文档自相矛盾：使用手册第1页写 115200，第4页规格表和协议文档写 1000000。
    官方 STM32 例程是 1M + rx_timeout=10ms。
    => 开机扫 1M / 115200 / 500k / 250k / 57600 / 38400 / 19200 / 9600 / 10000 / 4800，
    每档扫 ID 0~20，等待时间按波特率自动放大；都不中再恢复 1M。
2026-11-06 加'停图传'开关（s 2 停 / s 3 恢复）（FW=2093）+ 上位机按钮
    用途：调遥测/命令时把图像彻底关掉，让链路完全空闲，排除'图传抢满链路'这个变量。
    - 固件：cam_img_off 标志，cam_tx_tick 直接返回 0，边线包也不发
    - 上位机：图像源面板加 [停图传] [恢复图传] 两个按钮（走 ACK 重发）
2026-11-06 默认停图传（FW=2094）：开机只跑遥测/命令，要看图点【恢复图传】(s 3)
2026-11-06 遥测被心跳饿死：dbg_txt 改回低优先级（FW=2095）
    根因（我自己引入的）：文本队列里 S 心跳(448B, 500ms一条)是 pri=1 高优先级，
    遥测 T 是 pri=0，队列里几乎永远有待发的心跳 => 遥测每次都被
    if (已有待发 && 待发优先级 > 本次) return; 直接丢掉，一条都发不出去。
    CAM FOUND 能收到正是因为它也是 pri=1，能顶掉心跳。
    现在心跳/诊断 = pri 0（可覆盖、丢了无所谓），只有命令回执 cmd_txt 保持 pri 1。
2026-11-06 修'上位机一直收不到遥测'的真凶：S 心跳被截成半行，把每条遥测都粘死了（FW=2096）
    现场：TCP 已连接、网卡稳定收 ~33KB/s（10fps 图像在到），但遥测一直 ---。
    真凶在文本队列：
    1) wf_txt_buf[192]，而 S 心跳一行约 203B ⇒ strncpy(...,191) 把行尾的 \r\n 截掉了；
    上位机按 \n 切行、只认 T/ACK/CFG/CAM 开头 ⇒ 这半行会和下一条文本粘成
    'S f=...GP=0T n=1234 ...' ⇒ 整行被丢。
    2) 主循环里遥测(200ms)先入队、心跳(500ms)后入队，两者在 1000ms 整倍处同拍
    ⇒ 心跳顶掉遥测、并且紧跟着发出去 ⇒ 之后每条遥测都粘在它后面被丢。
    改：
    - wf_tx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
2026-11-06 加《舵机读取问题说明》文档：现象/已确认事实/已排除方向/剩余可能性/验证步骤
2026-11-06 真凶抓到了：读事务每轮往发送流里漏 32 个 0x00（25KB/s），把每行遥测都裹死（FW=2097）
    抓包（自带 listener 接 8086 收 20s 原始字节）：
    - 504264 B / 20s，其中 95% 是 0x00；魔数出现 0 次（2094+ 默认停图传，正常）；
    - T 行 103 条、序号 95..197 全连续 ⇒ 遥测一直在发且完整；
    - S 行只剩后半截，且每 4088B（模块缓冲）出现一次 S 尾巴。
    零的来源：wifi_f4_read() 用 wf_xfer_command(&p, 32)，不管模块有没有数据都硬 clock
    32 字节，模块把它们当透传数据发到 TCP ⇒ ~800 次/秒 × 32B ≈ 25KB/s；还把 4KB 缓冲
    挤满、截断文本。上位机 on_text() 的 '整行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
2026-11-06 舵机问题说明文档精简：只保留前 5 节（概括/硬件参数/现象/已确认事实/已排除方向）
2026-11-07 修'已连接但 0 B/s 只能断电'：重连别再用 50 秒阻塞 + SysTick 提到最高优先级（FW=2098）
    现场：PC10/PC11 只是短接（舵机已摘掉），板子数据瞬间变 0，上位机仍显示已连接。
    两条链：
    1) wf_ready 被清 0 后，wifi_f4_retry() 里的 wf_socket_connect() 用 WF_TO_SOCKET=50s 等模块应答。
    模块若揣着一个半死的 socket（INT 长期低），这个等就是满的 ⇒ 主循环被按住 50 秒
    ⇒ 上位机看到的就是'已连接 + 0 B/s'，只能手动复位。
    ⇒ 重连改为 1.5s 超时；relink_n>=2 就整模块硬复位（原来要 3 次）。
    2) HAL_Init 把 SysTick 设成 15（最低），而 UART4=6 / DCMI=5 /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
2026-11-07 加'链路见证人'：上位机保活 6 秒收不到就自己重连/整模块复位（FW=2099）
    现场：PC10/PC11 短接后上位机一直'已连接 + 0 B/s'，2098 的 SysTick/50s 修复无效
    ⇒ 说明真正的问题是 **板子根本发现不了链路已死**：
    模块被复位/掉线/揣着半死 socket 时，SPI 写照样成功（模块照收、只是发不出去），
    wf_send 不报错、wf_ready 一直是 1 ⇒ 永远往黑洞里发，只能断电。
    - 上位机每 2 秒发一行 '!'（板子只计数、不回包）；
    - 板子见过 '!' 之后，6 秒收不到就 wifi_f4_force_relink() ⇒ 清 wf_ready；
    连续失败 2 次走 wifi_f4_init() 整模块硬复位；
    - 老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
    [app.h, car_ui.py, cmd_f4.c, wifi_f4.c, wifi_f4.h]
2026-11-07 OLED 卡死=主循环停了：加主循环看门狗(6s 自动复位) + 面包屑 LM= + OLED 心跳符（FW=2100）
    现场：并上 PC10/PC11 后 OLED 直接定格 ⇒ 主循环停了（不是链路问题）。
    上一版(wf_ready/保活)治的是'链路死但板子以为活着'，这条治的是'板子自己停了'。
    - stm32f4xx_it.c：SysTick（优先级 0，谁也抢不走）里看 g_loop_tick，6 秒没踩脚印
    ⇒ 把 g_loop_mark 写进 RTC->BKP6R ⇒ NVIC_SystemReset()；
    wifi_f4_init() 期间用 g_wdt_pause 暂停（那段本来就要阻塞几十秒）。
    - stm32f4xx_it.c：MemManage/BusFault/UsageFault 原来是 while(1)（故障优先级最高，
    一旦进去连 SysTick 都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
    [app.h, car_ui.py, cmd_f4.c, ctrl_f4.c, main.c]
2026-11-07 开机阶段显示 BOOT n + 舵机扫描硬上限 6 秒，专治'并上 PC10/PC11 就卡死'（FW=2101）
    现场：PC10/PC11 并上后立刻卡死；接上后重启依旧卡死（OLED 定格、0 B/s）。
    开机唯一碰 UART4 的就是 ctrl_servo_init()->ctrl_servo_scan()：
    每发一帧立刻收到自己的回显，而 servo_probe_id 的等待是
    while (HAL_GetTick()-t0 < 5ms)；2098 以前 SysTick 是最低优先级(15)、UART4 是 6，
    时间基准一停这个循环就永远不出来 ⇒ 开机卡死 ⇒ WiFi 永远不初始化 ⇒ 断电也没用。
    - ctrl_servo_scan()：整个扫描加 6 秒硬上限，超时立刻放弃（不再把开机卡死）。
    - ctrl_oled_boot()：开机每阶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
2026-11-07 舵机驱动整体换成 MSPM0 原工程 hx_servo.c 的写法：同步轮询、彻底不用 UART4 中断（FW=2103）
    按用户要求，把舵机相关代码换成
    MSPM0G3507 E01_gpio_demo/user/src/hx_servo.c 的实现。
    原实现（中断 + 环形缓冲 + 主循环状态机）的问题：PC10(TX)/PC11(RX) 一并起来后，
    板子会把自己发的每一帧都收回来 => RXNE 中断不断；2098 以前 SysTick 是最低优先级
    => 时间基准被饿死 => 所有 while(HAL_GetTick()...) 永不超时 => 开机卡死、重启也卡死。
    新实现（1:1 对应原工程）：
    - servo_tx_frame() <- hx_tx_frame()：组帧 FF FF ID LEN INSTR P.. CHK
    - servo_rx_byte() <- hx_rx_byte(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
    [cmd_f4.c, ctrl_f4.c, ctrl_f4.h]
2026-11-07 舵机固定 ID=1 / 1Mbps，去掉 ID 扫描（FW=2104）
    用户明确：总线舵机 ID 固定是 1，波特率固定 1000000，不用找。
    - ctrl_servo_scan()：删掉 "0~20 号挨个 PING" 的循环，改成
    固定 g_servo_id = CTRL_SERVO_ID(1) + servo_set_baud(1000000)，
    只 PING 一次，把"通没通 / 报没报错"填进诊断量（约 1~2ms）。
    - 开机不再为找 ID 反复发帧（那条路径在收发短接时会一直空转）。
    - FW=2104。
    Keil 0 error 0 warning；RAM 129800/131072（剩 1272B）。
    [cmd_f4.c, ctrl_f4.c, ctrl_f4.h]
2026-11-07 回环"发 1644B / 只收 549B"：补 64 字节软件 FIFO，等 TXE 时也搬 RX（FW=2105）
    现场：把 PC10(TX)/PC11(RX) 短接做回环，遥测显示 发1644B 收549B。
    原因不是引脚坏：F4 的 UART 只有 1 个字节接收寄存器，1Mbps 下字节间隔 10µs；
    同步驱动在发送时 CPU 一直盯 TXE，没空读 RX => 回显在发送过程中就 ORE 溢出丢掉。
    （这正是 MSPM0 原工程注释里"必须打开 FIFO，否则 1 字节缓冲接不住"的同一件事。）
    - 加 64 字节软件 FIFO（servo_rx_pump / servo_fifo_get），
    servo_rx_byte 每圈都 pump；
    - servo_tx_frame 里"等 TXE"的循环也 pump RX => 发送期间的 10µs 空隙也在收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
2026-11-07 单线总线：发完等 TC 再放开 PC10（高阻），默认走半双工（FW=2106）
    对照官方 HX_30HM 二次开发文档：帧格式逐字节一致（PING 0x01 / READ 0x02 /
    WRITE 0x03 / 0x2A 位置 / 0x2E 速度 / 0x21 模式）。官方 F103 例程能直接用推挽
    USART2，是因为中间有幻尔调试板做半双工转换。
    现场是把舵机直接并在 PC10/PC11 上 => 必须发完释放总线，否则 PC10 一直推挽拉高，
    舵机回包被顶住，永远收不到应答。
    - 新增 servo_bus_drive() / servo_bus_release()：PC10 MODER 推挽AF <-> 高阻输入；
    - servo_tx_frame()：发之前 drive，**等 TC（最后一位真的移出去）**再 release；
    - ct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
2026-11-07 有调试板 => 全双工（PC10/PC11 分开走，不要并），波特率自动试 1M / 115200（FW=2107）
    用户确认：舵机是 HX-10HM，并且**有幻尔调试板**。
    关键纠正：有调试板时是**全双工**——
    PC10(UART4_TX) -> 调试板 RX
    PC11(UART4_RX) <- 调试板 TX
    GND 共地；舵机接调试板的总线口。
    把 PC10 和 PC11 并在一起是错的：MCU 的 TX 输出和调试板的 TX 输出会在同一个节点对拉，
    线被打死 => 接收端收到一堆垃圾/自己的回显 => 老版中断驱动直接卡死。
    - CTRL_SERVO_HALF_DUPLEX_DEFAULT 改回 0（全双工，PC10 一直推挽 AF）。
    - 波特率：开机 1M -> 115200 各 PING 一次，谁应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
2026-11-07 ★★ 真凶：UART4 的波特率被算小了 16 倍（BRR 多移了 4 位），舵机一直在 62.5k 上收乱码（FW=2108）
    用户：硬件肯定没问题，MSPM0 工程能通，就是 F407 联系不上舵机。
    查 UART4 的 servo_set_baud()（这段从最早的版本一直沿用到刚才）：
    div = fCK / bps; // 42MHz/1M = 42
    UART4->BRR = div << 4; // → 672
    但 OVER8=0 时：
    波特率 = fCK / (16 × USARTDIV) ⇒ USARTDIV = fCK/(16×bps)
    BRR = USARTDIV × 16 ⇒ BRR = fCK / bps （整数就是完整 BRR，不能再 <<4）
    所以旧代码 BRR=672 ⇒ USARTDIV=42 ⇒ 实际波特率 = 42e6/(16×42) = 62500。
    舵机是 1Mbps，收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
    [cmd_f4.c, ctrl_f4.c]
2026-11-07 上位机舵机面板加 ±50 步进按钮（每点一下目标位置 ±50 步，约 4.4°）
    - 舵机面板第 2 行改为 −50 / −20 / +20 / +50 四个步进按钮
    - do_servo_nudge(d, btn) 支持传按钮：下发前夹在 SERVO_MIN..SERVO_MAX 内
    - 同步更新文件头说明
2026-11-07 板子解析下行时没滤掉模块填充的 0x00 => 所有命令都落到 default 只回 CFG（FW=2109）
    现场：上位机点按钮一直重发，板子没有 ACK。用假上位机直接发 r 2098 / h / ! 复现：
    每条命令板子都回了一条 CFG（default 分支），从来没有 ACK r。
    真凶：模块把下行数据放在 32 字节块里，前面补了一堆 0x00；cam_cmd_poll() 把这些 0
    当成命令字符塞进 cam_cmd_buf => cam_cmd_line() 看到的第一个字节是 0x00
    => switch(0) 落到 default => 只回状态，r/h/! 这些命令永远匹配不上。
    （上位机那边早就做了同样的 NUL 过滤，板子这边漏了。它同时也是
    cam_ka_seen 一直没置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
2026-11-07 舵机行程改为：中位 2748 / 最小 1700 / 最大 4000（FW=2110）
    按用户实测的安全行程改：
    - ctrl_f4.h：CTRL_SERVO_POS_MIN 1048->1700，MAX 3048->4000，CENTER 2048->2748
    （开机第一次节拍会把舵机摆到 2748；set_pos 超出范围会被夹住）
    - car_ui.py：SERVO_MID=2748，SERVO_MIN/MAX=1700/4000，
    左/右快捷档直接取两个端点；滑条范围跟着变；标签初始值显示 2748
    - cmd_f4.c：命令帮助里的说明同步
    Keil 0 error 0 warning；RAM 129872/131072（剩 1200B）。
    [car_ui.py, cmd_f4.c, ctrl_f4.h]
2026-11-07 舵机最大行程 4000 -> 3024（中位 2748 / 最小 1700 不变）（FW=2111）
    - ctrl_f4.h：CTRL_SERVO_POS_MAX = 3024（4000 会顶到机械限位）
    - car_ui.py：SERVO_MAX = 3024，滑条/左右快捷档/±50 步进跟着夹紧
    - cmd_f4.c：命令帮助同步
    Keil 0 error 0 warning。
    [car_ui.py, cmd_f4.c, ctrl_f4.h]
2026-11-07 图传恢复 + 电机闭环 500RPM + 防堵转(PC2 重启) + OLED 状态提示（FW=2112）
    1) 图传：cam_img_off 默认 1 -> 0，开机就发图（要停仍可 s 2 或点【停图传】）。
    2) 电机：新增 motor_supervisor()，由 board_ctrl_tick 每 20ms 调用一次：
    - 主循环一开始就 ctrl_speed_set_target(500)，闭环巡航（CTRL_RUN_AUTO_START 可关）；
    - 实测转速连续 2 秒低于"目标的 80%"（500 -> 400 RPM）判堵转 => 目标清零停机；
    用 80% 而不是"低于目标"，是为了不把 PI 稳态的几 RPM 误差误判成堵转；
    - 停机后 PC2 按低电平 => 解除堵转并重新起转；
    - 目标为 0（正常停车）时不做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
2026-11-07 图传默认 10fps -> 6fps（给遥测/ACK 让出带宽）+ 堵转判断加 3 秒起转宽限（FW=2113）
    实测（图传打开后）：25 秒只收到 7 条 S + 5 条遥测（正常 50 + 125），S 行还被截断。
    原因：10fps × 2894B ≈ 29KB/s，接近模块实测吞吐（25~33KB/s）=> 文本挤不出去
    => 上位机点按钮收不到 ACK，看起来"没反应"。
    - cam_cmd_fps 10 -> 6（≈17KB/s，留约 10KB/s 给文本）。想要更快可发 f 8，但回执可能再丢。
    - motor_supervisor 增加 CTRL_STALL_GRACE_MS=3000：起转后 3 秒内不做堵转判断
    （起步转速天然是 0，原来的 2 秒窗口会把起步误判成堵转）。
    FW=2113；Keil 0 error 0 warn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
    [cmd_f4.c, ctrl_f4.c, ctrl_f4.h]
2026-11-07 先关掉堵转保护：CTRL_STALL_ENABLE = 0（FW=2114）
    用户要求先停掉堵转保护，让电机能一直转。
    - ctrl_f4.h 新增 CTRL_STALL_ENABLE（默认 0 = 关）；改回 1 就恢复保护。
    - ctrl_f4.c：堵转检测块整体用 #if 包起来（关掉时连 s_below_cnt 都不编译，避免 unused 警告）。
    - 电机仍然：上电自动闭环 500RPM 巡航；OLED 第 1 行显示 RUN 500 / STOP
    （保护关掉后不会再出现 STALL PC2）。
    - 图传保持 6fps（上一版为了给文本让带宽）。
    FW=2114；Keil 0 error 0 warning；RAM 129880/131072（剩 1192B）。
    [cmd_f4.c, ctrl_f4.c, ctrl_f4.h]
2026-11-07 占空比上限 50% -> 80%（500RPM 在 50% 就顶住了）（FW=2115）
    现场：闭环目标 500RPM，转速稳定不到 500。
    CTRL_SPEED_DUTY_MAX = 5000（50%）会让速度环在 50% 就饱和 —— 若电机此时还到不了 500，
    表现就是"怎么都稳不住 500"。先放到 8000（80%）以排除"限幅"这个因素。
    注意：如果编码器 CPR 不准（CTRL_ENC_CPR 现在按 4096 猜测），测出来的转速本身偏低，
    闭环会一直加大占空比也追不上 —— 那种情况要先用"手转一圈看 enc 涨多少"标定 CPR。
    FW=2115；Keil 0 error 0 warning。
    [cmd_f4.c, ctrl_f4.h]
2026-11-07 测速改用真实 dt（不再写死 20ms）+ 上位机把收到的行全写进 tools/log_*.txt（FW=2116）
    【先看数据】
    用新加的上位机记录文件抓了 173 条遥测：
    duty 稳在 2590~2740（基本不动）
    rpm 却在 405~519 之间乱跳，平均 430
    占空比不抖、只有读数抖 => 不是控制环振荡，是**测速不准**。
    根因：encoder_tick() 里 RPM 固定按 CTRL_PERIOD_MS(20ms) 算，
    而 board_ctrl_tick() 的实际周期会被图传发送、舵机同步读（各 1~3ms）拖到 22~30ms
    => 同一段编码器增量被当成 20ms 的 => 读数忽高忽低。
    - encoder_tick(uint32_t dt_ms)：用 board_ctrl_tick 实测的 dt 算 RPM（夹在 1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
2026-11-07 测速改 µs 精度（DWT）+ 转速一阶低通：压掉 500RPM 的 ±25 抖动（FW=2117）
    【数据（用户上位机的 log_20261107_134139.txt，188 个转动中采样）】
    rpm min=466 max=526 avg=500.1 std=24.4 |rpm-500| 平均 16.9
    duty min=2824 max=3212 avg=2880 std=39.7
    => 平均值正好 500，是 ±25RPM、周期约 2s 的慢摆；占空比很稳 => 环没问题，是测速噪声。
    来源：20ms 窗口用 HAL_GetTick 的 ms 计时，±1ms = ±5% => 500RPM 正好 ±25。
    - board_ctrl_tick 用 DWT->CYCCNT 算真实间隔（µs），encoder_tick_us() 用它算 RPM
    （RPM×10 = d×6e8/(CPR×dt_us)），分辨率约 6ns。
    - speed_tick 对实测转速做一阶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
    [cmd_f4.c, ctrl_f4.c]
2026-11-07 重新打开堵转保护（CTRL_STALL_ENABLE = 1）（FW=2118）
    行为（和之前设计一致）：
    - 电机闭环巡航 500RPM（上电自动起转）；
    - 起转后先给 3 秒宽限（CTRL_STALL_GRACE_MS），起步阶段不判断；
    - 之后实测转速连续 2 秒低于「目标的 80%」(500 -> 400RPM) => 判堵转，目标清零停机；
    - 停机后按 PC2（低电平有效，内部上拉）重新起转；
    - OLED 第 1 行：RUN 500 / STALL PC2 / STOP。
    前提：测速已在 FW=2117 改成 DWT µs 计时 + 一阶低通，
    抖动从 ±30RPM 降下来后，80% 阈值就不会被噪声误触发。
    FW=2118；Keil 0 error 0 warning；RAM 129888/131072（剩 1184B）。
    [cmd_f4.c, ctrl_f4.h]
2026-11-07 堵转保护在**占空比(开环)模式下也生效** + PC2 改边沿触发 + 遥测加 k1/ol（FW=2119）
    用户："我在占空比模式下把速度压到 300，堵转保护没反应"。
    两个原因：
    1) motor_supervisor 里还留着 if (g_open_loop) return; —— 开环时整个保护被跳过。
    2) 开环判定本来就没有参照物：原来只拿"闭环目标转速"做比较。
    另外 PC2 用**电平**判断，按键卡住/常低时会立刻把自己解除，看起来就像"保护不动作"。
    - 开环判定：占空比 ≥ CTRL_STALL_DUTY_MIN(300，即 3%) 而转速 < CTRL_STALL_OPEN_RPM(50)
    持续 2 秒 ⇒ 判堵转停机（并 ctrl_motor_set(..,0) 确保真的停）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
2026-11-07 全局堵转判据：实测转速 < 400RPM 持续 2 秒就关电机（不再分模式）（FW=2120）
    用户要求原话："做一个全局读转速，转速低于 400 长达 2s 就关电机"。
    原来那些目标×80%、开环占空比阈值、起转宽限全部删掉，只剩一条：
    实测转速 < CTRL_STALL_RPM(400) 持续 CTRL_STALL_MS(2 秒) => 关电机
    · 闭环 500、开环占空比、上位机没连 —— 全一样判；
    · 唯一例外：占空比 0 且目标 0（本来就没驱动）=> 不算堵转；
    · 关电机后 OLED 显示 STALL PC2，按 PC2（松开→按下）重新起转 500RPM。
    头文件同步精简：删掉 CTRL_STALL_PCT / CTRL_STALL_GRACE_MS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
    [cmd_f4.c, ctrl_f4.c, ctrl_f4.h]
2026-11-07 PC2 一直是低电平（k1 全 0）导致重启无效 => 改成任意按键电平变化即可重启 + q 也能重启（FW=2121）
    【日志证据】tools/log_20261107_140610.txt（242 条遥测）
    k1 取值分布: {0: 242} <= PC2 **从头到尾都是低电平**
    时间线：n=31~39 rpm 掉到 319~388（duty 3000）=> n=41 d1=0 ol=0（堵转停机成功）
    之后 200 多拍一直 r=0 d1=0，按键没有任何电平变化 => 重启永远不触发。
    原因：PC2 配置为输入上拉、按下为低；但实测一直是低 => 按键卡住/常闭/板上有下拉，
    "先松开再按下"的边沿永远等不到。
    - 进堵转时记住 PC2/PC3 当时的电平 s_key_prev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
2026-11-07 按键改成**高电平有效**（按下=3.3V）：PC2/PC3 配下拉、读高（FW=2122）
    用户澄清："按钮要读高电平，也就是 3.3V，我搞错了"。
    和日志完全对得上：按键空闲时 k1=0（板上是下拉），按下才给 3.3V。
    - ctrl_io_init：PC2/PC3 由 GPIO_PULLUP 改成 GPIO_PULLDOWN（松开=0、按下=1）；
    - ctrl_key()：由"低=按下"改成"高=按下"；
    - 头文件注释同步。
    于是堵转后的重启链路恢复：
    堵转 2 秒 -> 关电机 -> 按 PC2/PC3（3.3V）-> 回闭环 500RPM。
    （另外 q <非零> 仍然可以清堵转，作为按键坏了时的备用手段。）
    FW=2122；Keil 0 error 0 warning。
    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
    [cmd_f4.c, ctrl_f4.c, ctrl_f4.h]
2026-11-07 按功能拆分 ctrl_f4.c：电机/编码器/舵机/PID/保护/OLED/按键/IMU 各自一个文件（FW=2123）
    原来 ctrl_f4.c 一个文件 1863 行，混着 9 个模块。按用户要求拆成：
    motor_f4.c 102 行 电机 PWM(TIM2_CH3/4) + 方向(PB0/PB1)
    encoder_f4.c 109 行 编码器 TIM5 正交 + PC0 Z 相；ctrl_encoder_tick(dt_us)
    servo_f4.c 610 行 幻尔 HX 舵机（UART4）；状态机搬到这里 ctrl_servo_tick()
    pid_f4.c 167 行 速度环 PI+前馈+斜坡 + 开环/闭环切换；ctrl_speed_tick()
    protect_f4.c 127 行 全局堵转判据 + 按键重启；ctrl_protect_tick()
    oled_f4.c 425 行 SSD1306 驱动 + 状态页；ctrl_oled_status()
    io_f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
2026-11-07 gitignore: 忽略 tools/log_*.txt（上位机记录文件）、build_log、.workbuddy
2026-11-07 默认不转 + 二值化改手动阈值（默认 100）+ 上位机【阈值】按钮（FW=2124）
    1) 默认转动模式 = PID 闭环，但**上电不转**：
    CTRL_RUN_AUTO_START 1 -> 0。上电只初始化，等上位机发 q <rpm>（闭环）或 w <duty>（开环）。
    上位机默认仍是"转速闭环"模式（滑条 500）。
    2) 二值化不再用自动 Otsu，改成**手动固定阈值**：
    - cam_f4.c 新增 volatile uint8_t cam_thresh_manual，**默认 100**；
    - board_cam_analyze()：手动 != 0 时直接 T=手动值，**连直方图都不算**（省约 2ms/帧）；
    为 0 时才走原来的 Otsu（保留对比用）；
    - 命令 h <n>：0=自动，1..255=手动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
2026-11-07 上位机阈值改成**加减 1**的两个按钮（原来是一键循环档位）
    用户要求："阈值切换做成加减法的那种，进位为 1"。
    - 去掉 THRESH_STEPS 档位表，改成一个数值 self.thresh_val（默认 100，和固件一致）；
    - 图像源面板第 3 行： [阈值 −1] 阈值 100 [阈值 +1]
    每点一下 ±1，范围 1..255（到边界不再变），立即发 h <n> 并等 ACK th；
    - 连点没问题：同前缀（ACK th）的新命令会顶掉还没确认的旧命令，不会堆积；
    - 固件那边 h 0 仍然是自动 Otsu，只是按钮不会走到 0。
    只改了上位机，固件不用重烧。
    [car_ui.py]
2026-11-07 上位机加【曝光 −5 / +5】按钮（固件本来就支持运行时改曝光，不用重烧）
    用户问："曝光可以动态调节吗？" —— 可以，e <n> 收到即写 SCCB R0x0B，下一帧生效。
    只是每次手打命令麻烦，所以在【图像源】面板加了和阈值一样的加减按钮。
    - 范围 10..110 行（一帧 120 行，必须小于它），默认 100；
    - 每点一下 ±5，发 e <n>，回执 ACK e: shutter=<n> rows；
    - 面板现在四行：二值图/原图灰度、停/恢复图传、阈值−1 值 阈值+1、曝光−5 值 曝光+5。
    只改上位机。
2026-11-07 曝光下限 10 -> 1（固件 + 上位机一起改）（FW=2125）
    用户问"曝光最低是 10？" —— 那是当初我设的安全下限，不是硬件限制。
    R0x0B 是"曝光行数"，1 行 = 最短曝光（最暗）。
    - cmd_f4.c：e <n> 的夹取范围 10..110 -> **1..110**；
    - cam_f4.c：cam_shutter 注释改成"范围 1..110，1 = 最暗"；
    - car_ui.py：EXPO_MIN 10 -> 1（按钮能一直减到 1）。
    注意：曝光调到很小（1~10）时画面会很黑，白赛道也可能变灰，
    这时阈值要跟着往下调（th 60 之类），否则二值图会全黑。
    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
    [car_ui.py, cmd_f4.c]
2026-11-07 e <n> 写完立刻回读，用来自证"曝光到底有没有写进去"（FW=2126）
    用户："感觉动态调节曝光没生效"。
    怀疑两种：① SCCB 根本没写进去（但命令照样回 ACK）② 写进去了，但 5% 的变化在二值图上几乎看不出来。
    改：case 'e' 现在写 0x0B 之后马上回读，ACK 里三个数：
    ACK e: shutter=95 wr=0 rd=95(0) OK
    shutter = 下发的值
    wr = 写函数返回值（0 = SCCB 正常应答）
    rd(x) = 回读到的寄存器值(x = 读函数返回值)
    OK / MISMATCH! = 三者是否一致
    差别：
    - 如果 MISMATCH 或 wr!=0 => SCCB 写入失败（接线/地址问题），换曝光路径没用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
    [cmd_f4.c]
2026-11-07 对照实验：默认曝光 100 -> 50，并在 CFG 里报出"初始化时回读到的快门"（FW=2127）
    用户："原图模式看亮度没有变化，你试试直接默认曝光 50"。
    - cam_f4.c：cam_shutter 默认 100 -> **50**；
    - cmd_f4.c：CFG 行末尾加 SH=<cam_r0e>，即 cam_bin_setup() 里
    "写完之后回读 R0x0B" 得到的值 —— 正常应该等于 50（0x32）；
    - car_ui.py：EXPO_INIT 也改成 50，按钮显示和固件一致。
    这个实验能一刀切开两种情况：
    A) 烧完画面**明显变暗** => 初始化路径（cam_bin_setup 里写 R0x0B）有效，
    那么 e 命令没效果就是**运行期写入**的问题（被模块覆盖或 SCCB 时序）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
    [car_ui.py, cmd_f4.c]
2026-11-07 找到曝光无效的真正原因：**51 拆掉后传感器自动曝光(AEC)是开着的**，会把 R0x0B 覆盖掉（FW=2128）
    依据逐飞 TC264 库 zf_device_mt9v03x.h：
    #define MT9V03X_AUTO_EXP_DEF (0) // 自动曝光，**默认不开启**，范围 [0-63]，0 = 关闭
    #define MT9V03X_EXP_TIME_DEF (512) // 曝光时间
    自动曝光为什么"默认不开启"？是**板上那颗 51 在开机时用配置协议关掉的**。
    用户把 51 拆了 ⇒ 上电走传感器默认值 ⇒ **AEC 开着** ⇒ 亮度由它自己调节
    ⇒ 我们写 R0x0B（快门）当然看不出任何变化（也会解释"初始化写 50 也不变"）。
    - cam_bin_setup()：写 R0x0B 之前先 **R0x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
2026-11-07 撤回 R0xAF 的写入：写 0xAF=0 会把图像弄没（FW=2129）
    现场：烧 2128（写 0xAF=0 想关 AEC）后**接收不到图像**。
    结论：0xAF 在你这颗传感器上**不是 AEC**（很可能是 PLL/时钟相关位），
    写 0 把像素时钟关掉了 -> 没有 PCLK/VSYNC -> DCMI 一帧都收不到。
    （TC264 库里也查不到 0xAF 的用法，SCCB 那部分实现不在源码里。）
    - 删除所有 cam_sccb_write_reg(0xAFU, 0U)（cam_bin_setup 和 e 命令两处）；
    - 0xAF **只读**，值放进 CFG 的 AE= 里当参考，绝不再写；
    - 其它保持 2127 的状态（默认曝光 50、e 有 wr/rd 回读、CFG 有 SH/AE）。
    烧 2129 图像应该就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
2026-11-07 把摄像头初始化退回到 2126（唯一确认"能出图"的那版），彻底不再碰 R0xAF（FW=2131）
    用户反馈："重新上电后还是没有图，我没动硬件，是你的代码问题"。
    承认：2128 写 0xAF 是我的错。2129 只删了写、还留着读，图也没回来 ⇒ 读也可能有影响。
    现在 cam_f4.c 和 2126（能出图的那版）**逐行对比只剩一段注释的差别**：
    - 删掉 cam_sccb_read_reg(0xAFU, ...)（读写都不做了）
    - 删掉 cam_ae 变量
    - cam_shutter 恢复 100U（和 2126 一样）
    其它（初始化顺序、R0x0D bin4、R0x0B 快门、回读验证）全部和 2126 一致。
    同时把 CFG/ACK 里那个已经没意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
    [board_f4.h, cmd_f4.c]
2026-11-07 按 MT9V034 数据手册关掉 AEC/AGC，曝光终于可控（FW=2132）
    【手册依据】《MT9V034-数据手册》
    Table 8: R0xAF = "AEC/AGC Enable"，**上电默认 0x0003**（AEC 和 AGC 都开着）
    第 39 页: AEC Enable bit0 = 1 开 / 0 关
    第 61 页: "When AEC is disabled (R0xAF[0]=0), the sensor uses the manual exposure
    value in coarse and fine shutter width registers."
    Table 7: R0x0B = Coarse Total Shutter Width（手动曝光值）
    => 写 R0x0B 一直"没反应"的根因就是 AEC 开着：它每帧把曝光改回自动值。
    => 顺序必须是 **先 0xAF=0，再 0x0B=快门**。
    【上次"没图"的真相】不是 0xAF 写坏了，而是：AEC 关掉后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
2026-11-07 亮度改用 R0xA5（AEC 目标亮度）控制，彻底不碰 0xAF —— 不出图的问题应该消失（FW=2133）
    用户："就是没图，不是图片全黑，单纯没有图片" => 写 0xAF 确实让传感器停止出帧
    （手册也警告：乱写保留位会让器件进未知状态）。所以 0xAF 从此**永不触碰**。
    【手册 Table 8 的 AEC 全套寄存器】
    0xA5 AEC/AGC Desired Bin 默认 0x003A(58) <= **自动曝光瞄准的画面亮度**
    0xAB Max Analog Gain 默认 0x0040
    0xAC AEC Minimum Exposure 默认 0x0001
    0xAD AEC Maximum Exposure 默认 0x01E0
    0xAF AEC/AGC Enable 默认 0x0003（上电开着，别动）
    关键认识：默认目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
    [board_f4.h, car_ui.py, cmd_f4.c]
2026-11-07 抓包定位到"没图"的真因：AEC 为了变暗会加长曝光，超过 120 行后一帧永远完不成（FW=2134）
    【自己抓的数据】tools 里连上板子抓 12 秒：
    CAM=1 MD=1 BIN=1 R0D=030A SH=100 => 摄像头配置全对，SCCB 通信正常
    EDG=0 DRP=0 => 一帧边缘包都没有（真的是没帧）
    DST=169->196 SELF=33->39 => 板子每 2 秒判定"没帧"，一直在自愈重启
    => 不是"全黑"，是**传感器根本不出帧**。
    【根因】
    我把 AEC 目标亮度调低（0xA5=40，更暗）后，AEC 为了达到更暗的目标会**加长曝光**；
    而一帧只有 120 行（行 bin4），**曝光 >= 120 行 ⇒ 传感器永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
2026-11-07 摄像头初始化回退到 2131（你确认"有图"的那版）：撤掉 0xA5 / 0xAD 的写入（FW=2135）
    【逻辑推理】
    2131 有图 -> 2133/2134 只在初始化里**多写了 0xA5 / 0xAD** 就变成"完全没帧"(EDG=0)。
    => 问题就是这两步写入，不在于阈值/黑图。已全部撤回。
    【现在和 2131 的实际差别】只有两处，都不影响出帧：
    1) cam_thresh_manual 默认 100 -> 0（自动 Otsu）—— 这条是修"二值图全黑"的，保留；
    2) 若干注释。初始化流程（0x0D bin4 + 0x0B 快门 + 回读）与 2131 **完全一致**。
    【e 命令】回到只写 0x0B 并回读（和 2126 一样），ACK:
    ACK e: shutter=<n> wr=<w> rd=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
    [board_f4.h, cmd_f4.c]
2026-11-07 摄像头初始化前先软复位 R0x0C，并在 CFG 里报芯片 ID（FW=2136）
    【抓包证据（FW=2135）】连上板子抓 10 秒：
    BIN=0 => cam_bin_ok=0，**摄像头初始化失败**
    SH=778(=0x030A) => 读 0x0B（快门）却读回 0x0D（读模式）的值 => **SCCB 读数据错位**
    EDG=0 => 一帧都没有
    => 不是黑图，是传感器被前面几次寄存器实验写进了异常状态，SCCB 读数都不对了。
    【改】
    - cam_sccb_set_bin4() 开头先 **R0x0C = 1（软复位）**，等 30ms 再配置；
    - 复位后回读 **R0x00 芯片版本**（MT9V034 应 0x13xx），存进 cam_id_rd；
    - CFG 行末尾加 **ID=%04X**：
    ID=1324 => SCCB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
2026-11-07 SCCB 读写加 8 次重试（抓包证明是**读事务偶发失败**，不是配置值错）（FW=2137）
    【再读一遍抓包（FW=2135）】
    BIN=0 => cam_bin_ok=0，初始化失败
    SH=778 => 其实就是**读 0x0B 失败**：sccb_read_reg 失败时不会改 *val，
    于是 v 还留着上一次读 0x0D 的 0x030A => SH 显示 778
    EDG=0 => 没有帧
    => 结论：不是我们写错了值，而是 **SCCB 事务时好时坏**，导致初始化没做完（bin4 没配上）
    => 传感器仍用默认 480 行快门 > 一帧 120 行 => 永远不成帧。
    【为什么 SCCB 会不稳】这两根线没有外部上拉，只靠 STM32 内部约 40kΩ；
    拆掉 51 后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
2026-11-07 摄像头代码整体退回 FW=2110（你说能稳定读 ID 的那版），只保留"手动阈值"一个功能（FW=2138）
    用户："以前的代码能稳定读取相机的 id，绝对不是硬件问题，就是你的代码问题"。
    => 我不再在改坏的版本上打补丁，直接 git checkout ec947a7 把三个文件退回：
    Core/Src/cam_f4.c
    Core/Src/cmd_f4.c
    Core/Inc/board_f4.h
    然后只手工加回**手动阈值**这一个功能。
    【cam_f4.c 与 2110 的全部差异（已用 diff 核对，无其它改动）】
    1) 新增 cam_thresh_manual 变量；
    2) board_cam_analyze()：非 0 就用手动阈值，为 0 时走原来的 Otsu。
    => **摄像头初始化（SC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
    [board_f4.h, cmd_f4.c]
2026-11-07 加 dr 命令：把传感器 0x00~0x0F / 0x20~0x27 / 0xA8~0xAF 全部读出来（FW=2139）
    【抓包结论（FW=2138，就是退回 2110 那版）】
    ID=1324 BIN=1 R0D=030A => SCCB 正常、bin4 已写进去
    V=0 VS=0 F=0 R=0000 => DCMI 一个 VSYNC 边沿都没收到
    EDG=0 DST/SELF 涨 => 有配置、没帧
    => 传感器"配置上了但不出帧"，所以必须看它内部寄存器的实际值。
    【新增】**dr**（挂在 d 命令下）一次打印 4 行：
    REG0 00:xxxx 01:xxxx 02:xxxx 03:xxxx 04:xxxx 05:xxxx 06:xxxx 07:xxxx
    REG1 08:xxxx 09:xxxx 0A:xxxx 0B:xxxx 0C:xxxx 0D:xxxx 0E:xxxx 0F:xxxx
    REG2 20:xxxx ... 27:xxxx
    REGA A8:xxxx ... AF: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
2026-11-07 找到最可能的元凶：传感器被我留在**复位状态**里（R0x0C 只写了 1，从没写 0）（FW=2140）
    【抓包证据（FW=2138，已退回 2110 代码）】
    ID=1324 SCCB 正常
    BIN=1 bin4 配置成功
    R0D=030A 读模式正确
    V=0 VS=0 F=0 R=0000 => **完全没有 VSYNC**，配置得上但不出帧
    "配置全对、SCCB 全通、就是不出数据" 最典型的原因就是芯片**被按在复位里**。
    【时间线对得上】
    2128/2132 写 0xAF
    2136/2137 我加了 R0x0C = 1（Reset）—— 但**从来没有写过 0 释放**！
    R0x0C 是普通寄存器，**断电前不会自己回 0** ⇒ 传感器一直 reset 着
    ⇒ SCCB 仍然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
    [cmd_f4.c]
2026-11-07 dr 之前没输出，是因为 cmd_txt() 是**单槽缓冲**：连发三次只剩最后一个 "\r\n"（FW=2141）
    上一版 dr 写成了：
    cmd_txt("REG0 "); cmd_txt(b); cmd_txt("\r\n");
    而 cmd_txt() 内部只有一个文本槽（wf_txt_*），没等发出去就被下一次调用覆盖
    => 实际只发出了最后的 "\r\n"，所以抓包里一条 REG 都没有。
    改：每行先完整拼进 b（"REG0 xx:yyyy ... "，8 个寄存器 = 4+64 字符，b 有 96 字节），
    每行只调用一次 cmd_txt(b)，共 4 行：REG0(00-07) / REG1(08-0F) / REG2(20-27) / REGA(A8-AF)。
    另外这一版仍然保留 2140 的复位脉冲（0x0C 先 1 再 0 释放）。
    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
    [cmd_f4.c]
2026-11-07 dr 改成**只发一行** 8 个关键寄存器（FW=2142）
    两版 dr 都没输出的原因：cmd_txt() 是单槽缓冲，同一拍里连发 4 行时
    前 3 行被第 4 行覆盖、第 4 行又可能被遥测/心跳挤掉 => 一个字都出不去。
    现在一次只发一行（4+64=68 字符），挑最关键的 8 个：
    DRG 0B:xxxx 0C:xxxx 0D:xxxx 03:xxxx 04:xxxx 07:xxxx 0F:xxxx AF:xxxx
    0B 快门（应 0064） 0C 复位（应 0000）
    0D 读模式（应 030A） 03 窗口高（应 01E0）
    04 窗口宽（应 02F0） 07 芯片控制（应 0388）
    0F HDR/传感器类型（应 0100） AF AEC 使能（应 0003）
    0xAAAA = 读失败
    Keil 0 error 0 warni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
    [cmd_f4.c]
2026-11-07 真凶确认：dr 抓到 R0xAF=0000（出厂应为 0003），其它寄存器全对 —— 现在显式写回（FW=2143）
    【寄存器快照（2142 实测）】
    DRG 0B:0064 0C:0000 0D:030A 03:01E0 04:02F0 07:0388 0F:0100 AF:0000
    快门100 ✓ 复位已释放 ✓ bin4 ✓ 窗口480x752 ✓ 控制0388 ✓ HDR正常 ✓
    **AF:0000 ✗** <= 出厂 Table 8 是 0x0003（AEC 开、AGC 开），被 2132 那次写成了 0
    而且此后没有任何代码把它写回来（2133 起改的是 0xA5/0xAD，2138 起是回退），
    传感器寄存器在断电前不会自恢复 ⇒ 一直 AF=0 ⇒ **配置全对却完全没有 VSYNC**。
    这正好对上用户说的："从你改那个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
2026-11-07 最后一招：把传感器**整机寄存器写回出厂默认**，再重新配 bin4/快门（FW=2144）
    【现在的实测状态（FW=2143，AF 已恢复 0003）】
    DRG 0B:0064 0C:0000 0D:030A 03:01E0 04:02F0 07:0388 0F:0100 AF:0003 <= 全部正确
    S 行：V=0 VS=0 W=0 R=0000 MI=0000 => DCMI **一行数据都没收到**
    手动发 s 3（恢复图传）/ s 1（二值图）也没用，EDG 仍是 0。
    【手册线索（p63）】
    "STANDBY Control: 传感器在 STANDBY 拉高后，会完成当前帧再关闭数字逻辑、内部时钟、
    模拟电源；此时**两线串行接口（SCCB）仍然可读**。"
    => "SCCB 全通、寄存器可读写、就是不出图" 的典型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
2026-11-07 把 AEC 的曝光上限钉在 110 行以内 —— 对症"PCLK 在跑但一个 VSYNC 都没有"（FW=2145）
    【A/B 对照结果（有实测依据）】
    烧 FW=2110（你信任的那版）后抓包：FW=2110 CAM=1 ID=1324 BIN=1 R0D=030A
    W=0 R=0000 V=0 VS=0 K=4089
    => **2110 也是同样状态**，所以这不是后面那些改动造成的。
    【症状对照代码里记录的老坑】
    "曝光 > 一帧行数（行 bin4 后 = 120）=> 传感器永远完不成一帧
    症状：PIXCLK 连续在跑（PF 有值）但 VSYNC/HREF 一个边沿都没有"
    实测：K=4089（PCLK 在跑） + VS=0（没有 VSYNC） + W=0 + R=0000 <= 完全吻合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
2026-11-07 真 bug：R0x0D 用"读-改-写"，SCCB 读错时把垃圾写回传感器（实测 0D 变成 03FA）（FW=2146）
    【dr 实测】
    DRG 0B:0064 0C:0000 **0D:03FA** 03:01E0 04:02F0 AD:0064 AC:0001 AF:0003
    正确应为 **0D:030A**。0x03FA = [9:8]=11 ✓ [3:2]=10 列bin4 ✓ [1:0]=10 行bin4 ✓
    但 **[7:4]=1111 ← 被写进了垃圾**，读模式坏掉 => 不出帧。
    【根因（代码 bug，不是寄存器配置本身）】
    原来的写法是读-改-写：
    cam_sccb_read_reg(0x0D, &v); // 只要这一次读错，v 就是垃圾
    v = (v & ~0x0F) | 0x0A; // 只改低 4 位
    cam_sccb_write_reg(0x0D, v); // **把垃圾高位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
    [cmd_f4.c]
2026-11-07 0x0D 的读-改-写 bug 已修（R0D 现在是 030A），但仍无帧 => 加"直接数 VSYNC 边沿"的诊断（FW=2147）
    【2146 实测（修完 0x0D 之后）】
    S : FW=2146 R0D=030A BIN=1 W=0 R=0000 VS=0 K=4124
    CFG: EDG=0 DST=1 SELF=1
    => **0x0D 已经是对的 030A**（之前是 03FA 垃圾），但依然一帧都没有。
    【2147 新增】dr 之后会多打一行：
    VSP <hz> Hz (0 = no frame sync on PB7)
    它是**绕开 DCMI**、用 TIM4 直接数 PB7 上 VSYNC 的边沿（数完把 PB7 还给 DCMI）。
    判读：
    VSP > 0 => 传感器确实在发 VSYNC，问题在 DCMI 同步/配置
    VSP = 0 => 这根线上根本没有帧同步（传感器没在出帧，或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
    [board_f4.h, cmd_f4.c]
2026-11-07 加 d<hh> 按地址 dump 寄存器，配合脚本可把 256 个寄存器全读出来（FW=2148）
    用户思路正确：以前能用的代码突然不能用 => 一定是**某个能保存状态的寄存器**被写坏了，
    不会只是我盯着的那 8 个。
    【新增命令】d<hh>：从 0xhh 开始一次 dump 8 个寄存器（一行）
    d00 -> 00..07 d08 -> 08..0F d10 -> 10..17 ... dF8 -> F8..FF
    格式：RGH 00:1324 01:0001 02:0004 ...（0xAAAA = 读失败）
    每行一个 cmd_txt（单槽缓冲只能一次一行）。
    【用法】烧 2148 后我这边脚本会依次发 d00/d08/.../dF8，把 256 个寄存器全部读回来，
    再和 MT9V034 手册 Table 8 的默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
2026-11-07 开机自动 dump 全部 256 个相机寄存器（不用发命令、不用开上位机）（FW=2149）
    【为什么要这样】
    链路被图像流挤死时，命令的回复根本发不出去（实测：发 32 条 dump 命令，一条 RGH 都没回来）。
    所以改成**板子自己吐**：开机后 250ms 一行，共 32 行 ≈ 8 秒，把 00~FF 全打出来。
    - cmd_f4.c：新增公开函数 cam_dump_regs_line(base)，一行 8 个寄存器；
    - app.c 主循环：开机自动调用，rg_i*8 = 0,8,...,248，250ms 一行；
    - 这 8 秒里图传默认是关的（cam_img_off 默认 1），文本有带宽；
    - 仍保留 d<hh> / dr 命令（手动可用）。
    烧完**什么都不用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
2026-11-07 寄存器全表 dump 改成**每 15 秒重复一轮**（FW=2150）
    2149 只在上电后 8 秒内 dump 一次，我连上去时早跑完了（S 行 f=143 说明板子已经跑了一会儿），
    所以这次抓到 0 行 RGH。
    改成：每 15 秒重置一轮，32 行 × 250ms = 8 秒吐完，然后歇 7 秒再重来。
    这样不管什么时候连上去，最多等 15 秒就能抓到完整的一张寄存器表。
    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
    [cmd_f4.c]
2026-11-07 寄存器全表已抓完：**256 个全部正常**；心跳加 DCMI->CR 看外设到底使能没有（FW=2151）
    【全表结果（FW=2150 实测，32 行 RGH 拼出来的）】
    00=1324 01=0001 02=0004 03=01E0 04=02F0 05=005E 06=002D 07=0388
    08=01BB 09=01D9 0A=0164 0B=0064 0C=0000 0D=030A 0E=0000 0F=0100
    AD=0064 AC=0001 AF=0003 （0x18~0x2F 读失败，手册里的保留区，正常）
    => **没有任何寄存器被写坏**，0x0D 也已经是修好的 030A。
    【新线索】这一轮的 S 行里 V 从 0 变成 **1**、IE 从 001E 变成 **001F**
    => DCMI 曾经收到过一次 VSYNC，说明线路大概率是通的，只是没在正常采。
    【2143/2151 改动】**心跳里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
2026-11-07 换回老的 752x480 配置（不做 bin）验证传感器还能不能出图（FW=2152）
    用户要求："换成好的那版再读寄存器" —— 有道理，必须先确认**传感器本身还能不能出图**，
    再谈 188x120(bin4) 的问题。全表已经证明寄存器没被写坏，那就换回最早的配置对照。
    【2152 改动】
    - cam_sccb_set_bin4() 里：
    R0x0D = 0x0300 （不做任何 bin ⇒ 752x480）
    R0x0B = 300 （快门 300 < 480 行）
    R0xAD = 300 （AEC 最大曝光 300）
    - app.c：切模式改回 board_cam_set_mode(0)（752 宽，不是 188）
    【判读】
    烧完我抓心跳：
    W>0 / VS>0 / V>0 => **传感器是好的**！问题出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
    [cmd_f4.c]
2026-11-07 心跳里同时上报**单片机自己的** DCMI + DMA 寄存器（FW=2153）
    用户提醒得对：一直只看摄像头的 256 个寄存器，**MCU 侧的 DCMI/DMA 状态没看**。
    【心跳新增字段】
    CR= DCMI->CR 基准 0x4083 = ENABLE(bit14) + CAPTURE(bit0) + 极性组1
    ND= DMA2_Stream1->NDTR 剩余传输字节数（应在一帧内从 22560/90240 递减）
    DC= DMA2_Stream1->CR 基准含 EN(bit0)=1
    CR 没有 bit0/bit14 => DCMI 外设没使能（启动逻辑问题）
    ND 一直不变 => DMA 没在搬运（没有数据进来 或 DMA 没使能）
    DC 的 EN(bit0)=0 => DMA 通道没开
    三者一起就能确定"数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
    [cmd_f4.c]
2026-11-07 MCU 侧已确认：PCLK 19.8MHz 在跑、DCMI 已使能、DMA 没搬 => 用 GPIO 直接数 HREF/VSYNC（FW=2154）
    【2153 抓到的 MCU 侧数据（关键）】
    MD=0 R0D=0300 K=19801 => 全分辨率配置，**PCLK = 19.8MHz 正在跑**
    CR=00004021 => DCMI: CAPTURE(bit0)=1 + ENABLE(bit14)=1 ✓
    ND=22560（一直不变） => DMA 一个字节都没搬
    DC=02025517 => DMA 通道 EN=1（已使能）
    V=1 VS=0 W=0
    => DCMI 开着、时钟在跑、DMA 使能，就是**没有数据传输** ⇒ 缺 HREF 或 VSYNC。
    【2154 新增】dr 会多打一行：
    PIN HREF=<n> VSYNC=<n> (edges in 20ms)
    用 GPIO 轮询直接数 PA4(HREF)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
2026-11-07 HREF/VSYNC 边沿数直接进心跳（HE=/VE=），不再依赖命令回复（FW=2155）
    【为什么】上两版 dr 的 PIN 行都被文本挤掉了（自动 dump 占了带宽），拿不到。
    现在：每秒用 GPIO 轮询 20ms，数 PA4(HREF) 和 PB7(VSYNC) 的边沿，直接放进 S 行：
    ... ND=<n> DC=<dma> HE=<href边沿> VE=<vsync边沿> LW=...
    并把"每 15 秒重复 dump 寄存器"关掉（只保留开机那一轮），给文本让带宽。
    HE>0 且 VE>0 => 两根线都在跳，问题在 DCMI 同步逻辑（能改）
    HE=0 => PA4(HREF) 这根线上没有信号
    VE=0 => PB7(VSYNC) 这根线上没有信号
    另外这两轮全表对比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
    [cmd_f4.c]
2026-11-07 极性组号 1 -> 3（HSPOL 反了，DCMI 一个字节都不搬）（FW=2156）
    【实测证据（FW=2155，寄存器全对之后）】
    HE=1076 VE=4 => **HREF 和 VSYNC 都在跳**，传感器在正常出帧
    K=21490 => PCLK 21.5MHz
    CR=00004021 => DCMI: CAPTURE+ENABLE 都对，但
    bit5(PCKPOL)=1 上升沿 ✓
    bit6(HSPOL) =0 **HREF 低有效** ✗
    bit7(VSPOL) =0 低有效 ✓
    ND=22560 不动 => DCMI 因极性不对，一个字节都没搬到内存
    【为什么】board_cam_apply_polarity() 的位映射：
    bit0=PCKPOL bit1=HSPOL bit2=VSPOL
    组 1 = 只有 PCKPOL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
2026-11-07 打开极性自动搜索：每 800ms 换一组，出帧就锁定（FW=2157）
    【2156 的进展】
    改 HSPOL 前：CR=4021 V=0/1 ND=22560 不动
    改 HSPOL 后：CR=4061 V=38→40 **VSYNC 中断开始计数了**、f 也在涨
    => 方向对了！但数据还是没进内存（ND 不动、W=0）。
    与其我一个个试 8 组极性，不如用**代码里本来就有的自动搜索**：
    CAM_POL_ROTATE 0 -> 1
    CAM_POL_MODE 4 -> 0（普查模式：每 800ms 换一组，一收到帧就锁定）
    起始组仍是 3（PCKPOL|HSPOL）。
    烧完它会自己把 8 组扫一遍，锁在能出帧的那组上；心跳里 P= 就是锁定的组号。
    我抓 S 行看：P 从 3 开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
2026-11-07 真凶找到：我把 0x20 / 0x24 两个**保留寄存器**写成了自己瞎猜的值（FW=2158）
    【逐项比对手册 Table 8 的结果】
    0x20 Reserved 手册默认 **0x01C1** 实测 **0x0007** ← 我写的
    0x24 Reserved 手册默认 **0x0010** 实测 **0x0002** ← 我写的
    其余差异都是正常的：0x0B 快门是我们设的 0064；0x36/0x48/0x4C 是实时校准值。
    【来源】2144 那版"整机恢复出厂"，我在这张表里写的是：
    {..., 0x0F, 0x20, 0x24}
    {..., 0x0100, **0x0007**, **0x0002**} <= 这两个值是我凭空猜的
    而手册的表里明明是 0x20=0x01C1、0x24=0x0010。
    【为什么后果这么严重】手册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
2026-11-07 摄像头按 GitHub 上那版的做法恢复：188 模式 + 极性第 1 组（FW=2166）
    你确认过：GitHub 上 origin/main 那版是有图的，极性也是对的。对比后差异只有一处：
    · origin/main：board_cam_set_mode(1) + CAM_POL_PRIMER=1（CR=0x4021），
    cam_sccb_set_bin4 只做 R0x0D 读-改-写置 0x0A（列bin4+行bin4）+ 快门 ≤110
    · 本地 HEAD(2158)：mode 0 + 极性轮换（ROTATE=1/MODE=0，根本不会锁定）
    + 一堆"修复"动作（0x0C 复位脉冲、0xAF=3、整表回写、0x0D=0x0300、快门300）
    本次改动（只动摄像头，其余一律没碰）：
    1. cam_sccb_set_bin4 整段换成 origin/main 的原版（去掉那些"修复"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
    [car_ui.py, cmd_f4.c]
2026-11-07 文档：摄像头“没图/图不满/一直跳”排查记录（根因 + 正确配置 + 以后别再犯）
    记下这次踩的坑，免得再犯：
    · A/B 测试的 752 配置留在固件里 ⇒ 行宽错配 ⇒ 斜纹 / 只有 1/4 画面
    · 极性“自动搜索”在 MODE=0 时永不锁定，每 800ms 重写 CR ⇒ 画面跳
    · 给保留寄存器 0x20/0x24 写乱猜值 ⇒ 器件进未知状态、彻底没图
    · 用 (装载值-NDTR) 判断“有没有搬数据”在多圈时是随机小数 ⇒ 误判
    正确配置（origin/main 那版）：R0x0D 读改写置 0x0A、快门≤110、CR=0x4021、mode 1。
2026-11-07 阈值默认改 255 + 边界提取换成「逐行白段跟踪」（FW=2168）
    1) cam_thresh_manual 默认 0 → 255（手动阈值，只把最亮的部分当赛道）
    2) 右边缘算法的问题（实测证据，在上位机截图上按行对过真实二值图）：
    行 96：红线 20.1/136.1 vs 赛道 20.6–136.1 ✓
    行 72：红线 38.9/186.2 vs 赛道 38.9–113.4 ✗ 右边缘跑到画面最右边
    行 66：红线 44.2/107.1 vs 赛道 44.5–107.0 ✗ 右边缘落在赛道内部
    原因：八邻域爬线只认局部的"白→黑"，赛道右侧一出现背景白块/黑缝就顺着别人的边走；
    后面的 lf_dual_fixup 再用平均宽度补边，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
    [cmd_f4.c]
2026-11-07 边界跟踪改成严格 8 邻域连通：收不到就结束，不再估行（FW=2169）
    你在上位机上看到的孤立红点，是我上一版在"找不到下一行"时用上一行位置硬填出来的
    （最多填 4 行）⇒ 隔着黑缝也画出了线，和 8 邻域的定义矛盾。
    现在：
    · 下一行的白段必须和本行区间**有重叠**（8 邻域意义上相连）才继续；
    · 没有重叠 ⇒ 这一侧立刻结束，剩下的行一律 0xFF（上位机不画）；
    · 删掉 LF_LOST_MAX 的"估行"分支，不再做任何外推。
2026-11-07 边界跟踪按用户规则重写：种子=最底行，只往上走（FW=2170）
    · 种子取**最下面一行**：从左数第一个白点 = 左边界，从右数第一个白点 = 右边界
    （去掉"必须穿过画面中心 / 宽度≥10"这些条件）
    · 拿到种子后**只往上走**，删除向下那一遍
    · 每行只认"与上一行区间有重叠"的白段（8 邻域连通），收不到就结束，不估算
2026-11-07 边界取"所有相连白段的并集"，修掉赛道中间黑洞处出现红线（FW=2171）
    现象：赛道中间的黑色孔洞/暗斑两侧出现红线，左右边界一起贴到孔洞边上。
    原因：上一版每行只保留"与上一行重叠最多的一段"，
    孔洞把这一行切成左右两段时，两段都与上一行相连，但只取了一段
    ⇒ 左边界=该段起点、右边界=该段终点 ⇒ 边界缩到孔洞边上。
    改法：所有与上一行区间重叠(ov>0)的白段取**并集**
    · 左边界 = 最早那段的起点
    · 右边界 = 最晚那段的终点
    孔洞/暗斑只成为并集内部的缝隙，不参与边界。
2026-11-07 画面左右镜像（摄像头倒装）+ 保留"相连白段取并集"（FW=2172）
    · cam_copy_whole_frame() 里除了行号翻转，再加列反向：d[c] = s[CAM_TXW-1-c]
    开关 #define CAM_MIRROR 1（0 = 不镜像）
    · 上一版 FW=2171 的"所有相连白段取并集"一起提交（修赛道中间黑洞处出现红线）
2026-11-07 种子行改为"最底行往上数第 5 行"，仍然只往上走（FW=2173）
    · seed row: CAM_H-1 → CAM_H-5（最底 4 行不参与，避免车头/阴影压黑导致的种子偏移）
    · 其余不变：左边界=从左数第一个白点、右边界=从右数第一个白点；
    每行取"与上一行相连白段的并集"；收不到就结束；只往上。
2026-11-07 上位机：直道画红线、弯道画蓝线（+ 状态栏显示"直道/弯道"）
    判定方法：赛道中线 = (左边界 + 右边界)/2。
    直道上中线在画面里是一条直线，弯道上中线会弯 ⇒
    对每行取上下各 9 行的中线做最小二乘直线拟合，
    残差 < 1.6 px ⇒ 直道（红），否则 ⇒ 弯道（蓝）。
    另外：画面下方 40 行里弯道行占比 > 50% ⇒ 状态栏显示"弯道"，否则"直道"。
    阈值都在 car_ui.py：STRAIGHT_WIN / STRAIGHT_TOL / C_STRAIGHT / C_CURVE。
    （这一步只改上位机，固件不用重刷）
2026-11-07 摄像头巡线 → 舵机（直道/弯道用不同前馈），FW=2174
    固件里新增（跟上位机红蓝线同一套判据）：
    · cam_track_eval()：中线=(左+右)/2，对整条中线做最小二乘直线拟合
    残差 <1.6px ⇒ 直道(cam_curved=0)，否则弯道(1)
    同时给出 cam_err_near（近处中线偏差，像素，右正）
    cam_err_dir （远处相对近处的横向偏移 = 拐向，右正）
    · ctrl_steer_from_cam()（servo_f4.c）：
    target = 2748 + SIGN*(KP*err_near + KD*err_dir)
    直道 KD=5 弯道 KD=9（弯道用更大的拐向前馈 ⇒ 提前打舵）
    限幅 1700..3024，每 20ms 最多变 80 步（保护舵机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
2026-11-07 舵机控制改成 PID + 直道/弯道增益调度（FW=2175）
    · 误差 e = 前瞻点(第 100 行)的中线列 - 画面中心列（右正）
    中线用 cam_f4.c 拟合好的直线 c(r)=k*r+b 直接求值 ⇒ 天然看远一点
    · u = KP*e + KI*Σe + KD*(e-e_prev)
    Σe 只在 |e|<20px 时累加、偏离时缓慢泄放，限幅 ±400（第一版不限幅，
    过弯时积分顶到 1500，出弯后舵机被拉了 300 步回不来 —— 实测后修掉）
    · 增益调度：直道 cv=0 用 KP/KD；弯道 cv=1 用 KP_CUR/KD_CUR（D 更大 = 更早打舵）
    · 在线调参（不用重烧）：sg <±1> / sp <kp×10 ki×10 kd×10> / sc <kp×10 kd×10> / vs 0|1
    · 遥测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
2026-11-07 直线 PID 改成"以近处为主"，确保过弯后回到中线（FW=2176）
    问题：过完弯道后车贴着一边跑，不回中线。
    根因：之前 PID 的误差只取**前瞻点(第100行)**——那是"车将会到的地方"，
    不是"车现在偏了多少" ⇒ 直道上会稳定在一个固定偏置上，永远回不到中线。
    另外积分太弱（KI=0.1、限幅 ±400），抹不掉安装/机械中位偏差。
    · 误差 = 近处(第112行) × (1-w) + 远处(第95行) × w
    直道 w=0.20（80% 看近处 ⇒ 一定回到中线）
    弯道 w=0.60（60% 看远处 ⇒ 提前打舵）
    · KI 0.1 → 0.5，积分限幅 400 → 600（能抹掉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
    [cmd_f4.c, ctrl_f4.h, servo_f4.c]
2026-11-07 只看见单边时也能算出正确中线 + 舵机提速（FW=2177）
    1) 急弯时赛道一侧跑出视野，那一边会贴到画面边缘（列 0/1 或 186/187）。
    之前这种行直接被丢掉，剩下的行太少 / 中线被拉到画面中心 ⇒ 偏差被压小 ⇒ 轮子打不动。
    现在 lf_row_center()：
    · 两边都靠谱（左>1 且 右<186）⇒ 取中点，并更新宽度估计 cam_w_est（EMA）
    · 只有左边 ⇒ 中心 = 左 + w/2
    · 只有右边 ⇒ 中心 = 右 - w/2
    ⇒ 急弯时中线该偏多少就偏多少，舵机幅度自然变大。
    2) 舵机太慢：
    · CTRL_SERVO_SPEED 3400 → 9000（步/秒）
    · STEER_SLEW 100 → 400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
2026-11-07 上位机加「视觉打舵」开关面板：开/关 vs + 扫舵测试 st
    · 「开 / 关 vs」：发 vs 1 / vs 0，按钮颜色反映状态，上面一行文字显示"视觉打舵：开/关"
    · 「扫舵测试 st」：发 st，切换固件里的中位±300、每 200ms 换向的扫舵测试
    · 两个按钮都走 send_ack（没回执会重发、回了才恢复颜色），和别的按钮一致
2026-11-07 舵机上限 3024 -> 3300；微分限幅、积分限幅压小（FW=2181）
    · CTRL_SERVO_POS_MAX 3024 -> 3300（上位机 SERVO_MAX 同步改 3300）
    · 微分项限幅（用户反馈"呆在原地一点一点转过去" = 微分在反向抵消）：
    de 单周期限幅 ±5px，微分贡献限幅 ±60 步
    KD 直道 10 -> 6，弯道 16 -> 10
    · 积分限幅 600 -> 200（积分只做微调，不许把舵机顶到限位）
    · 遥测 T 行加 tg=（PID 算出来的目标位置），和 s=（舵机读回位置）对照，
    能立刻分辨"算法算错"还是"舵机没走到"
2026-11-07 出弯压线的真凶：宽度突变时把背景白当成赛道；弯道 P 加大（FW=2182）
    1) 出弯后压线、回不到中线：
    出弯时赛道外侧和背景白连成一片 ⇒ 右边界一下跳到很远 ⇒ 算出的中线也偏到外侧
    ⇒ 控制器以为"已经很正"，就一直贴着线跑。
    现在 lf_row_center()：两边都在但**宽度 > 1.6 × 宽度估计**时，
    看哪一侧相对上一行"跳"得多，就判定那一侧是背景 ⇒ 丢掉它，改用另一侧 + 宽度估计。
    （宽度估计只在宽度正常时更新，不会被背景白带跑）
    2) 弯道打舵角度小：弯道 P 4.5 -> 6.0
    3) 帧率问题澄清：打舵用的是摄像头自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
    [cmd_f4.c, servo_f4.c]
2026-11-07 弯道舵量：加"走向前馈"（斜率），并给宽度估计初值（FW=2187）
    实测数据（车停在弯道里）：en=+11、ef=-89、nc=65
    ⇒ 近处偏右 11px、远处偏左 89px、有效行 65 行
    ⇒ 只靠"偏差"混出来的 e 只有 -39 ⇒ 舵机只给 239 步（约 14°）—— 这就是"角度小"的原因。
    1. 新增**走向前馈**：u += -kff × (中线斜率 k × 60行) / 100
    稳态过弯时偏差可能≈0（车正好压在弯的切线上），但轮子必须一直打着；
    斜率 k 才真正代表"赛道往哪拐、拐多急"。
    当前实测 k≈1.67 ⇒ 前馈约 -220 步 ⇒ 舵机目标从 2509 变成 **2300**（448 步，约 2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
2026-11-07 前馈改用"近处斜率"，不再提前打舵；kff 可在线调（FW=2189）
    问题：弯还没到车跟前，舵就已经打很大 ⇒ 提前转弯、压内弯线。
    根因：前馈用的是**整条赛道**的拟合斜率（含很远那段），远处一弯，斜率立刻变大。
    · cam_track_eval() 额外算一个**近处斜率 cam_line_kn**——
    只用"离车最近的 20 行"（r_hi-20..r_hi）做最小二乘；行数不足才退回整条斜率。
    · 前馈改成用 cam_line_kn ⇒ 弯真正到车跟前时前馈才起来。
    · kff 默认 200（用近处斜率后可以给大一点），`sc <kp×10> <kd×10> <kff>` 可在线改。
    · kp_cur 6.0 -> 5.0。
    实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
    [board_f4.h, cmd_f4.c, servo_f4.c]
2026-11-07 目标转速 300 RPM、堵转判据 150 RPM / 3 秒（FW=2190）
    · CTRL_RUN_RPM 500 -> 300
    · CTRL_STALL_RPM 400 -> 150
    · CTRL_STALL_MS 2000 -> 3000 （CTRL_STALL_TICKS 自动跟着变成 150 拍）
    · 上位机按钮预置 500 -> 300（第一个预设）
2026-11-07 上位机默认转速 500 -> 300（和固件 CTRL_RUN_RPM 对齐）
    · sld_speed 初值 500 -> 300（两处：初始化 + 切回转速模式时）
    · 注释里的"巡航目标 500"同步改成 300
    · 预置按钮第一个已经是 300（上一版改的）
2026-11-07 目标转速 100 RPM、堵转判据 50 RPM；堵转冷却 2 秒（FW=2192）
    · CTRL_RUN_RPM 300 -> 100
    · CTRL_STALL_RPM 150 -> 50（CTRL_STALL_MS 仍是 3000）
    · 上位机：预置按钮 (100,300,800,1200)、滑块初值 100
    · protect_f4.c：远程 `q` 清堵转状态加 2 秒冷却 ——
    实测上位机 `q` 因 ACK 丢失会自动重发（每 250ms），每次重发都把堵转清掉，
    导致"44% 占空比、0 转速"一直转、堵转保护形同虚设。现在进堵转后 2 秒内远程清不掉。
2026-11-07 低速跑不起来：速度环加"死区补偿"+"起转踹一脚"（FW=2193）
    现象：目标 100 RPM 电机根本不动。
    原因：前馈是纯比例（每 1000RPM 给 5000 占空比）⇒ 100RPM 只给 5% 占空比，
    而电机有静摩擦/齿槽，5% 连转都转不起来（300RPM 时 15%，刚好在临界附近）。
    1. 前馈加常量偏置 CTRL_SPEED_FF_OFFSET = 1200（12%）：
    只要目标非 0，前馈就先垫 12%，PID 再在这个基础上修正。
    100RPM ⇒ 前馈 17%；300RPM ⇒ 27%。
    2. 起转"踹一脚"：目标非 0、但实测转速 < 30RPM 持续 400ms ⇒
    占空比至少给到 CTRL_SPEED_KICK_DUTY = 2600（26%），把静摩擦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
    [cmd_f4.c, ctrl_f4.h, pid_f4.c]
2026-11-07 起转宽限 2.5 秒：低速起转不再被判堵转杀掉（FW=2194）
    现象：100RPM 起转"动了一点就被堵转干掉"——电机要 1~2 秒才真正转起来，
    而堵转判据是 3 秒低于 50RPM，几乎没给它加速的时间。
    改法：CTRL_STALL_GRACE_MS = 2500
    目标由 0 变非 0 后的 2.5 秒内**不计堵转**（计数器清零并直接返回），
    之后才按"低于 50RPM 持续 3 秒"判。
2026-11-07 占空比上限 50%、起转踹 40%，且只在起转后 800ms 内踹（FW=2195）
    · CTRL_SPEED_DUTY_MAX 8000 -> 5000（50%）
    · CTRL_SPEED_KICK_DUTY 2600 -> 4000（40%）
    · 踹的时机改成"只在开始"：
    目标由 0 变非 0 的那一刻开始计时，之后 CTRL_SPEED_KICK_WIN_MS=800ms 内
    占空比至少给 40%；窗口一过就再也不踹（转速掉了也不踹，交给 PID / 堵转保护）。
    目标回 0 时复位，下次启动重新踹。
    · 踹完再夹一次 DUTY_MAX，保证任何参数组合都不会突破上限。
2026-11-07 起转踹的窗口 800ms -> 2400ms（加长 3 倍，FW=2196）
    · CTRL_SPEED_KICK_WIN_MS 800 -> 2400
    · 其它不变：踹 40%、占空比上限 50%、起转宽限 2.5 秒、堵转 50RPM/3 秒
2026-11-07 速度环增益加大，100RPM 起转后能快速拉到目标（FW=2197）
    症状：电机被"踹"起来了，但转速爬得很慢、迟迟到不了 100RPM。
    原因：Kp=1.5、Ki=0.15 是按 500RPM 调的；在 100RPM 附近误差只有 100，
    P 项只给 150 占空比（1.5%），积分每拍只加 15，要好几秒才攒够。
    · CTRL_SPEED_KP_X1000 1500 -> 2500（Kp 1.5 -> 2.5）
    · CTRL_SPEED_KI_X1000 150 -> 450 （Ki 0.15 -> 0.45）
    · CTRL_SPEED_I_LIMIT 2500 -> 3500
    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
2026-11-07 环岛识别：白区里夹黑岛=环岛/宽白区，进该模式就直走（FW=2198）
    现场：车前是环岛（中间一块黑色圆岛，车要绕过去），最前面白墙也被拍进来。
    实测静止帧：靠近车的行白地宽到 155px（正常 120px），右边一直白到画面外，
    38~56 行夹着 41~44px 宽的黑岛。旧逻辑在这张画面上连错三处（已用 PC 复刻验证，
    en/ef/nc 与板子发回的完全一致）：w_est 被拖到 60、单边行补中心把第 115 行算成 48
    （本该 113）、拟合出歪线 res=27 还误判弯道 cv=1。
    新增：
    - rb_detect()：行内'白-黑-白'且黑缝 >=14px、两侧各 >=8px 白 ⇒ 岛；
    靠近车的行白宽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
2026-11-07 环岛逻辑默认关 + 岛判据改成"垂直连通成块"（FW=2199）
    现象：加了环岛逻辑后车只会直走，弯道直线全废。
    证据：那次跑 336 条遥测 **全部 rb=1**（一次都没退出 wide 模式），iw 经常 60~83px。
    根因：第一版判据是"某一行里有 >=14px 的黑缝就算岛"。这个场地白地外面到处是黑，
    白-黑-白 太容易成立（实测一帧里第 46 行就有 60px 的假洞），于是 cam_wide 一进去就出不来
    （退出条件里的"开阔区"又太松），舵机被锁死在直走。
    - 岛必须**垂直连通成块**：相邻两行的洞在 x 上重叠 >=50% 才算同一块，块高 >=6 行、
    最宽 >=20px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
2026-11-07 去掉误提交的临时文件
2026-11-07 gitignore: 帧存盘目录统一成 tools/frames_*/
2026-11-07 环岛判据改成"形状"：白地被一块黑岛夹断，垂直连通成块才算（FW=2200）
    用户口径（21:56）："环岛中间就是直线，所以有开头就可以了"
    ⇒ 只认**入口**那一下，之后保持直走 2 秒，不需要精确跟踪/退出。
    判据（在 3000+ 张实拍帧上量的，见 tools/rb_shape.py）：
    - 逐行找"白-黑-白"：黑缝 >=14px、两侧白各 >=8px、**两侧白都不许贴画面边**
    - 这些缝按行**垂直连通**（重叠 >=50% 上一行的洞）成一块
    - 块像"岛"：高 >=6 行、最宽 >=20px、最宽那行的洞心在画面中段 35..155
    - 块**没有一直连到画面下面**（连到底的是赛道外的黑）
    - 块下面 5~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
2026-11-07 去掉临时提交信息文件
2026-11-07 回退到环岛之前那一版（FW=2197）
    用户：'还是转不了弯，回到环岛前的那一版吧'
    做法：把固件源文件整份退回到 610bc44（环岛逻辑一个字节都没留）
    Core/Src/cam_f4.c / servo_f4.c / app.c / cmd_f4.c / Core/Inc/board_f4.h
    tools/car_ui.py（去掉界面上'环岛'那一行和'环岛直走 rb'按钮）
    这样板子里的行为和 610bc44 完全一致：没有 rb 命令、没有 cam_wide、没有环岛判据，
    遥测也没有 rb=/iw=/ih= 字段，舵机只按原来的巡线 + 直道/弯道 PID 走。
    顺带清掉误提交的垃圾文件（=14px、tools/ccl_*.png、tools/frames_round2/ 等）。
    环岛的**离线分析工具**留在 tools/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
2026-11-07 清掉临时文件
2026-11-09 WiFi 连不上：手机热点换网段了，电脑 IP 变成 192.168.103.77（FW=2201）
    现象：板子连不上上位机。
    查出来的原因：
    电脑现在 WLAN 是 **192.168.103.77**（热点 SSID 还是 iQOO Neo9S Pro+，没变），
    而固件里写死的是 **192.168.212.77**（11-07 那天的网段）
    ⇒ 板子开机后一直在连一个不存在的地址，当然连不上。
    别的都正常：上位机在监听 0.0.0.0:8086、Windows 防火墙三个配置全是关闭、SSID 也对得上。
    - `WIFI_PC_IP` 改成 192.168.103.77（作为兜底）
    - `WF_PC_USE_FIXED` 1 → **0**：改成**自动推导**——用"模块自己 IP 的前三段 + 末段 77"
    当电脑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
2026-11-09 清临时文件
2026-11-09 修 WiFi 抖动（我上一版的锅）+ 修"有时候整幅图全白"（FW=2202）
    一、WiFi 反复"已连接 → 对方断开 → 已连接"
    上位机日志端口在 6666/6667/6668 乱跳 = 模块在**反复新建 socket**。
    根因：2201 里我在 wifi_f4_retry() 加过"推导 IP 连不上就再连一次写死的 IP"。
    但实际是"模块已经把 TCP 连上了、只是我们握手没等到 ACK"（代码里早有注释的坑），
    于是第二条 CIPSTART 把**已经连好的 socket 拆掉**，去连一个不存在的地址
    ⇒ 上位机看到断开 → 板子又重连 → 无限抖动。
    处理：撤掉那段，恢复"只连 wf_pc_ip 一个地址"。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
2026-11-09 恢复摄像头（软复位 + 写回默认值），并确认这台是"拆掉 51"的版本（FW=2205）
    用户两条关键指正（都对）：
    1. "我的摄像头是拆掉 51 芯片后的版本" ⇒ 模组**没有 EEPROM、没有串口配置**
    （CST=0 / RV=000000 是正常的），参数只能靠 SCCB 直接写，cam_sccb_set_bin4() 就是全部配置。
    2. "既然改寄存器能靠复位刷新，为啥改回来要断电？说明改寄存器就不需要断电"
    ⇒ 对，2202 写坏的那几个 AEC 寄存器，**用寄存器写回来就行**，不用断电。我上一条说"必须断电"是错的。
    修法（照 MT9V034 手册 P62「0x0C (12) Reset」）：
    R0x0C bit0 = Soft Reset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
    [board_f4.h, cmd_f4.c]
2026-11-09 AEC 必须保持开启（两次实测确认）；加 A5/快门回读；实测亮度闭环无响应（FW=2208）
2026-11-09 加弯道专用积分 ki_cur（界面 PID 面板 + sc 第4参数）（FW=2209）
2026-11-09 PID 掉电保存：存内部 Flash 扇区11，开机自动读回；命令 ss/sl/sd + 界面按钮（FW=2210）
2026-11-09 弯道占空比上限提到 80%（修转弯掉速）；补回 out= 那行（FW=2211）
2026-11-10 台架测试模式：保护默认关+开环不判堵转+断链不停+上电自动 40% 占空比；加 pf 命令（FW=2212）
2026-11-10 还原正常版（保护默认开、上电不转）（FW=2213）+ 台架测试版存档文档
2026-11-10 存档 tag 改名：archive-bench-drv888-2212 -> drv测试
2026-11-10 拆出 state_f4.c/h：行驶状态判定+控制量（直道/弯道/没线）独立成文件（FW=2214）
2026-11-10 关掉保活看门狗：不再主动断开/重连（修刷屏式断连）（FW=2215）
2026-11-10 台架测 DRV 模式（含所有链路修复）：保护默认关 + 上电 2 秒后 40% 开环（FW=2217）
    [cmd_f4.c, main.c, pid_f4.c, protect_f4.c, wifi_f4.c]
2026-11-10 还原正常版：保护默认开、上电不转（FW=2218）
2026-11-10 正常版：上电不转、保护开；boot-run 块用 #if 关掉（FW=2218）
2026-11-10 图像翻转改成运行时可调（mf 0..3 + 界面按钮），默认只左右翻转（FW=2220）
